marka87/GRAF_MNP/DOKU-STUFF/DOKU WORK/MIMOT Advantage Nadelschlitten-Prüfstand Beschreibung.docx

Um defekte Nadelschlitten zuverlässig reparieren zu können, bedarf es einer Teststation die möglichst automatisiert den montierten Nadelschlitten auf korrekte Funktionalität prüft und Fehlfunktionen detektiert.

# Mechanischer Aufbau

Es wird ein Gehäuse konstruiert das dem Bestückkopf ähneln kann.

Darin sollen eine Bestücknadel, A-Achse und Spielkiller fest verbaut sein.

Auf dieses Gehäuse kann ein beliebiger Nadelschlitten zur Fehlersuche montiert werden.

Dieses Kopfgehäuse soll an einem primitiven aber stabilen Kopfständer montiert sein, mit einer

ebenen Fläche unterhalb der Bestücknadel.

Diese Ebene soll so weit von der Bestücknadel entfernt sein, dass mit aufgesetztem 1er Doppelloch-Tool und komplett ausgefahrener Nadel noch ein Abstand von ca. 5mm zwischen Tool und Kallibrierfläche herrscht.

Durch positionieren diverser Messklötze auf die Kalibrierfläche, können während der Testroutine verschiedene Bestückhöhen simuliert werden.

# Testroutinen

Vor jedem Testdurchlauf sollen die Z- und die A-Achse referenziert werden.

- Die Z-Achse fährt dazu auf den „Nadel-oben-Sensor“.
- Die A-Achse dreht im Uhrzeigersinn auf Anschlag (Überstromerkennung), speichert den Encoderzähler, dreht gegen den Uhrzeigersinn auf Anschlag (Überstromerkennung) und fährt wieder zurück auf den halben zuvor gezählten Encoder-Wert (Referenzposition).

Die Tests sollen zur Fehlersuche über eine kleine PC-Software einzeln ausgeführt werden können und auch als „kombi-Test“ (alle Testroutinen hintereinander) zur Freigabe eines reparierten/überarbeiteten Nadelschlitten.

Generell solle jeder Test 1000 Zyklen durchlaufen um ein aussagekräftiges Ergebnis zu liefern, zumindest hat Mimot auf deren Testprotokoll 1000 Zyklen.

Folgende Tests sollen automatisiert durchgeführt werden können:

## Z-Achse prüfen (Drucksensor, Z-Encoder, NadelOben-Sensor, Zahnstangenspiel, Motorwicklung)

Die Z-Achse wird vor Referenzierung immer mit einer Hochlaufspannung nach oben angesteuert (Nadelhochlaufspannung)

1. Die Z-Achse wird auf Referenz gefahren (Schrittgenaue Positionierung auf Sensor „Nadel oben“) und die Nadelposition auf „0“ gestellt. Schlägt der Referenzlauf fehl, dann Ausgabe einer Fehlermeldung („Nadel-oben-Sensor schaltet nicht“ o.ä.)

Die Bestücknadel soll eine definierte Anzahl Durchläufe, in verschiedenen Geschwindigkeiten hoch und runter gefahren werden. Die Anzahl der Encoderschritte nach unten und oben soll permanent gezählt werden. Nach Abschluss der definierten Anzahl Durchläufe muss die Summe der Encoderschritte mit der Referenzposition noch immer übereinstimmen (Ansonsten sind beim Encoder Schritte verloren gegangen und es besteht ein Problem -> Fehlermeldung „Encoder verliert Schritte, maximale Abweichung der Referenzposition xy Schritte/mm“)

Der Drucksensor wird während dieses Tests permanent überwacht, und darf einen bestimmten, einstellbaren Wert nicht überschreiten, ansonsten Fehlermeldung („Drucksensor löst ohne Messobjekt aus“)

Am Ende des Tests sollen die wichtigsten Daten ausgegeben werden

- Maximale Abweichung des Test 1 (Schritt-Differenz auf Referenzposition)
- Maximale Veränderung des Drucksensors (mV) während Durchgang.
2. Die Z-Achse wird auf Referenz gefahren (Schrittgenaue Positionierung auf Sensor „Nadel oben“) und die Nadelposition auf „0“ gestellt.

Die Bestücknadel soll eine definierte Anzahl Durchläufe, mit definiertem Bestückdruck (variable Ansteuerung des Druckmotors) mit aufgesetztem 1er Tool, die Kalibrierfläche bzw. Messklotz anfahren bis der Drucksensor anspricht.

Während diesem Vorgang wird die Z-Höhe (Encoderzähler) und Drucksensorspannung jedes Durchgangs in eine Tabelle gespeichert.

Bei zu großer Abweichung (einstellbarer Wert) besteht ein Problem -> Fehlermeldung („Abweichung der gemessenen Bestückhöhe xy Schritte/mm“).

~~Um die Abweichung des t~~~~atsächlichen Aufsetzens der Bestücknadel~~ ~~auf dem Me~~~~ssklotz und dem Schalten des Drucksensors zu messen, wird~~ ~~ein Stromkreis von Bestücknadel auf Messklotz gemessen. Die Abweichung der Anzahl Z-Schritte wird ebenfalls in eine Tabelle geschrieben~~ ~~(„Abstand bis Drucksensor anspricht“)~~~~.~~

3. Zahnstangenspiel prüfen.
4. Wicklungswiderstand über Shunt-Messung bei diversen Z-Höhen ermitteln. Min 10R Max. 50R Nominal 20R

## Drucksensor prüfen

Um den Drucksensor bzw. alle mechanischen Teile (Kugellager etc.) die diesen beeinflussen können, zu prüfen, soll folgende Routine durchgeführt werden.

- Die A-Achse wird eine definierte Anzahl Durchläufe mit einer einstellbaren Variation Bestückdruck (ansteuerung des Druckmotor) vom maximalen + Drehwinkel bis zum maximalen – Drehwinkel gefahren.

Während diesem Durchgang werden alle Veränderungen des Drucksesor-Wert in eine Tabelle gespeichert.

- Wicklungswiderstand über Shunt-Messung bei unterschiedlichen Drucksensorwerten ermitteln. Min 10R Max 50R (Generell), Nominal ~25R (Bei Portscape Druckmotor).

# Protokoll

Am Ende der Testroutine soll ein Protokoll der ermittelten Daten exportiert werden können.

Dieses Protokoll soll enthalten

- Datum, Uhrzeit, Name des Prüfers und Seriennummer des Nadelschlitten
- Checkliste aller notwendigen mechanischen Einstellungen vor Test des Nadelschlitten
- Messwerte der Testroutinen

# Hardware-Anforderungen:

## µC:

- Im idealfall einen State of the Art µC wie z.B. STM32F3 oder STM32G4
- Möglichst viel integrierte Peripherie für die Motoren und Sensoren (z.B. Quadratur-Decoder für Encoder auswertung, etc.) um den Programmieraufwand so gering wie möglich zu halten.
- Analoge Ansteuerung der Endstufenkarten (0-5V)
- Analoge Signalmessung (0-5V)

Erstellt: Immler Dominik © Graf Elektronik GmbH Datum: 01.07.2020 WiDok-Nr.: 00000 3 / 3
