marka87/GRAF_MNP/DOKU-STUFF/DOKU WORK/MIMOT Advantage Nadelschlitten-Prüfstand Elektronik.docx

# Elektrischer Aufbau

## DC-Buchse

DC-Buchse für 24V Netzteil. Versorgung aller Komponenten über Steckernetzteil 24V

## 5V Linearregler

7805 Regler (HA7805-K11) mit Eingangs und Ausgangskondensator für die 5V Versorgung aller Komponenten (Arduino/µC, Nadelschlitten etc.)

## 20 Pin IDC Stecker

Stecker für die Verbindung zum Nadelschlitten (über Flachbandkabel)

Pinbelegung

## Verbindung zu STM32 Nucleo Board (STM32G431KBT6) über onboard Debugger (SWD, JTAG)

## µC I/O Zuweisungen

## „Nicht-Gatter“ SN74HC14N

Das Motortreiber-Modul mit dem L298N hat je H-Brücke drei Inputs.

Über den „EnA“ Pin wird das PWM-Signal zugeführt um die Drehzahlsteuerung zu realisieren.

Über die IC-Pins In1 und In2 wird die Kommutierung gesteuert. Um einen µC I/O Pin zu sparen, wird das Signal eines Ausgangspin zu dem „Nicht-Gatter“ geführt, somit haben wir mit einem Ausgangspin am µC dennoch die notwendigen zwei komplementären Signale für die Kommutierung.

# Berechnungen

## Timer für das Encoderposition-Polling

Der Encoder der Z-Achse soll periodisch abgefragt werden um Positionsänderungen zu erfassen.

Berechnung für die Polling-Intervallbestimmung:

MotMaxRpm = 15.100Rpm (Motor Faulhaber 2842S024C)

EncStepPerRot = 500 N/Rot (Encoder go

HEDS 5500 A HEDS 5500 A)

Berechnung der Maximalen Encoder-Impulse pro Sekunde bei voller Drehzahl:

MaxEncStepPerSec= MotMaxRpm/60sec * EncStepPerRot = ~125.830Rpm

Berechnung des maximalen Encoder –Schrittintervall (

MaxEncIntCalc= 1 / MaxEncStepPerSec = 8µs

Unter der Annahme dass der Motor niemals die volle Drehzahl erreichen kann, da er ja eine Last antreiben muss, wird der rechnerische Wert von „MaxEncIntCalc“ auf 10µs aufgerundet.

Es soll also alle 10µs die Encoder-Position abgefragt werden. MaxEncInt = 10µs

Es soll also ein Timer generiert werden, der bei jedem erreichen des „MaxEncInt“ einen Interrupt auslöst.

Berechnung des Prescalers:

Unter der Annahme dass wir einen 8Bit Timer verwenden um einen „Clear Timer on Compare Match“ (CTC) zu erzeugen.

MaxEncInt / (1 / ClkI/O) = 0,00001 / (1 / 16.000.000) = 160cnt

Es wird also kein Prescaler benötigt, da bereits nach 160 Zyklen eine Messung erfolgen soll.

Dies wird durch den CTC Mode (Clear Timer on Compare) realisiert.

Man lässt den Timer nicht überlaufen, sondern setzt diesen Zurück sobald der Timer den Zählerstand aus dem OCR0A Register überlaufen hat.

OCR0A=1xA0 (1b10100000)

## Mechanische Daten

Z-Achsbewegung Strecke pro Motorumdrehung= 18mm

# Messung Encoder

Die Geschwindigkeit des Encoder-Signals bei 24V Ansteuerung des Motors ist ca . 45kHz.

Die Abtastrate sollte drei mal pro Flanke passieren, sprich 6x 45kHz = 2,7MHz (alle 3,7ns)

Erstellt: Immler Dominik © Graf Elektronik GmbH Datum: 01.07.2020 WiDok-Nr.: 00000 3 / 3
