marka87/GRAF_MNP/DOKU-STUFF/DOKU WORK/Prüfbericht MIMOT.PDF

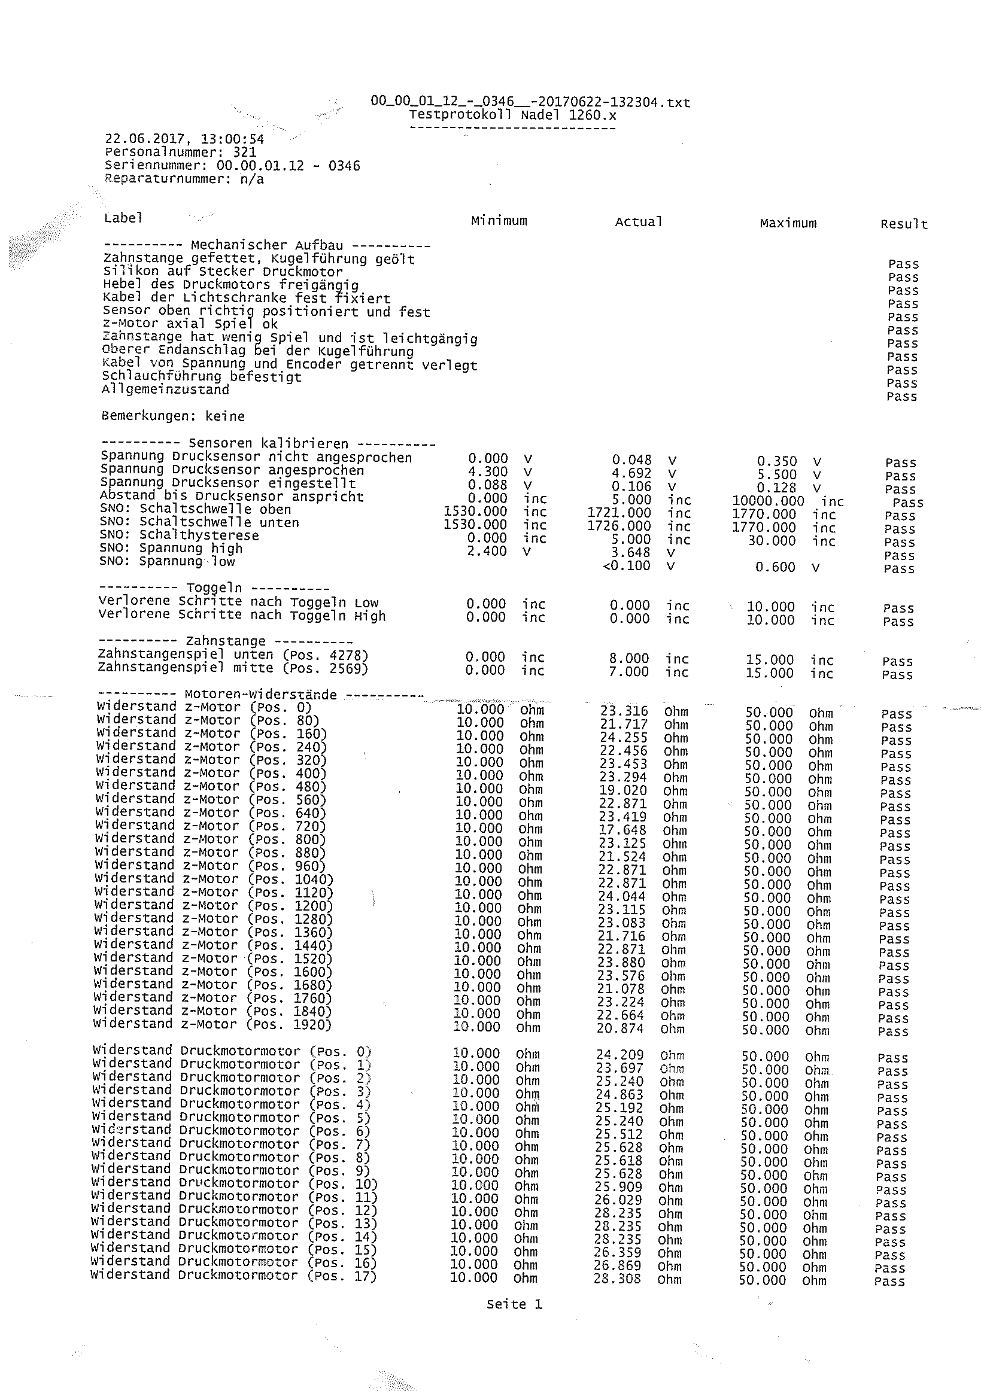
[picture p14: page 1]
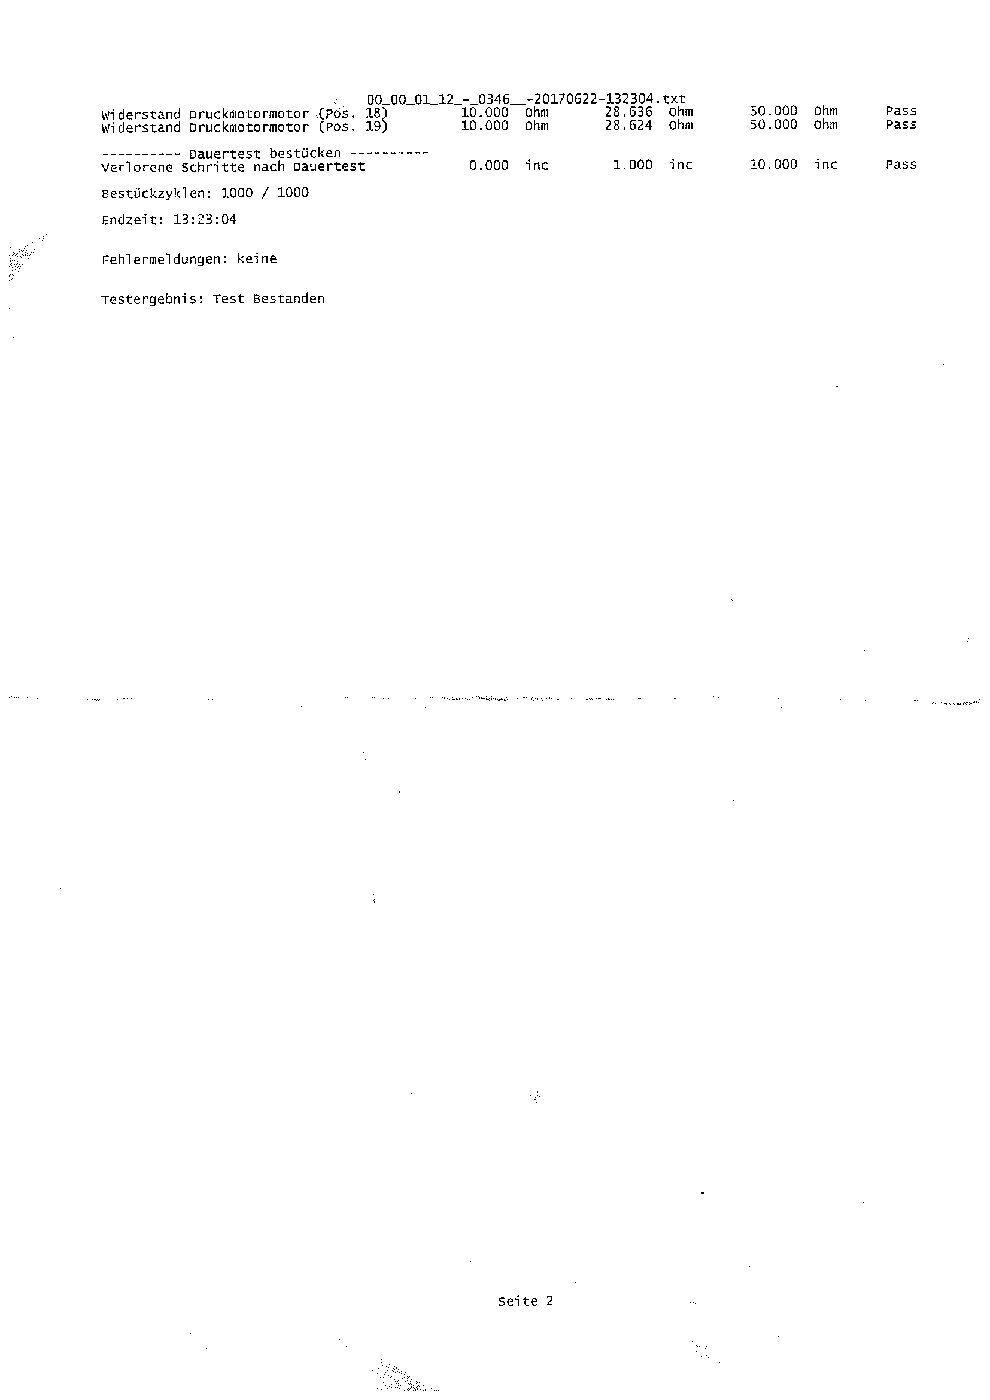
[picture p15: page 2]
