marka87/GRAF_MNP/DOKU-STUFF/2024-11-27 18_06_27-workspace_1.16.1 - GRAF_MNPA_Core_Src_main.c - STM32CubeIDE.png

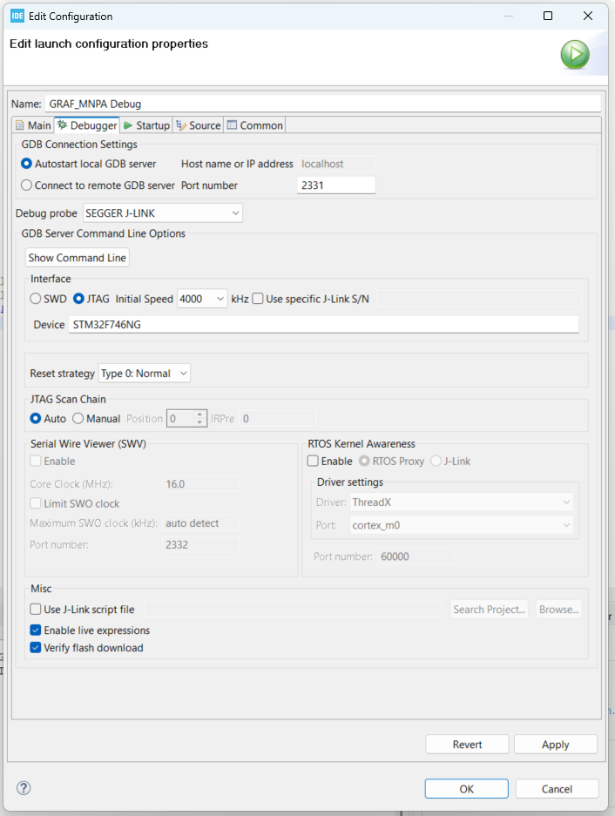
DOKU-STUFF/2024-11-27 18_06_27-workspace_1.16.1 - GRAF_MNPA_Core_Src_main.c - STM32CubeIDE.png
