marka87/GRAF_MNP/DOKU-STUFF/DOKU WORK/Encoder/IMG_3620.jpg

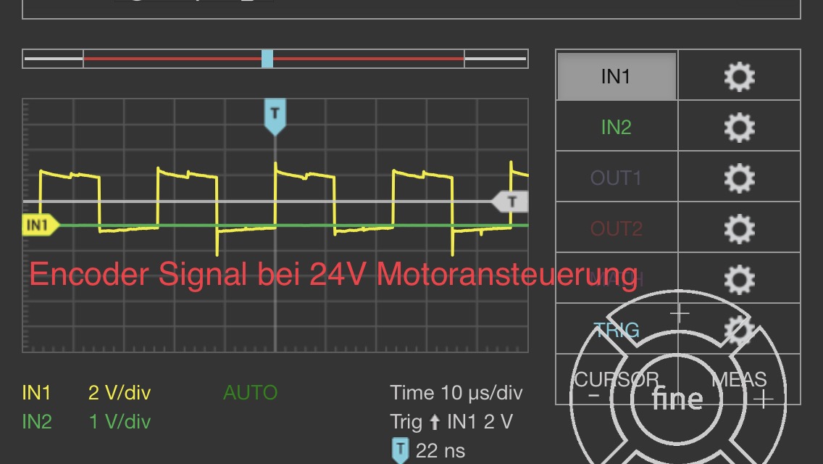
DOKU-STUFF/DOKU WORK/Encoder/IMG_3620.jpg
