marka87/GRAF_MNP/DOKU-STUFF/DOKU WORK/Mimot Endstufen für Ansteuerung/A-Achsen Ansteuerung.sch.jpg

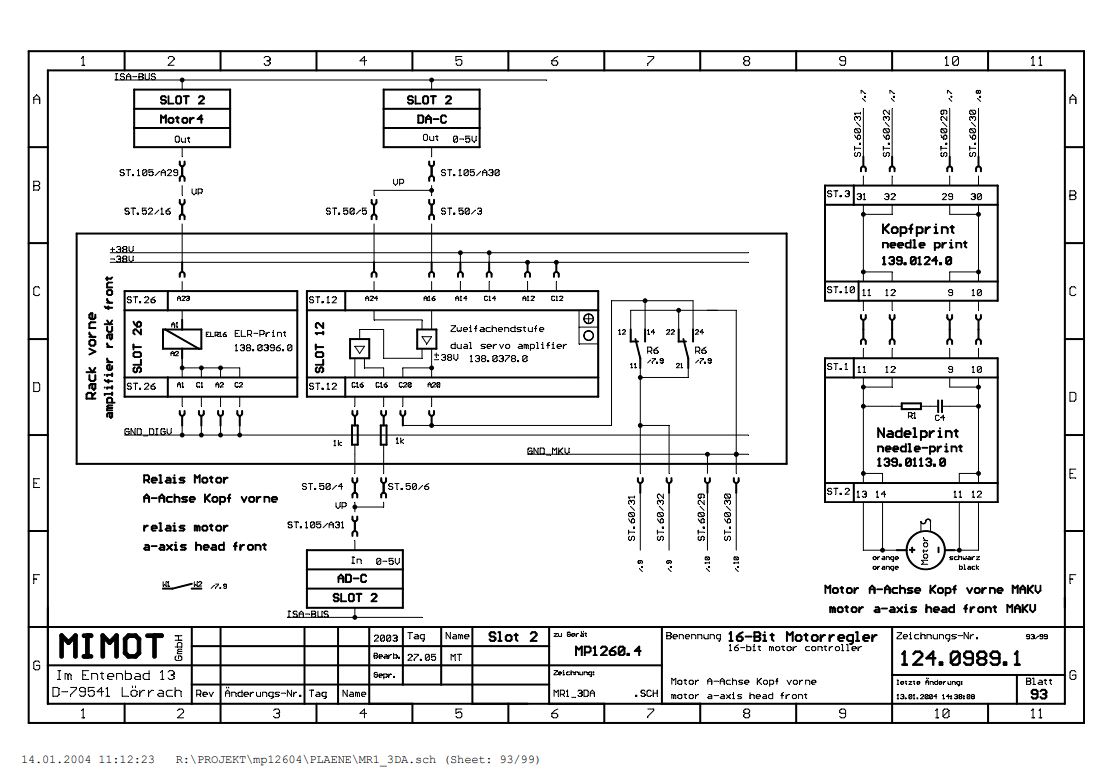
DOKU-STUFF/DOKU WORK/Mimot Endstufen für Ansteuerung/A-Achsen Ansteuerung.sch.jpg
