marka87/GRAF_MNP/DOKU-STUFF/DOKU WORK/Mimot Endstufen für Ansteuerung/Sensor Nadel oben.sch.jpg

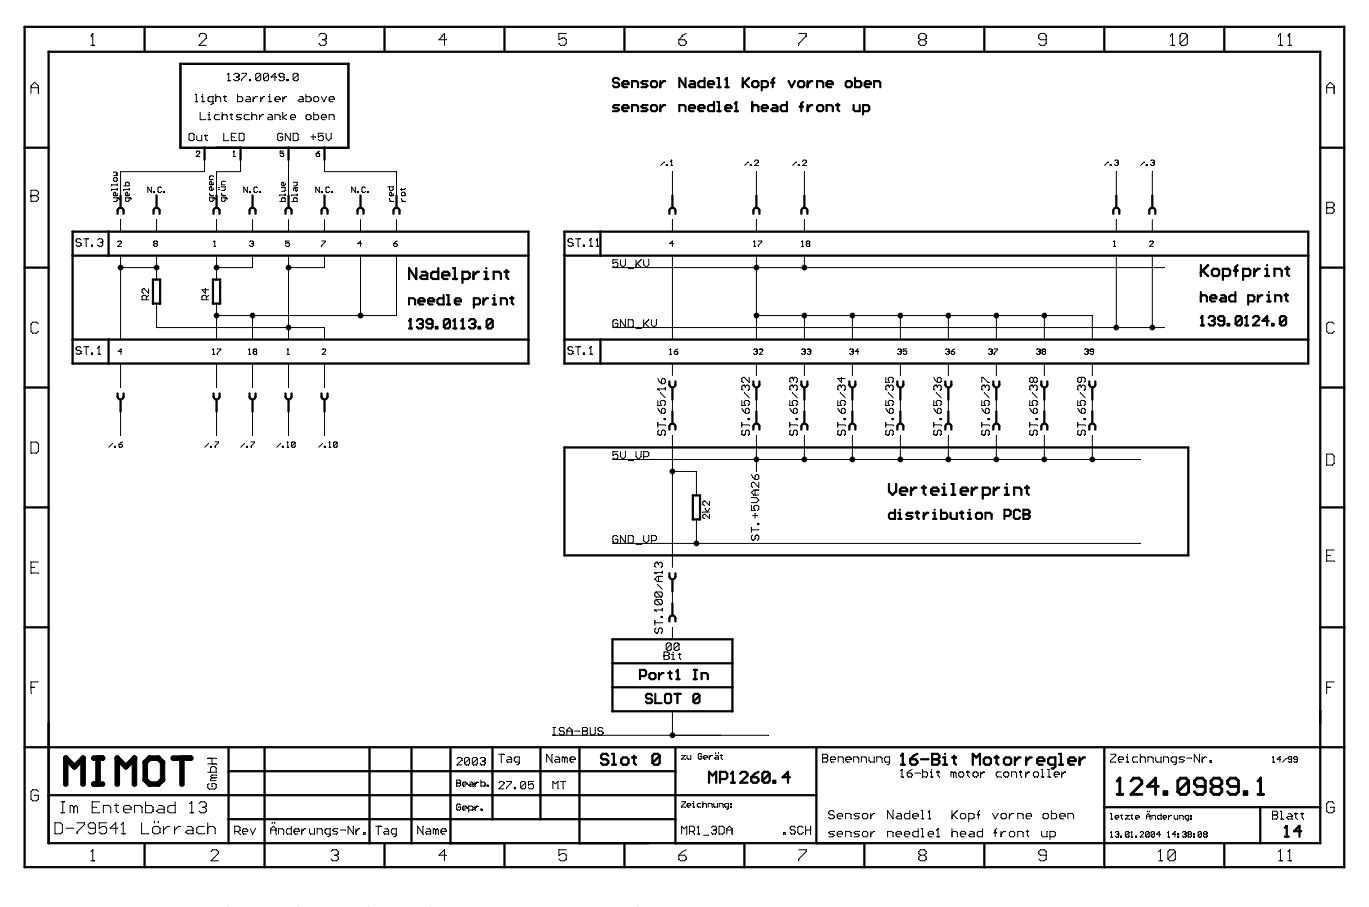
DOKU-STUFF/DOKU WORK/Mimot Endstufen für Ansteuerung/Sensor Nadel oben.sch.jpg
