marka87/GRAF_MNP/DOKU-STUFF/DOKU WORK/Mimot Endstufen für Ansteuerung/Z-Achsen Ansteuerung.sch.jpg

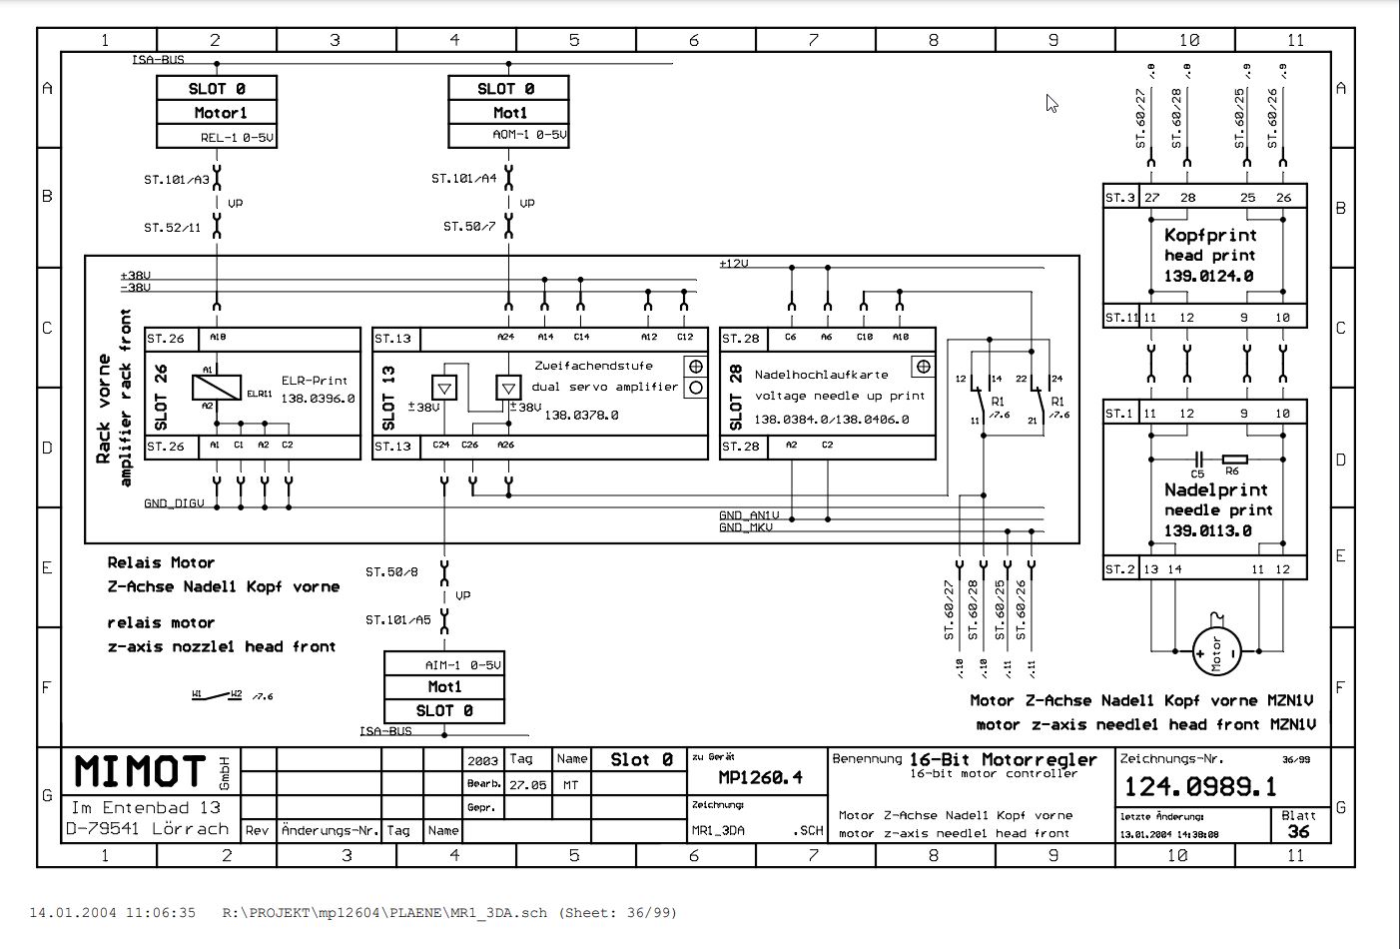
DOKU-STUFF/DOKU WORK/Mimot Endstufen für Ansteuerung/Z-Achsen Ansteuerung.sch.jpg
