marka87/GRAF_MNP/DOKU-STUFF/DOKU WORK/Z-Achsenmotor/2021-03-19 11_36_07-2842S024C Faulhaber Motor _ 2842...C Faulhaber _ DC Kleinstmotoren Faulhaber _ G.jpg

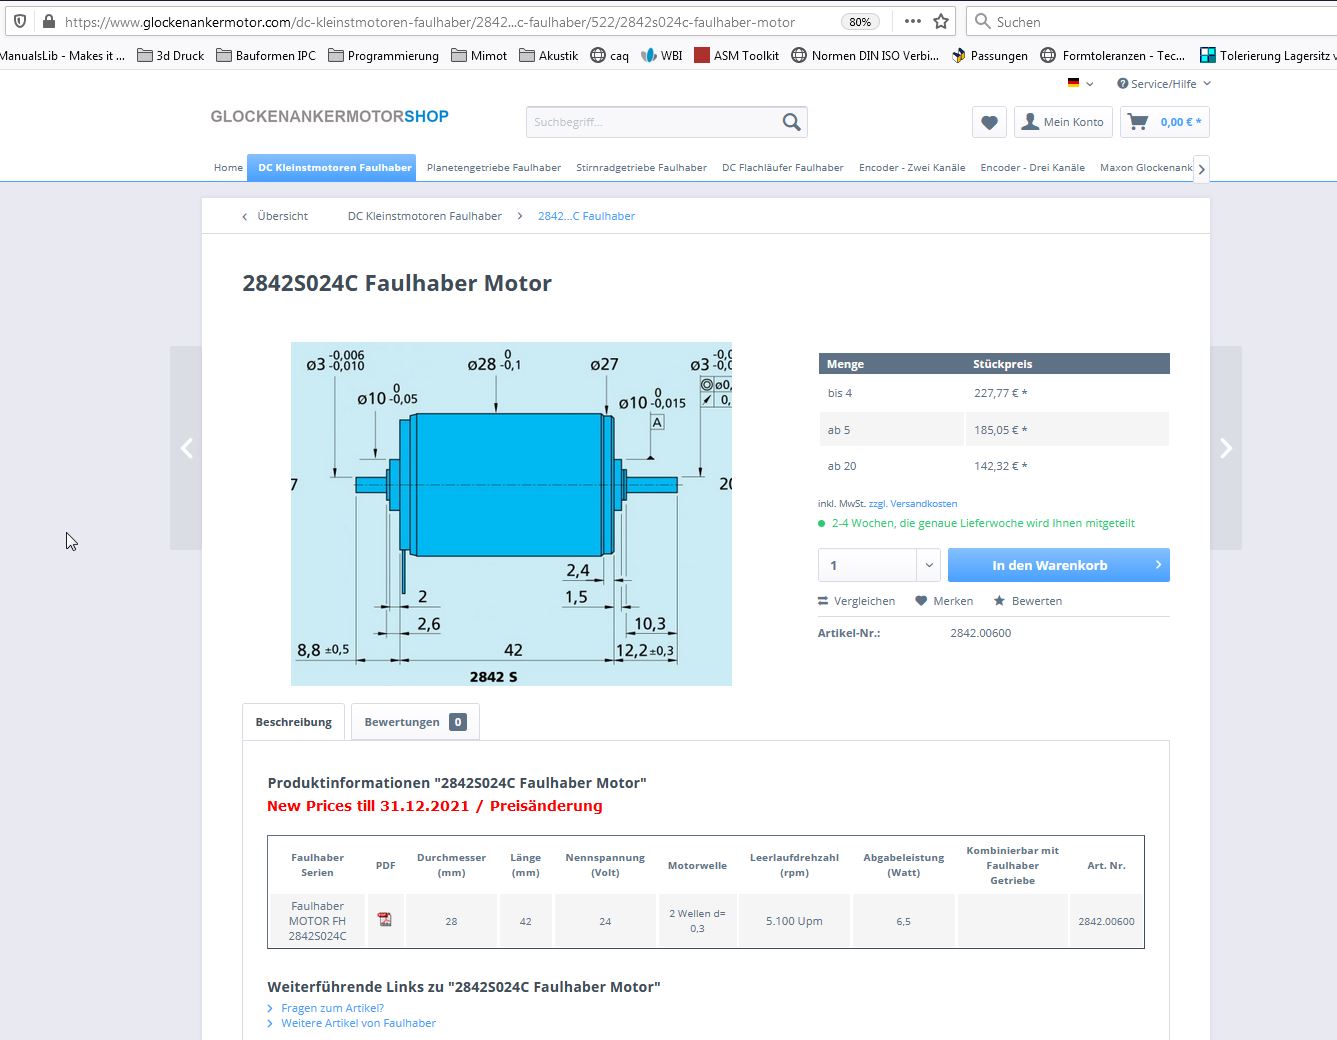
DOKU-STUFF/DOKU WORK/Z-Achsenmotor/2021-03-19 11_36_07-2842S024C Faulhaber Motor _ 2842...C Faulhaber _ DC Kleinstmotoren Faulhaber _ G.jpg
