marka87/GRAF_MNP/DOKU-STUFF/DOKU/usb-c.jpg

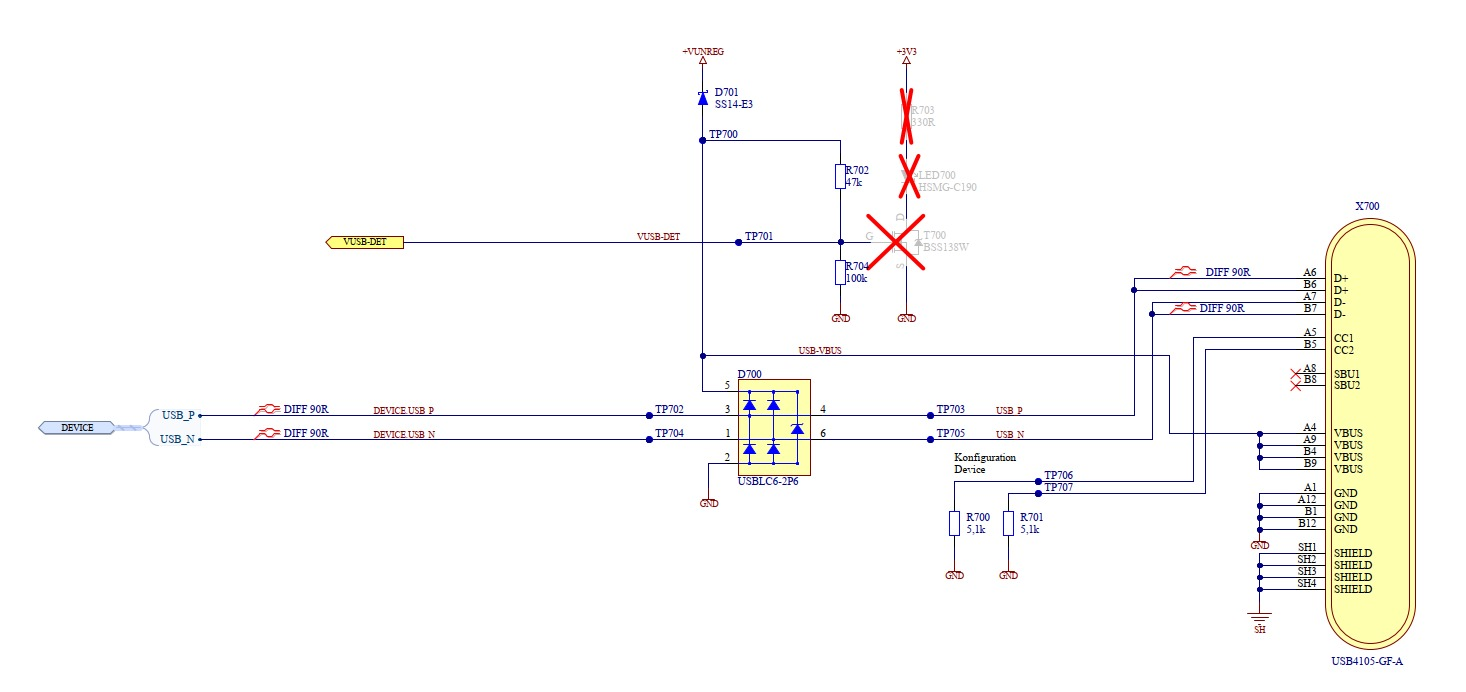
DOKU-STUFF/DOKU/usb-c.jpg
