marka87/GRAF_MNP/DOKU-STUFF/FOTO/START/IMG_4298.JPEG

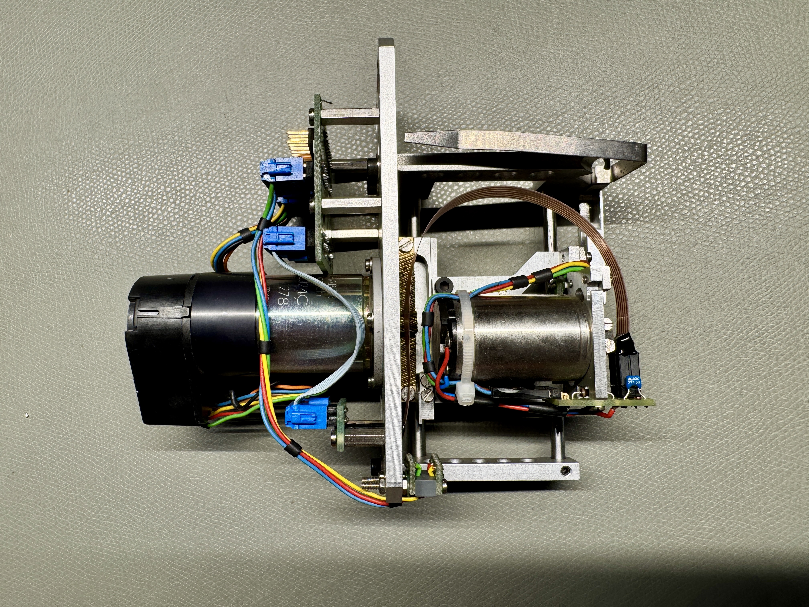
DOKU-STUFF/FOTO/START/IMG_4298.JPEG
