marka87/GRAF_MNP/Elektronik/Powersupply/Download_STEP_971060321 (rev1).stp

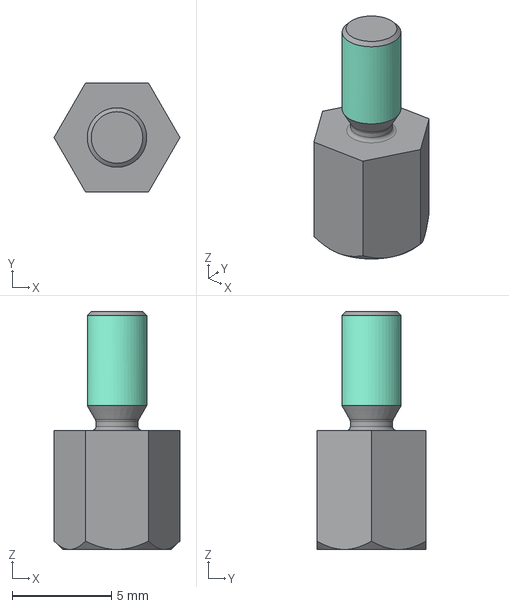
[picture p33: CAD file, 2024-10-14]
Elektronik/Powersupply/Download_STEP_971060321 (rev1).stp
6.35 x 5.50 x 12.0 mm
