marka87/GRAF_MNP/Elektronik/Powersupply/RPS-60.stp

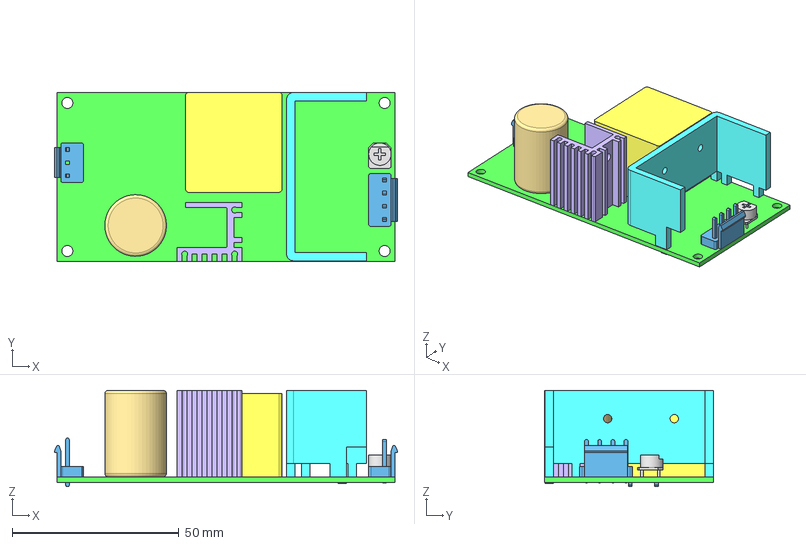
[picture p34: CAD file, 2024-10-14]
Elektronik/Powersupply/RPS-60.stp
103.0 x 50.8 x 28.9 mm
PCB
CN1
PIN_CPY
PIN_CPY_CPY
JS-1120-04
C5
HS-168
HS-172
T1
VR
