marka87/GRAF_MNP/Elektronik/Powersupply/Netzteilprint-Schutzgehäuse.STEP

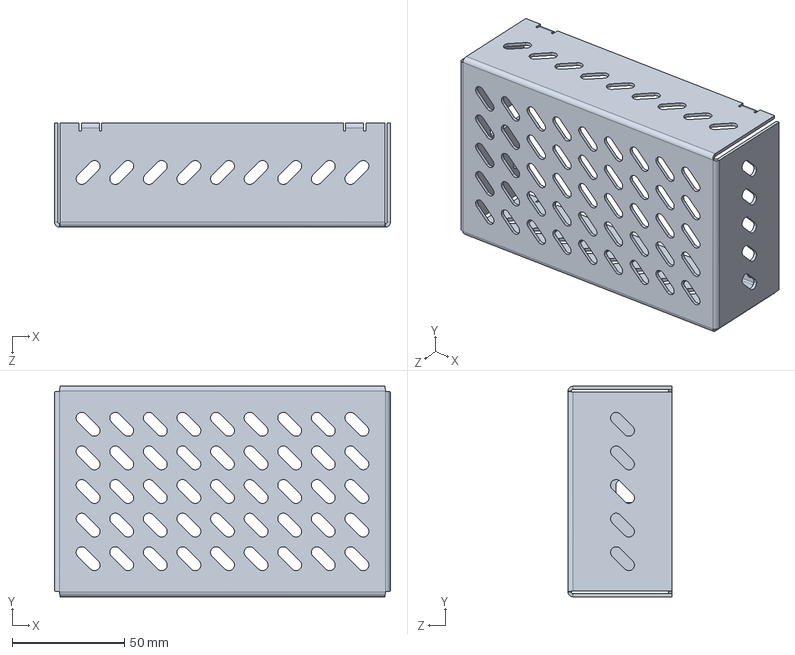
[picture p35: CAD file, 2024-10-14]
Elektronik/Powersupply/Netzteilprint-Schutzgehäuse.STEP
150.0 x 94.0 x 46.5 mm
