marka87/GRAF_MNP/Elektronik/Controller/Outputs/[GRAF-MNP_1.0]/Gerber/[GRAF-MNP_1.0] PCB-SPEC.PDF

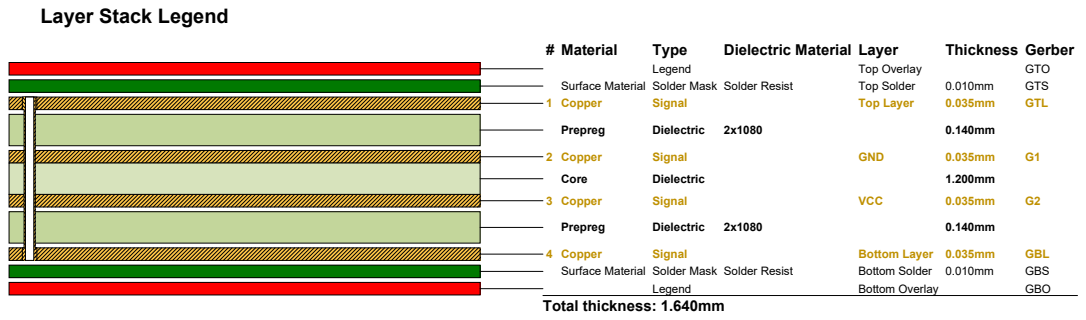
[picture p36: page 1]

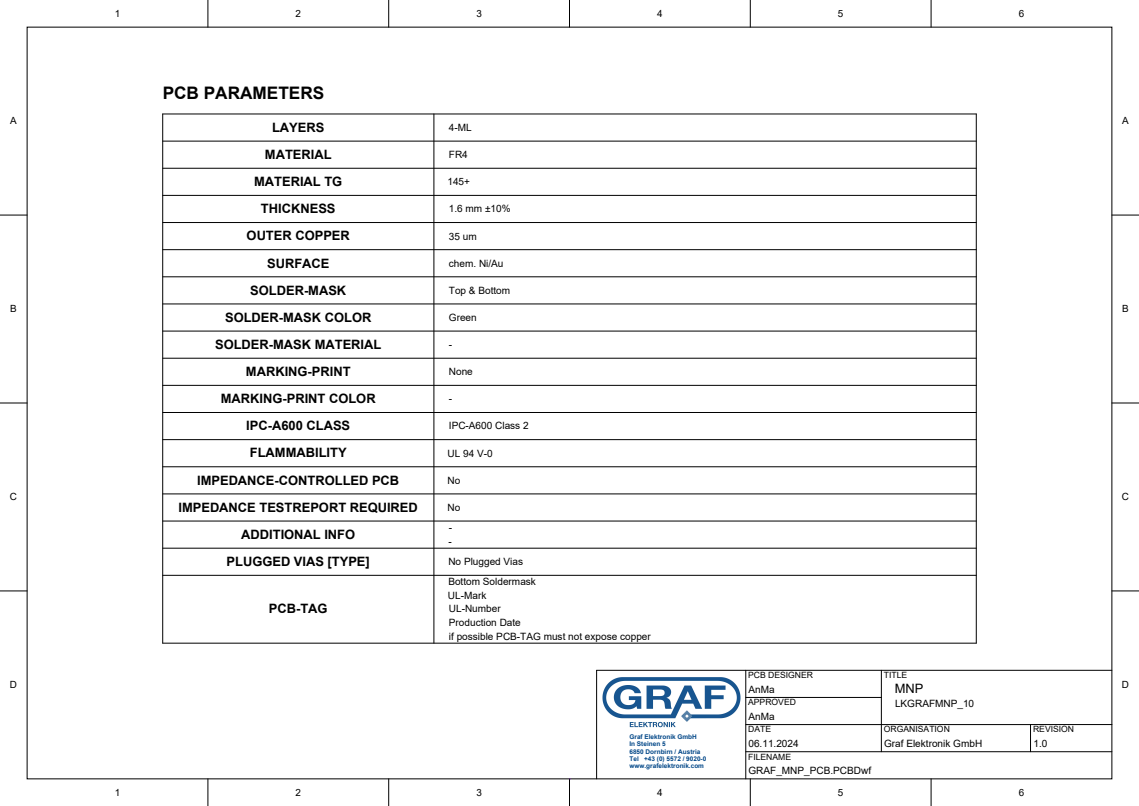
[picture p37: page 2]

LAYERS | 4-ML
MATERIAL | FR4
MATERIAL TG | 145+

THICKNESS | 1.6 mm ±10%
OUTER COPPER | 35 um

SURFACE | chem. Ni/Au
SOLDER-MASK | Top & Bottom
SOLDER-MASK COLOR | Green

SOLDER-MASK MATERIAL | -
MARKING-PRINT | None
MARKING-PRINT COLOR | -

IPC-A600 CLASS | IPC-A600 Class 2
FLAMMABILITY | UL 94 V-0

IMPEDANCE-CONTROLLED PCB | No

IMPEDANCE TESTREPORT REQUIRED | No

ADDITIONAL INFO | --

PLUGGED VIAS [TYPE] | No Plugged Vias
PCB-TAG | Bottom Soldermask UL-Mark UL-Number Production Date if possible PCB-TAG must not expose copper

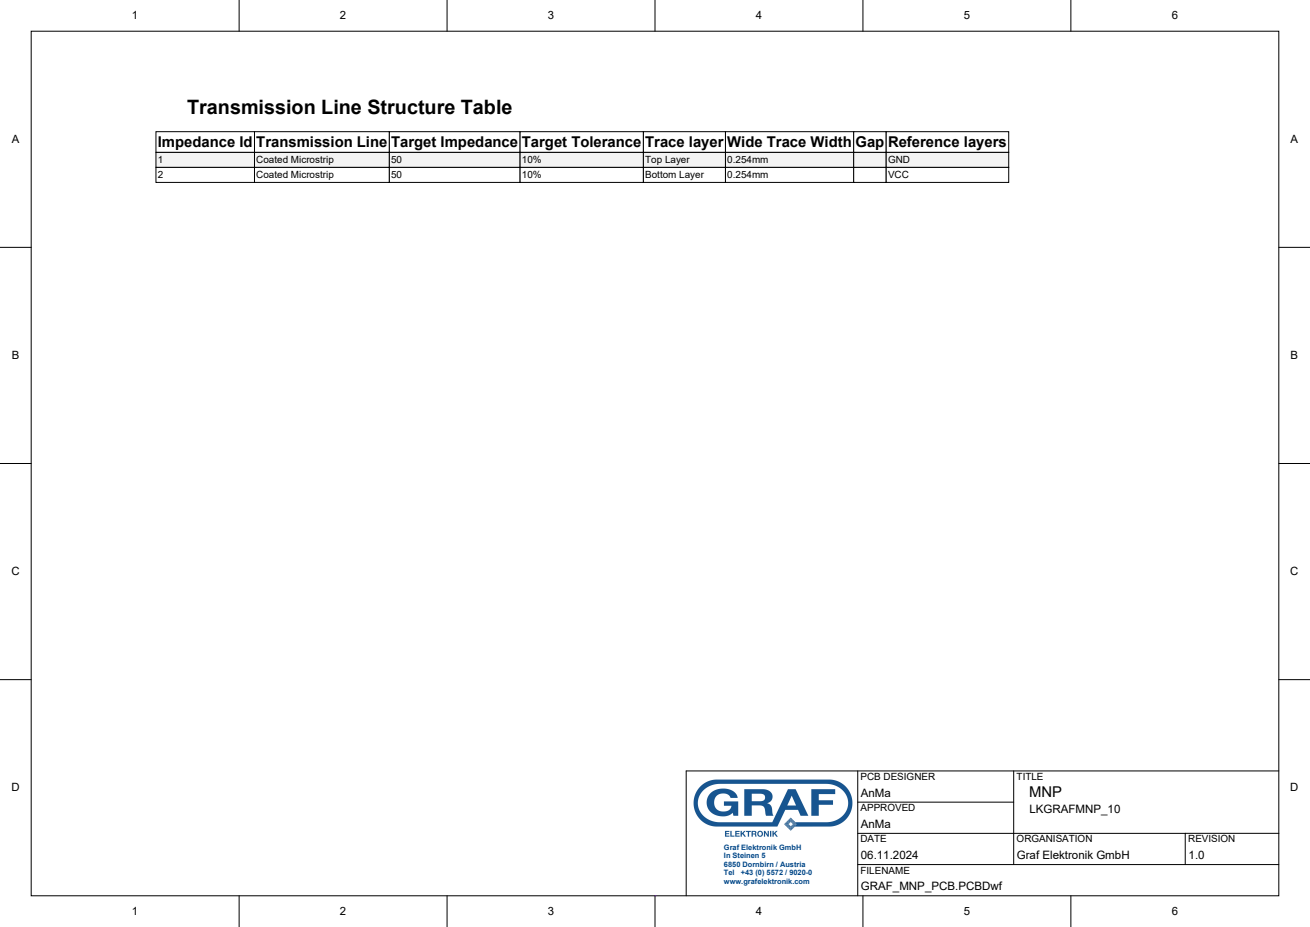
[picture p38: page 3]

Transmission Line Structure Table

Impedance Id | Transmission Line | Target Impedance | Target Tolerance | Trace layer | Wide Trace Width | Gap Reference layers
1 | Coated Microstrip | 50 | 10% | Top Layer | 0.254mm | | GND
2 | Coated Microstrip | 50 | 10% | Bottom Layer | 0.254mm | | VCC

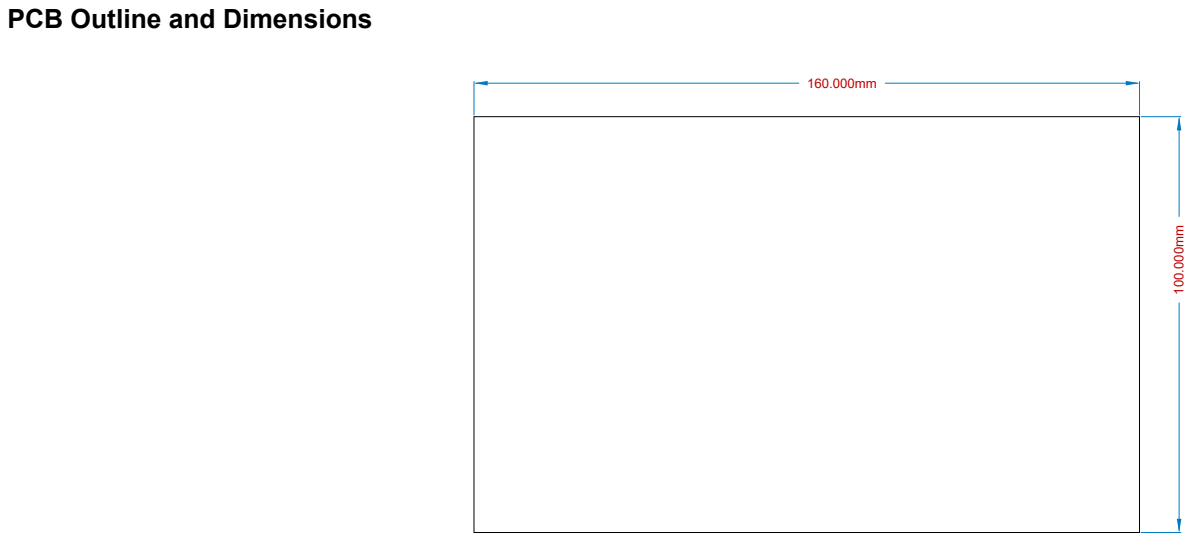
[picture p39: page 4]

PCB Outline and Dimensions
