marka87/GRAF_MNP/DOKU-STUFF/DOKU WORK/Mimot Endstufen für Ansteuerung/Endstufe-Vierfach-138-0374-1.pdf

47k 3k3 270R | 470R 470R
Q17 | 1 2 R⁷³

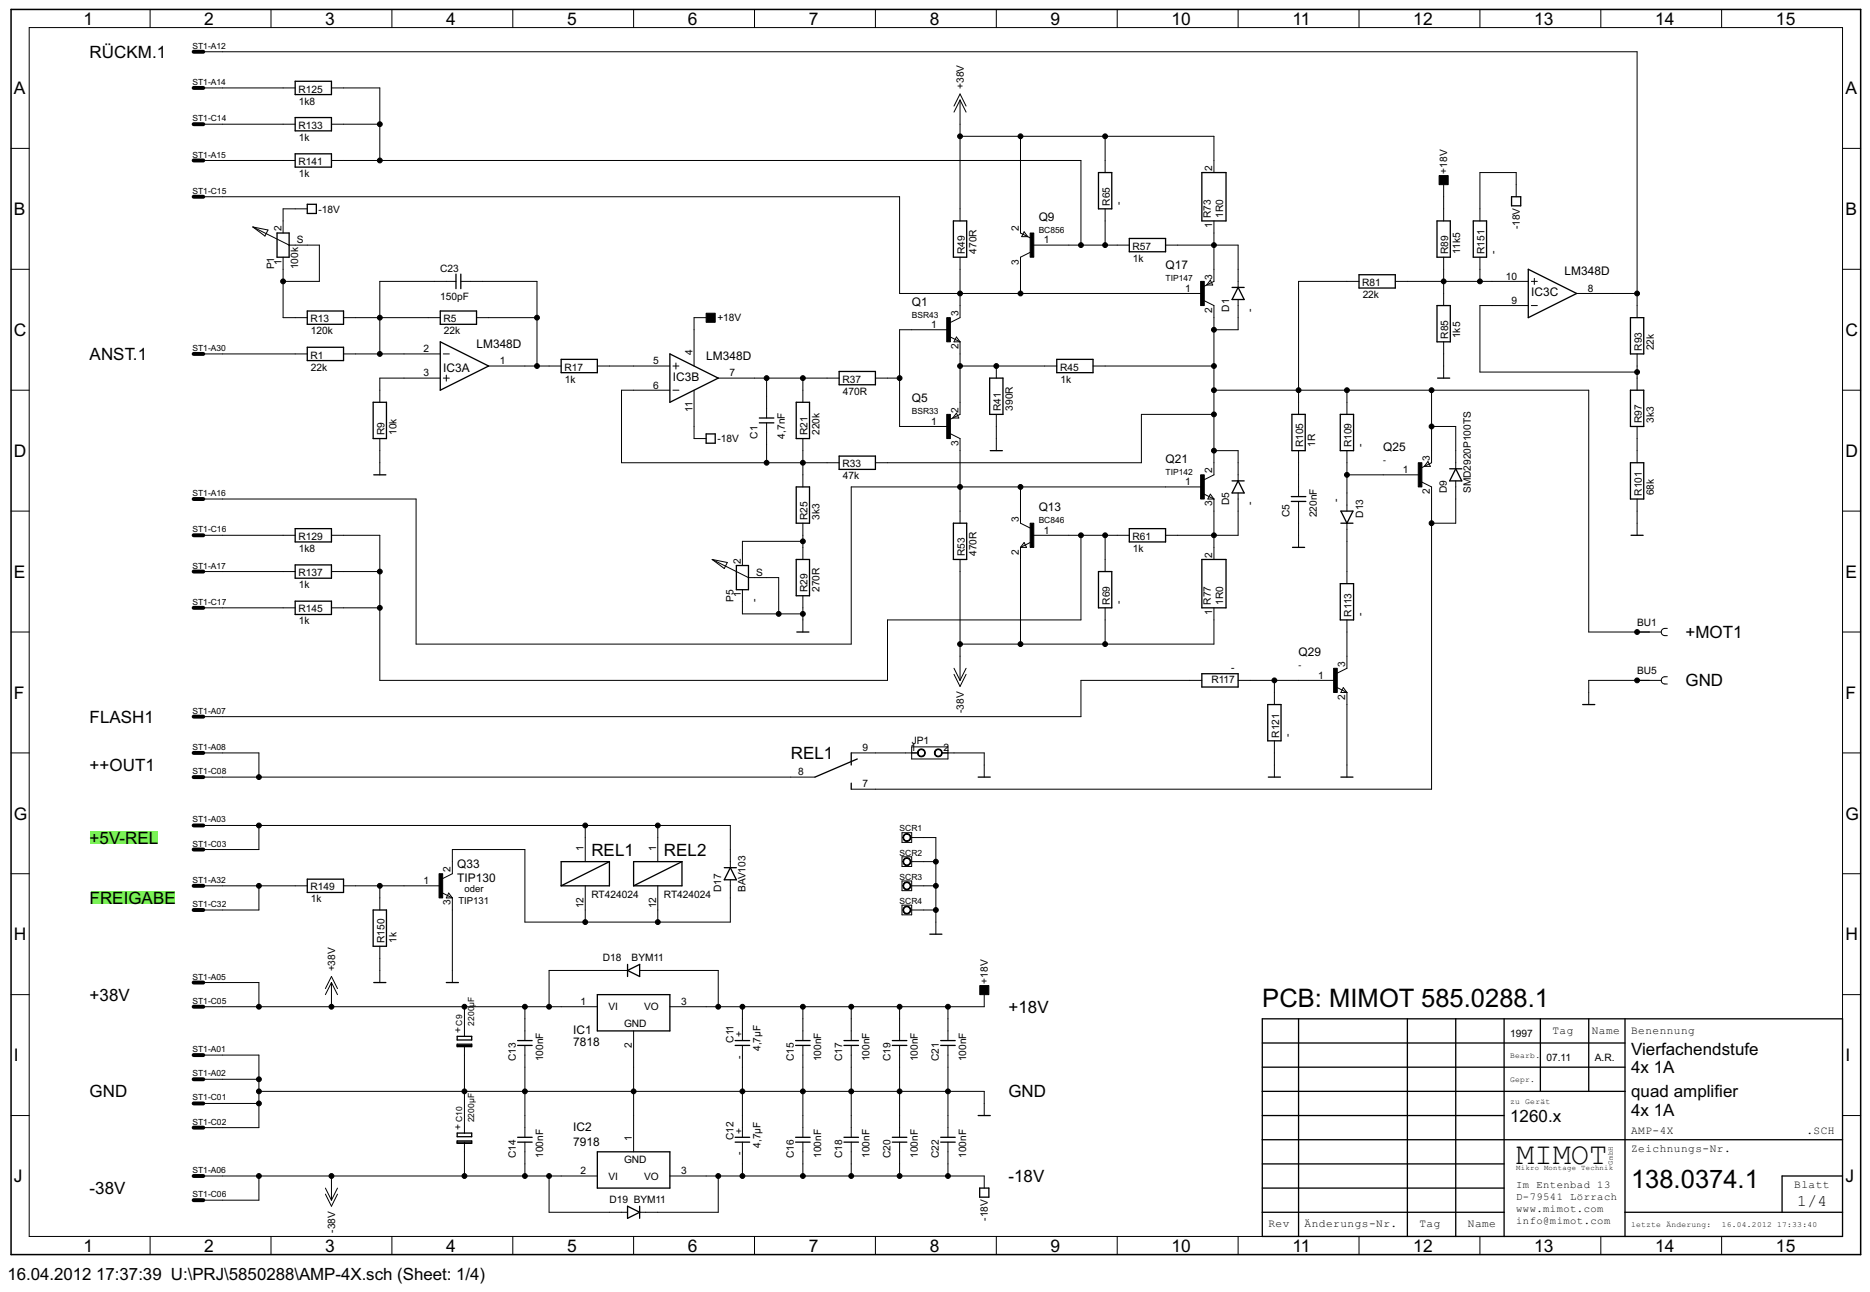
[picture p40: page 1]

1997 | | | Benennung Vierfachendstufe quad amplifier 4x 1A AMP-4X

Gepr. Bearb. | Tag | Name

zu Gerät

info@mimot.com MIMOT Mikro Montage Technik Im Entenbad 13 D-79541 Lörrach www.mimot.com | .SCH GmbH Zeichnungs-Nr.

Rev | Änderungs-Nr. | Tag | Name | | letzte Änderung: 16.04.2012 17:33:40

16.04.2012 17:37:39 U:\PRJ\5850288\AMP-4X.sch (Sheet: 1/4)

47k 3k3 270R | 470R 470R
Q18 | 1 2 R⁷⁴

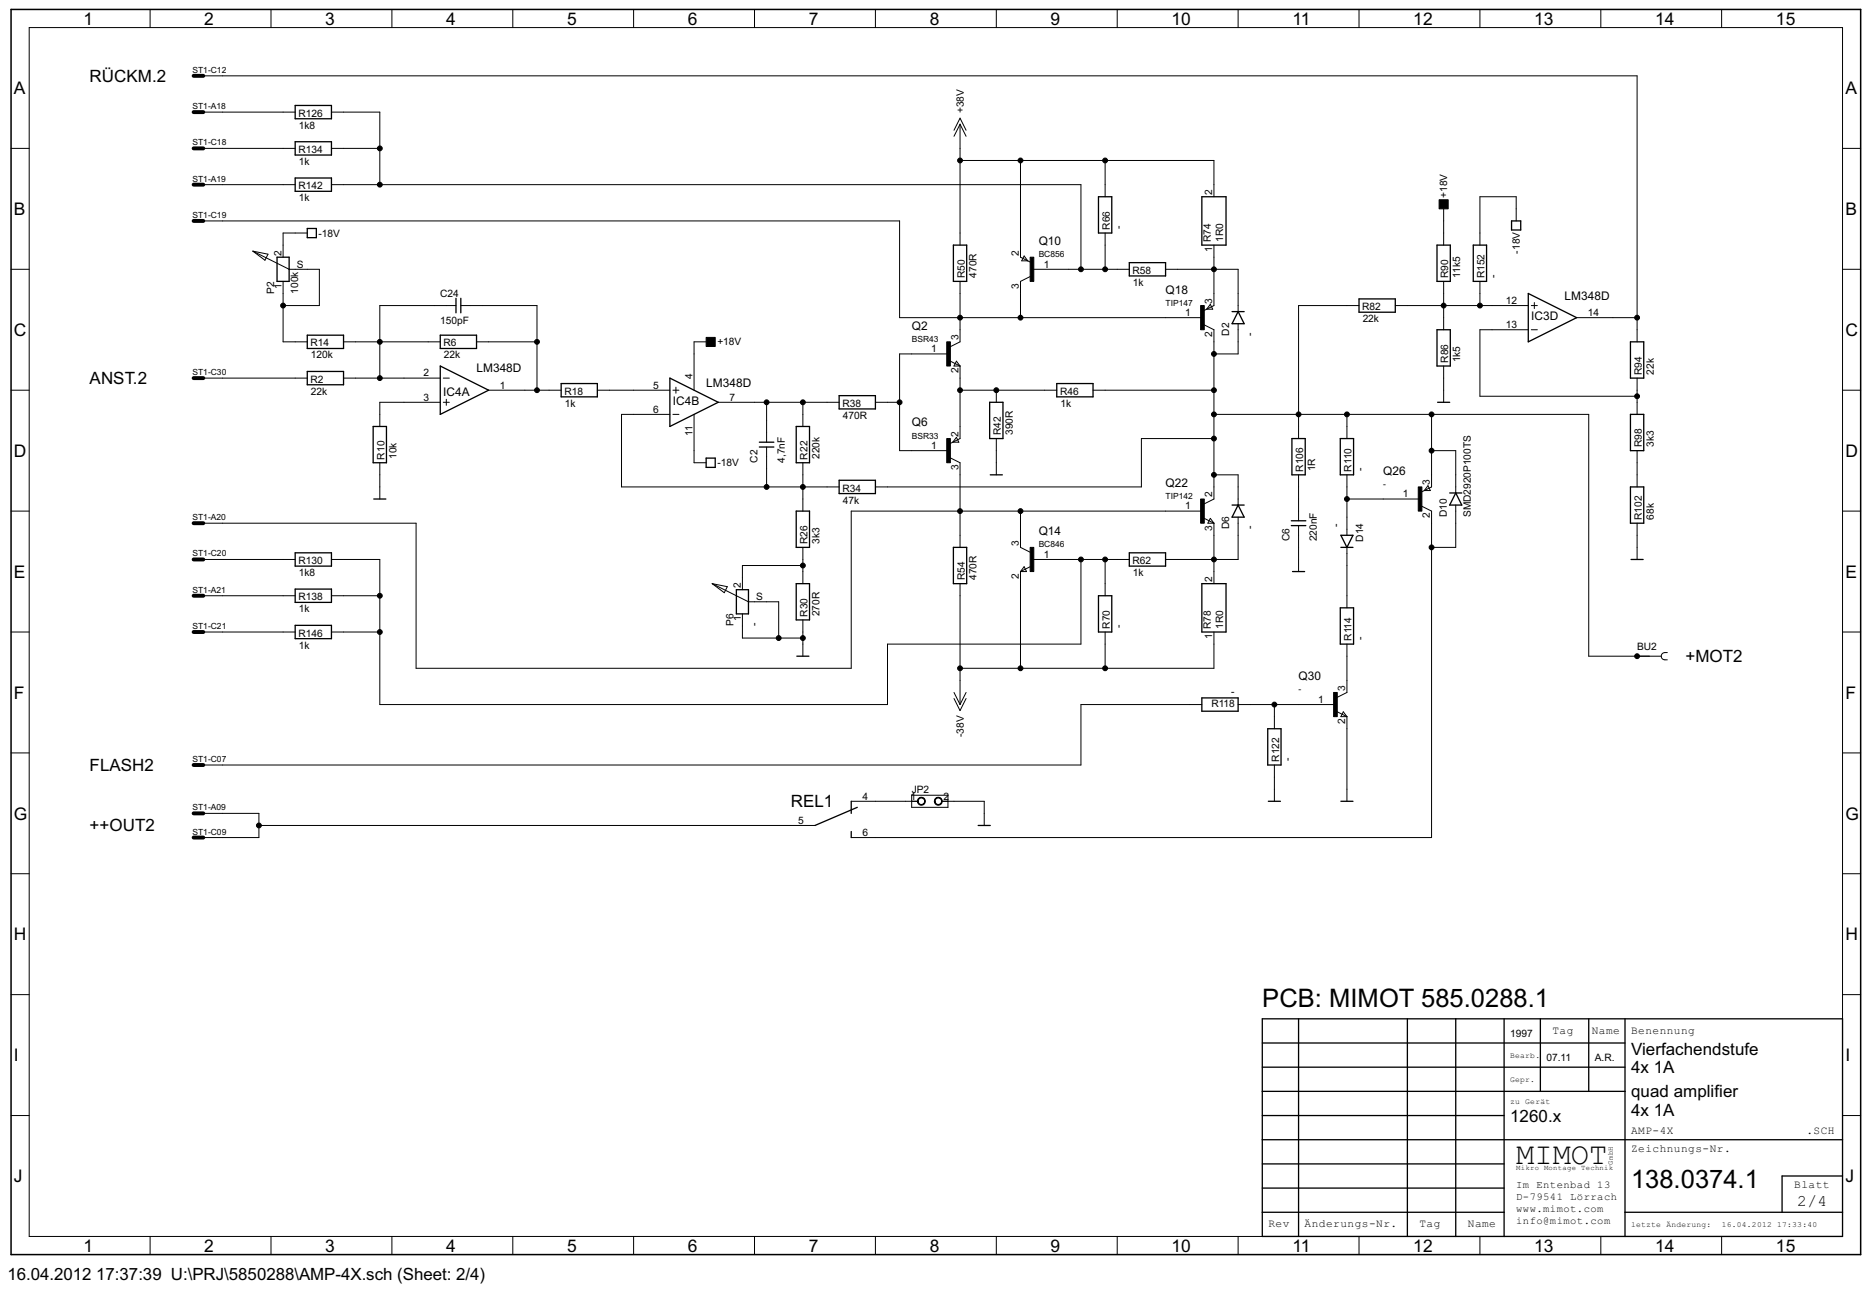
[picture p41: page 2]

1997 | | | Benennung Vierfachendstufe 4x 1A quad amplifier 4x 1A AMP-4X

Gepr. Bearb. | Tag | Name

zu Gerät

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

Rev | Änderungs-Nr. | Tag | Name | | letzte Änderung: 16.04.2012 17:33:40

16.04.2012 17:37:39 U:\PRJ\5850288\AMP-4X.sch (Sheet: 2/4)

16.04.2012 17:37:39 U:\PRJ\5850288\AMP-4X.sch (Sheet: 3/4) ¹⁰⁰k | 10k
47k 3k3 270R | 470R 470R

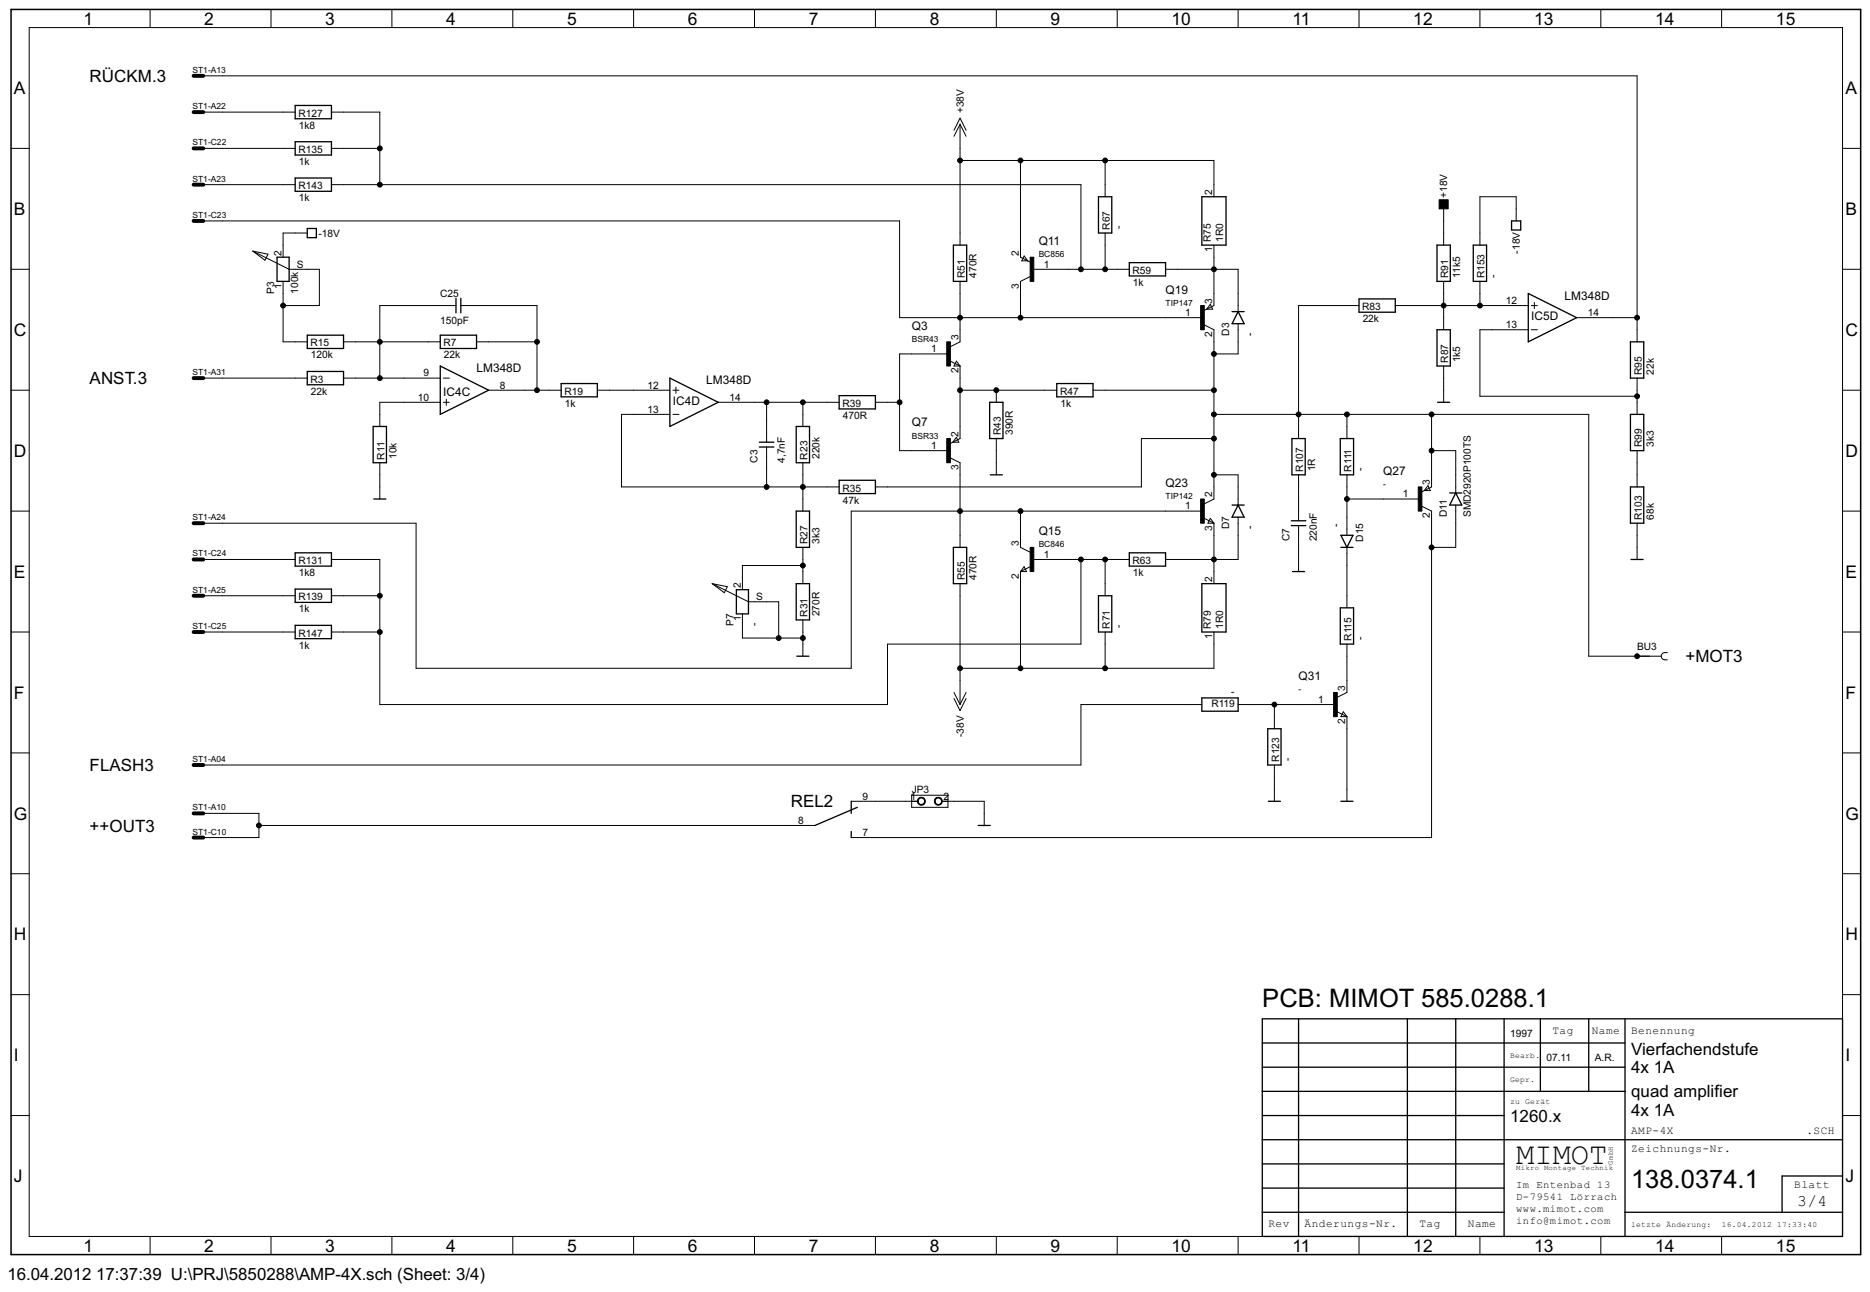
[picture p42: page 3]

1997 | | | Benennung Vierfachendstufe 4x 1A quad amplifier 4x 1A AMP-4X

Gepr. Bearb. | Tag | Name

zu Gerät

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

Rev | Änderungs-Nr. | Tag | Name | | letzte Änderung: 16.04.2012 17:33:40

16.04.2012 17:37:39 U:\PRJ\5850288\AMP-4X.sch (Sheet: 4/4) ¹⁰⁰k | 10k
47k 3k3 270R | 470R 470R

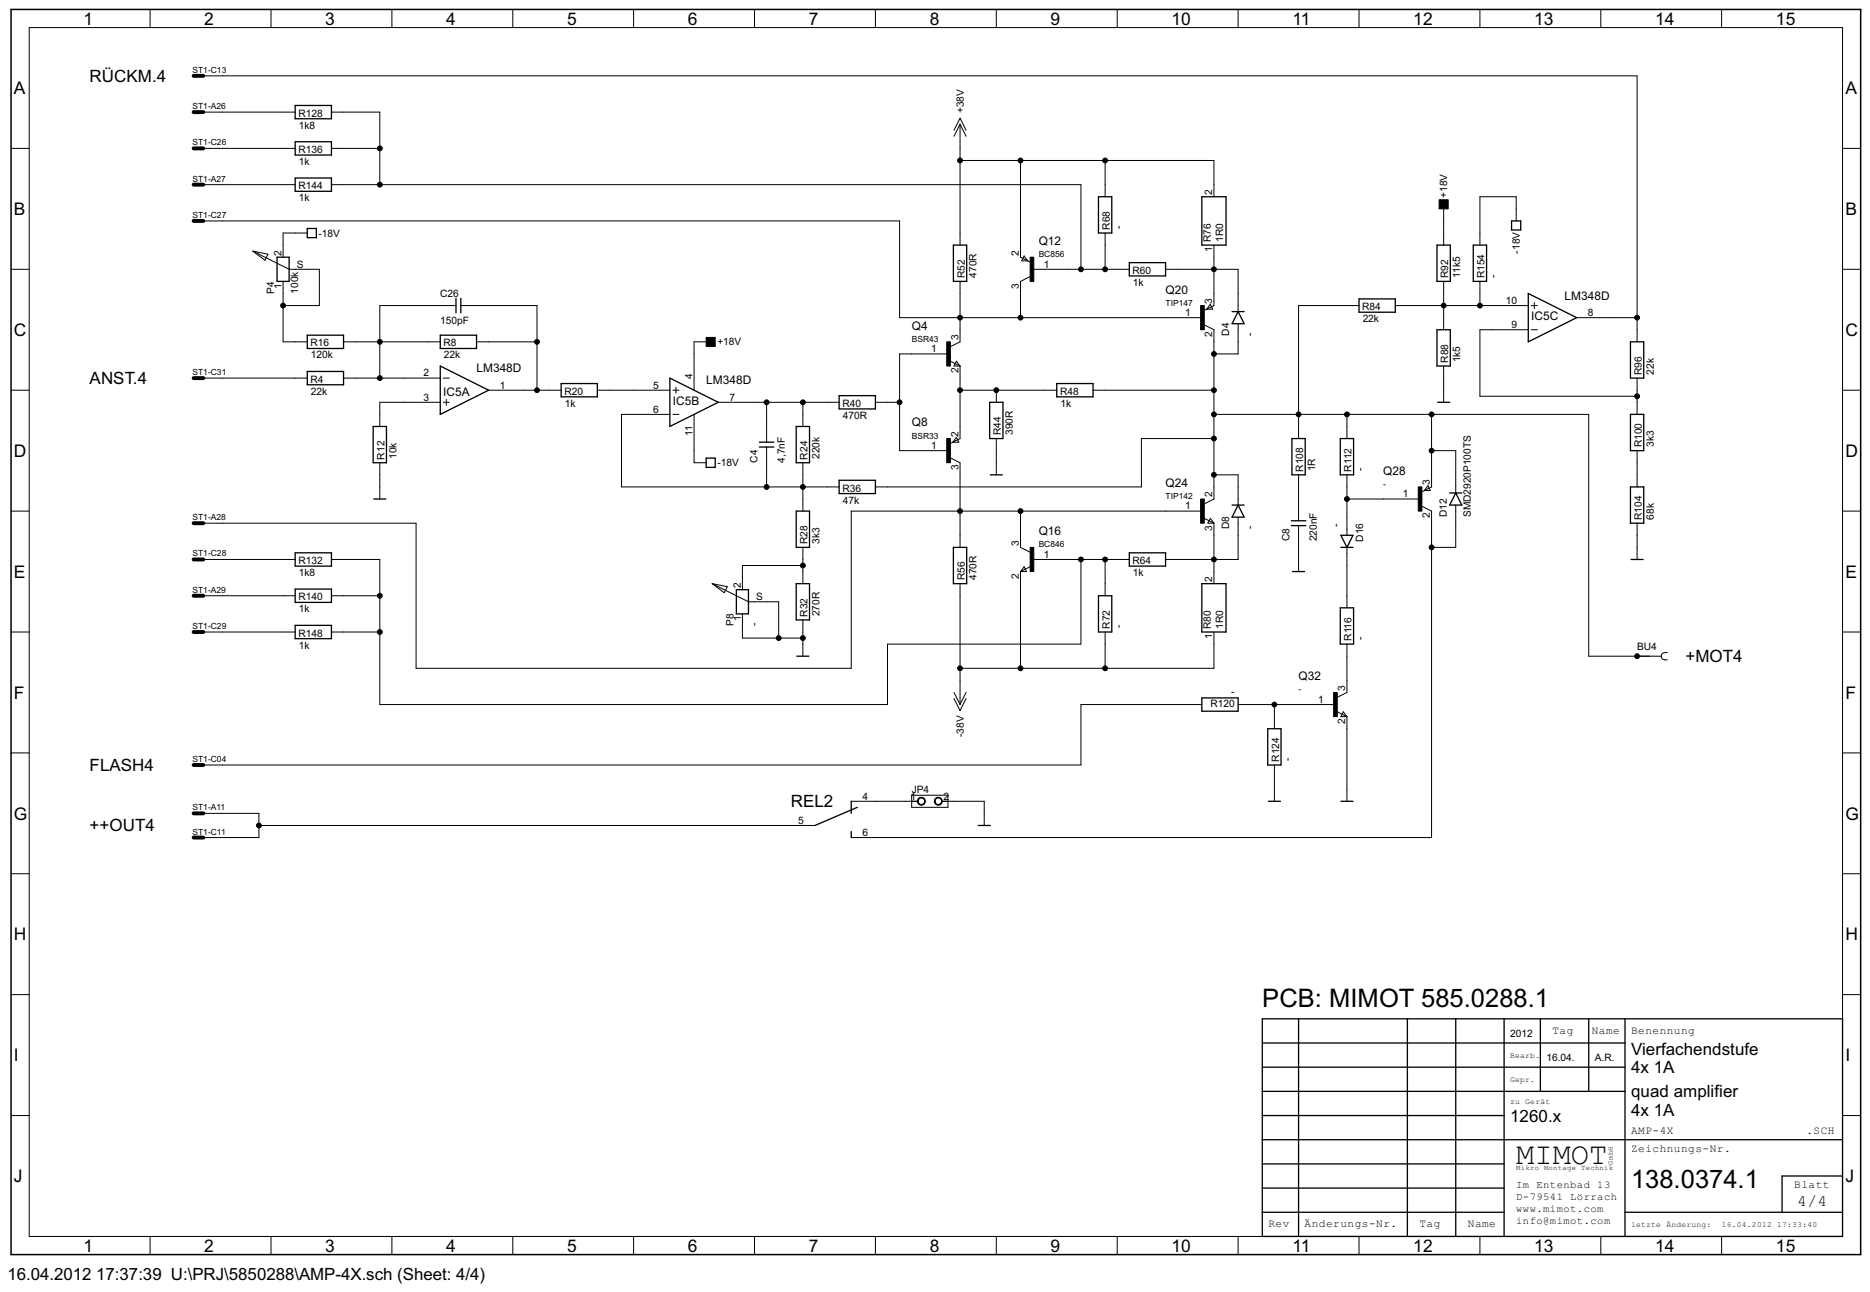
[picture p43: page 4]

2012 | | | Benennung Vierfachendstufe 4x 1A quad amplifier 4x 1A AMP-4X

Gepr. Bearb. | Tag | Name

zu Gerät

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

Rev | Änderungs-Nr. | Tag | Name | | letzte Änderung: 16.04.2012 17:33:40

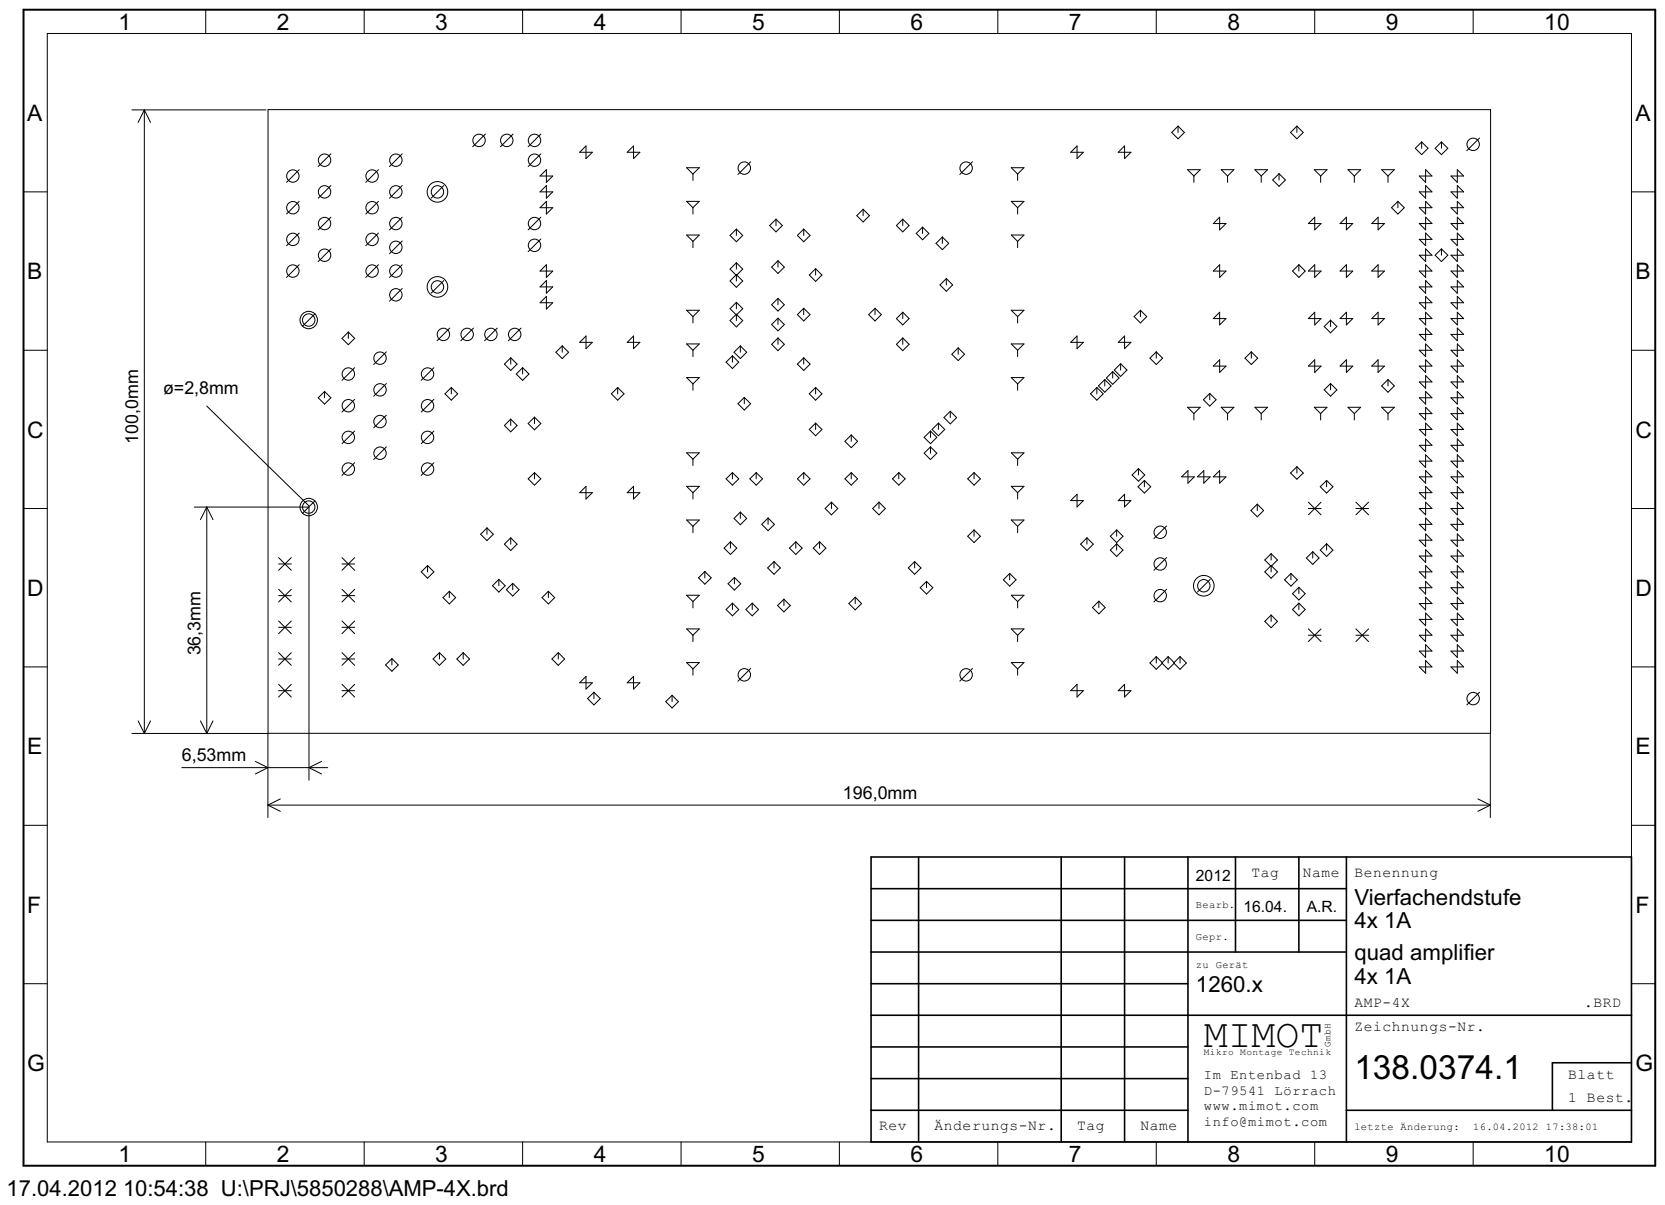
[picture p44: page 5]
ø=2,8mm 36,3mm ¹⁰⁰,0mm; Blatt; 1 Best.

2012 | | | Benennung Vierfachendstufe 4x 1A quad amplifier 4x 1A AMP-4X .BRD

Gepr. Bearb. | Tag 16.04. A.R. | Name

zu Gerät 1260.x

info@mimot.com MIMOT Mikro Montage TechnikGmbH Im Entenbad 13 D-79541 Lörrach www.mimot.com | Zeichnungs-Nr.

Rev | Änderungs-Nr. | Tag | Name | | letzte Änderung: 16.04.2012 17:38:01

17.04.2012 10:54:38 U:\PRJ\5850288\AMP-4X.brd

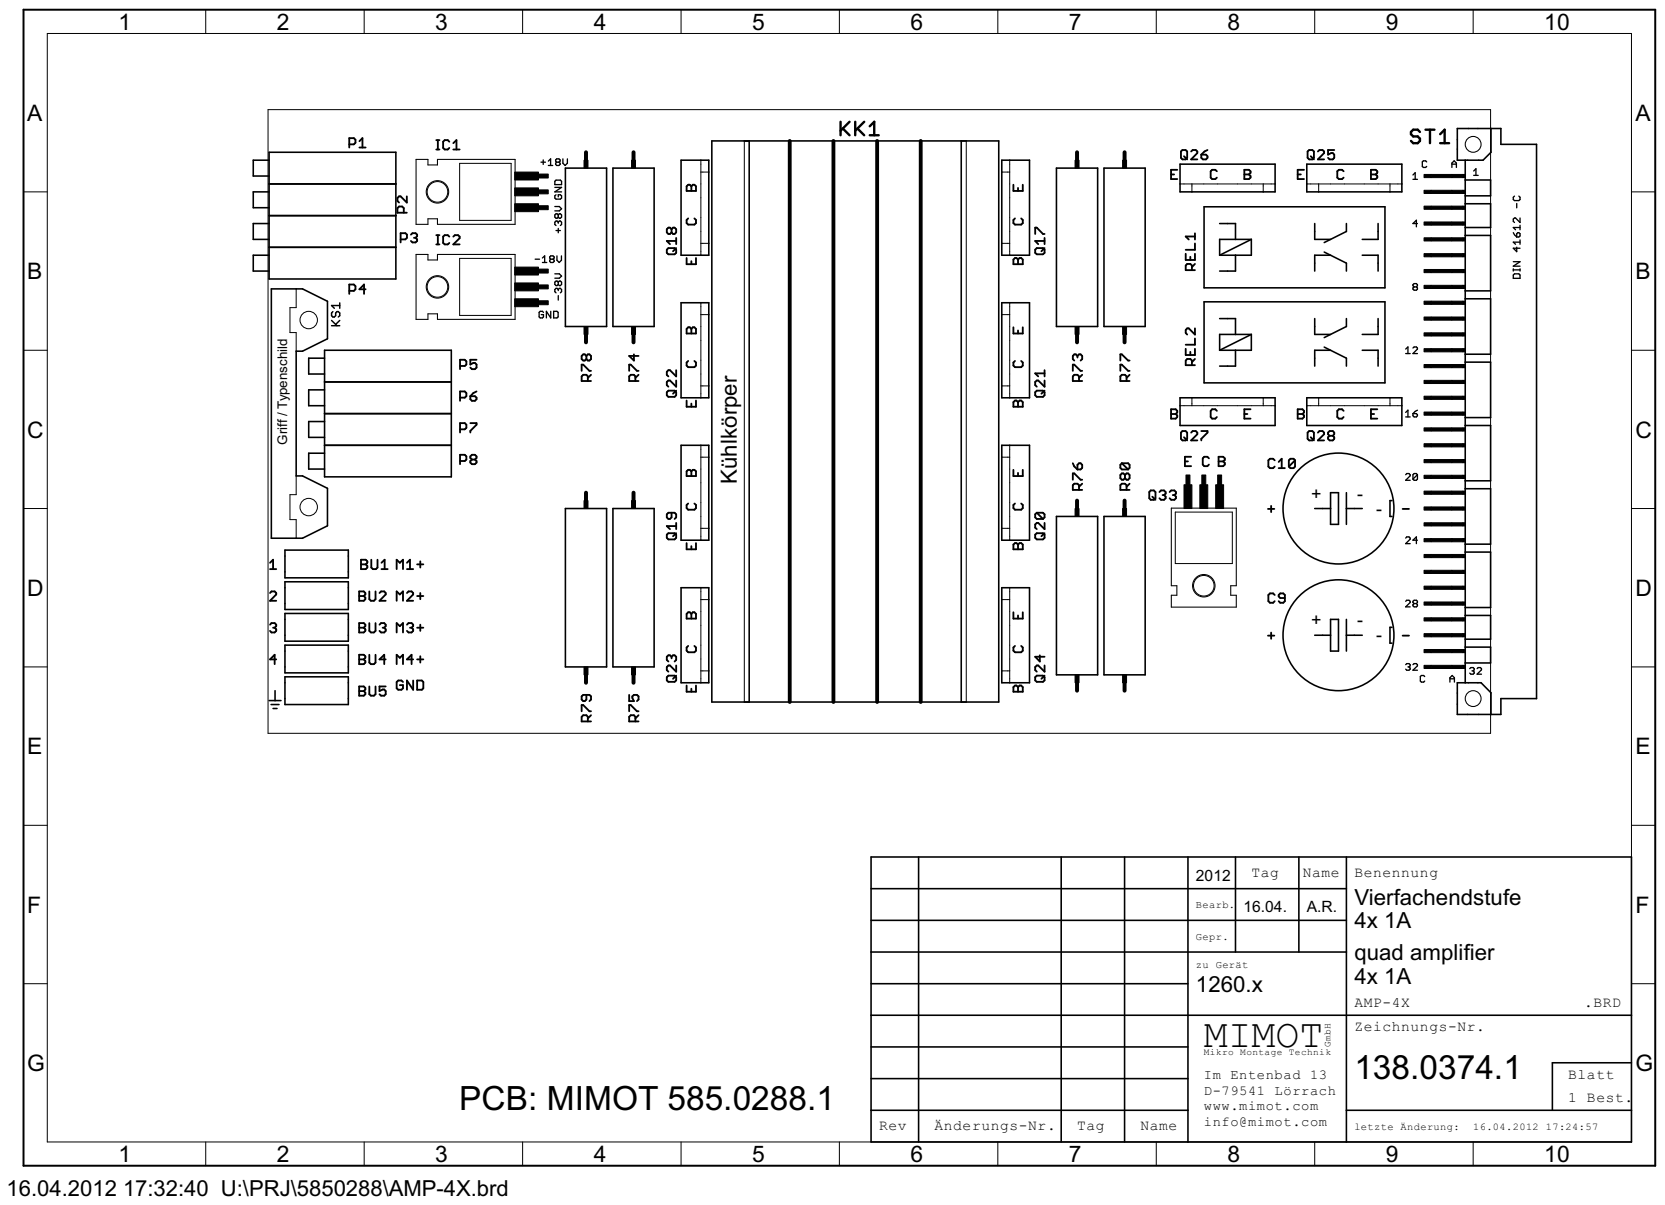
[picture p45: page 6]
-+ Griff / Typenschild; Kühlkörper; PCB: MIMOT 585.0288.1; Blatt; 1 Best.

2012 | | | Benennung Vierfachendstufe 4x 1A quad amplifier 4x 1A AMP-4X .BRD

Gepr. Bearb. | Tag 16.04. A.R. | Name

zu Gerät 1260.x

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

Rev | Änderungs-Nr. | Tag | Name | | letzte Änderung: 16.04.2012 17:24:57

16.04.2012 17:32:40 U:\PRJ\5850288\AMP-4X.brd

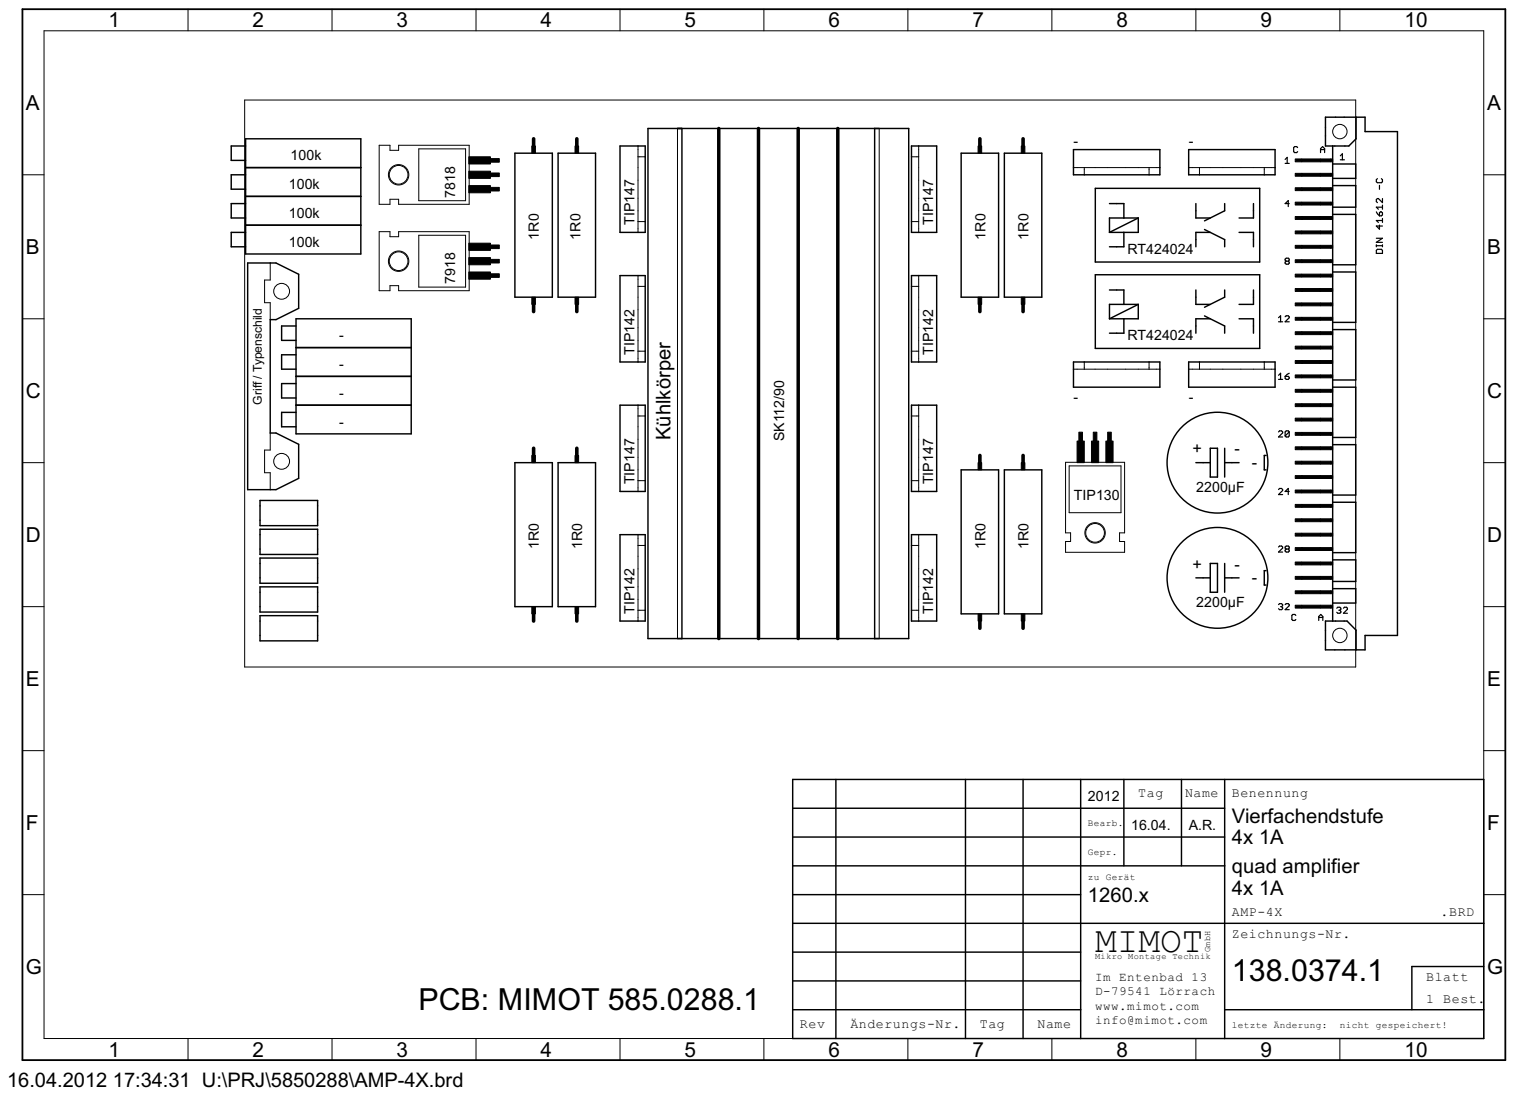
[picture p46: page 7]
-+ Griff / Typenschild; Kühlkörper; PCB: MIMOT 585.0288.1; TIP¹⁴⁷; 1R⁰ TIP¹⁴²; - RT424024 ⁷⁸¹⁸ ⁷⁹¹⁸; 2200µF TIP130; TIP¹⁴⁷ 1R⁰; TIP¹⁴² ¹R⁰; - SK¹¹²/90; Blatt; 1 Best.

2012 | | | Benennung Vierfachendstufe 4x 1A quad amplifier 4x 1A AMP-4X .BRD

Gepr. Bearb. | Tag 16.04. A.R. | Name

zu Gerät 1260.x

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

Rev | Änderungs-Nr. | Tag | Name | | letzte Änderung: nicht gespeichert!

16.04.2012 17:34:31 U:\PRJ\5850288\AMP-4X.brd

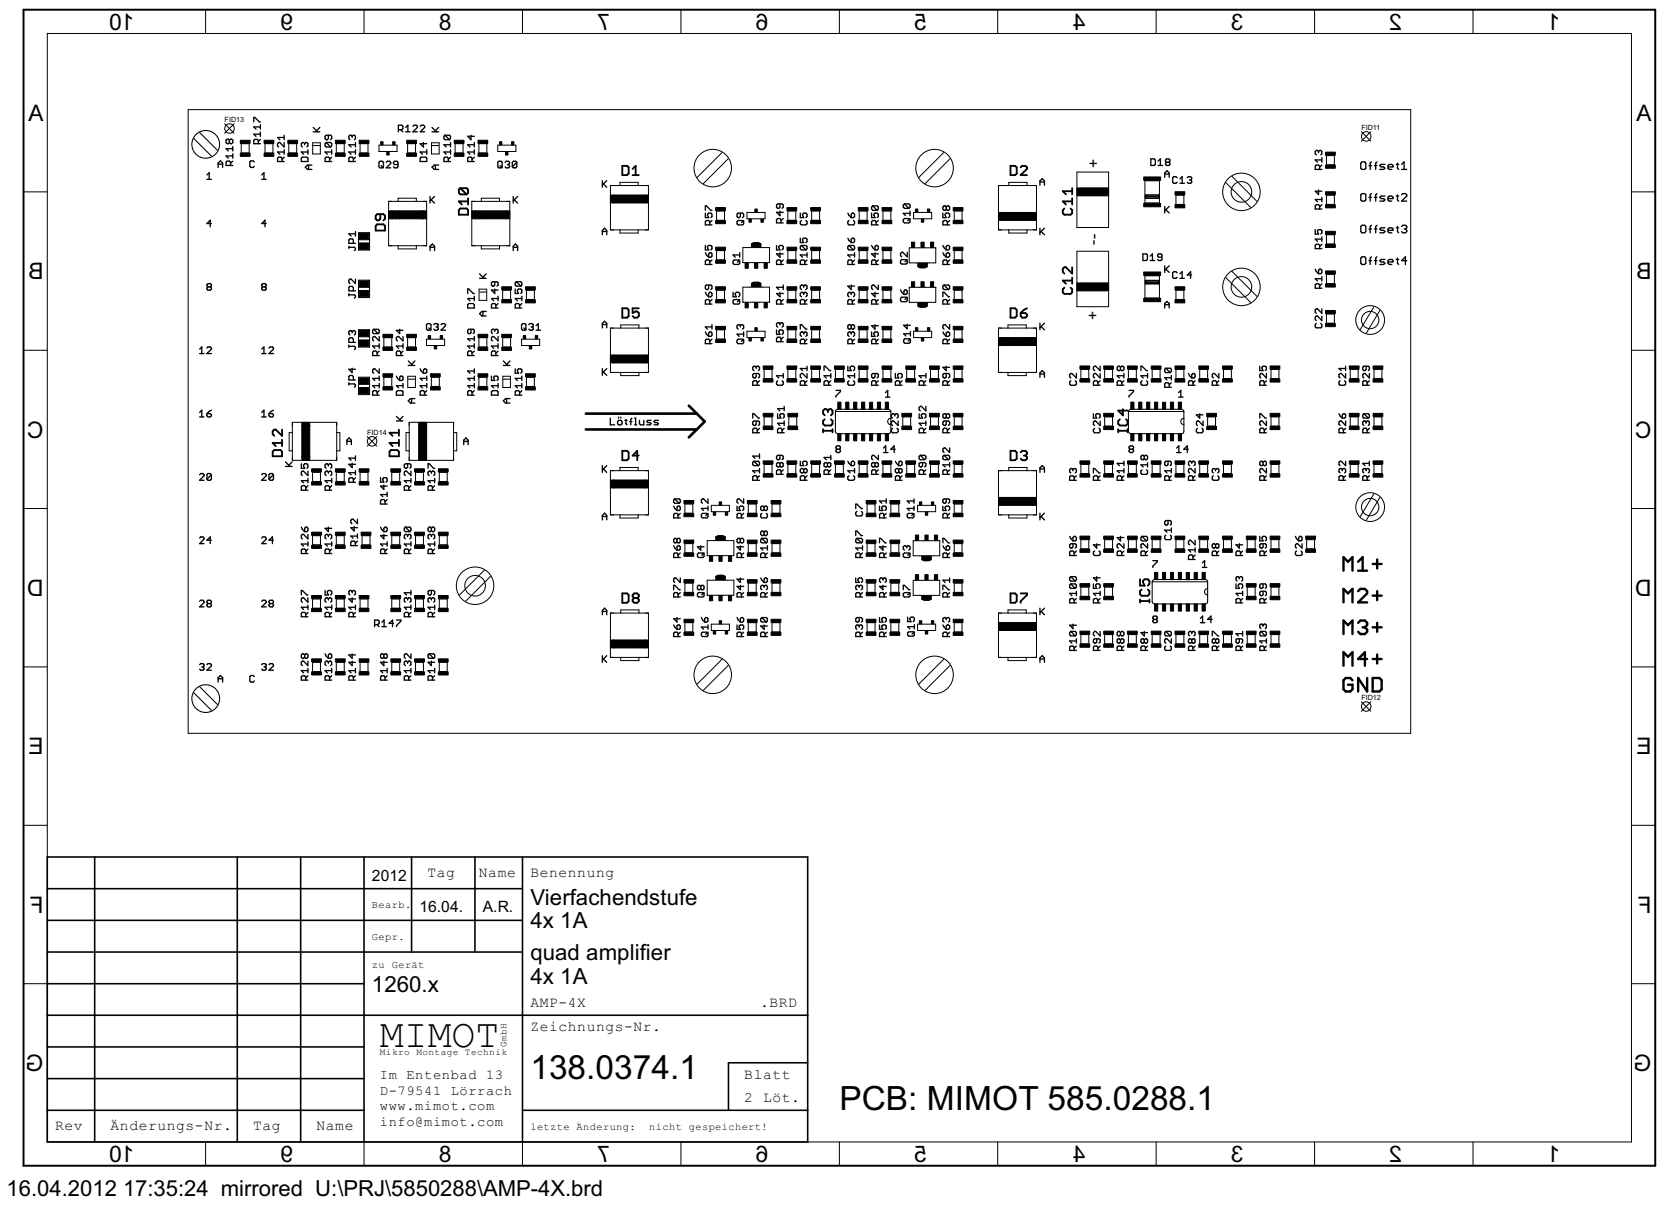
[picture p47: page 8]
16.04.2012 17:35:24 mirrored U:\PRJ\5850288\AMP-4X.brd; FID11; FID12; FID13; FID14; Vierfachendstufe; quad amplifier 4x 1A; PCB: MIMOT 585.0288.1; Rev; Änderungs-Nr.; Tag; Name; Bearb.; Gepr.; Benennung; Zeichnungs-Nr.; Blatt; AMP-4X; zu Gerät; letzte Änderung:; nicht gespeichert!; .BRD; 2 Löt.

info@mimot.com MIMOT Mikro Montage TechnikGmbH

Im Entenbad 13
D-79541 Lörrach
www.mimot.com

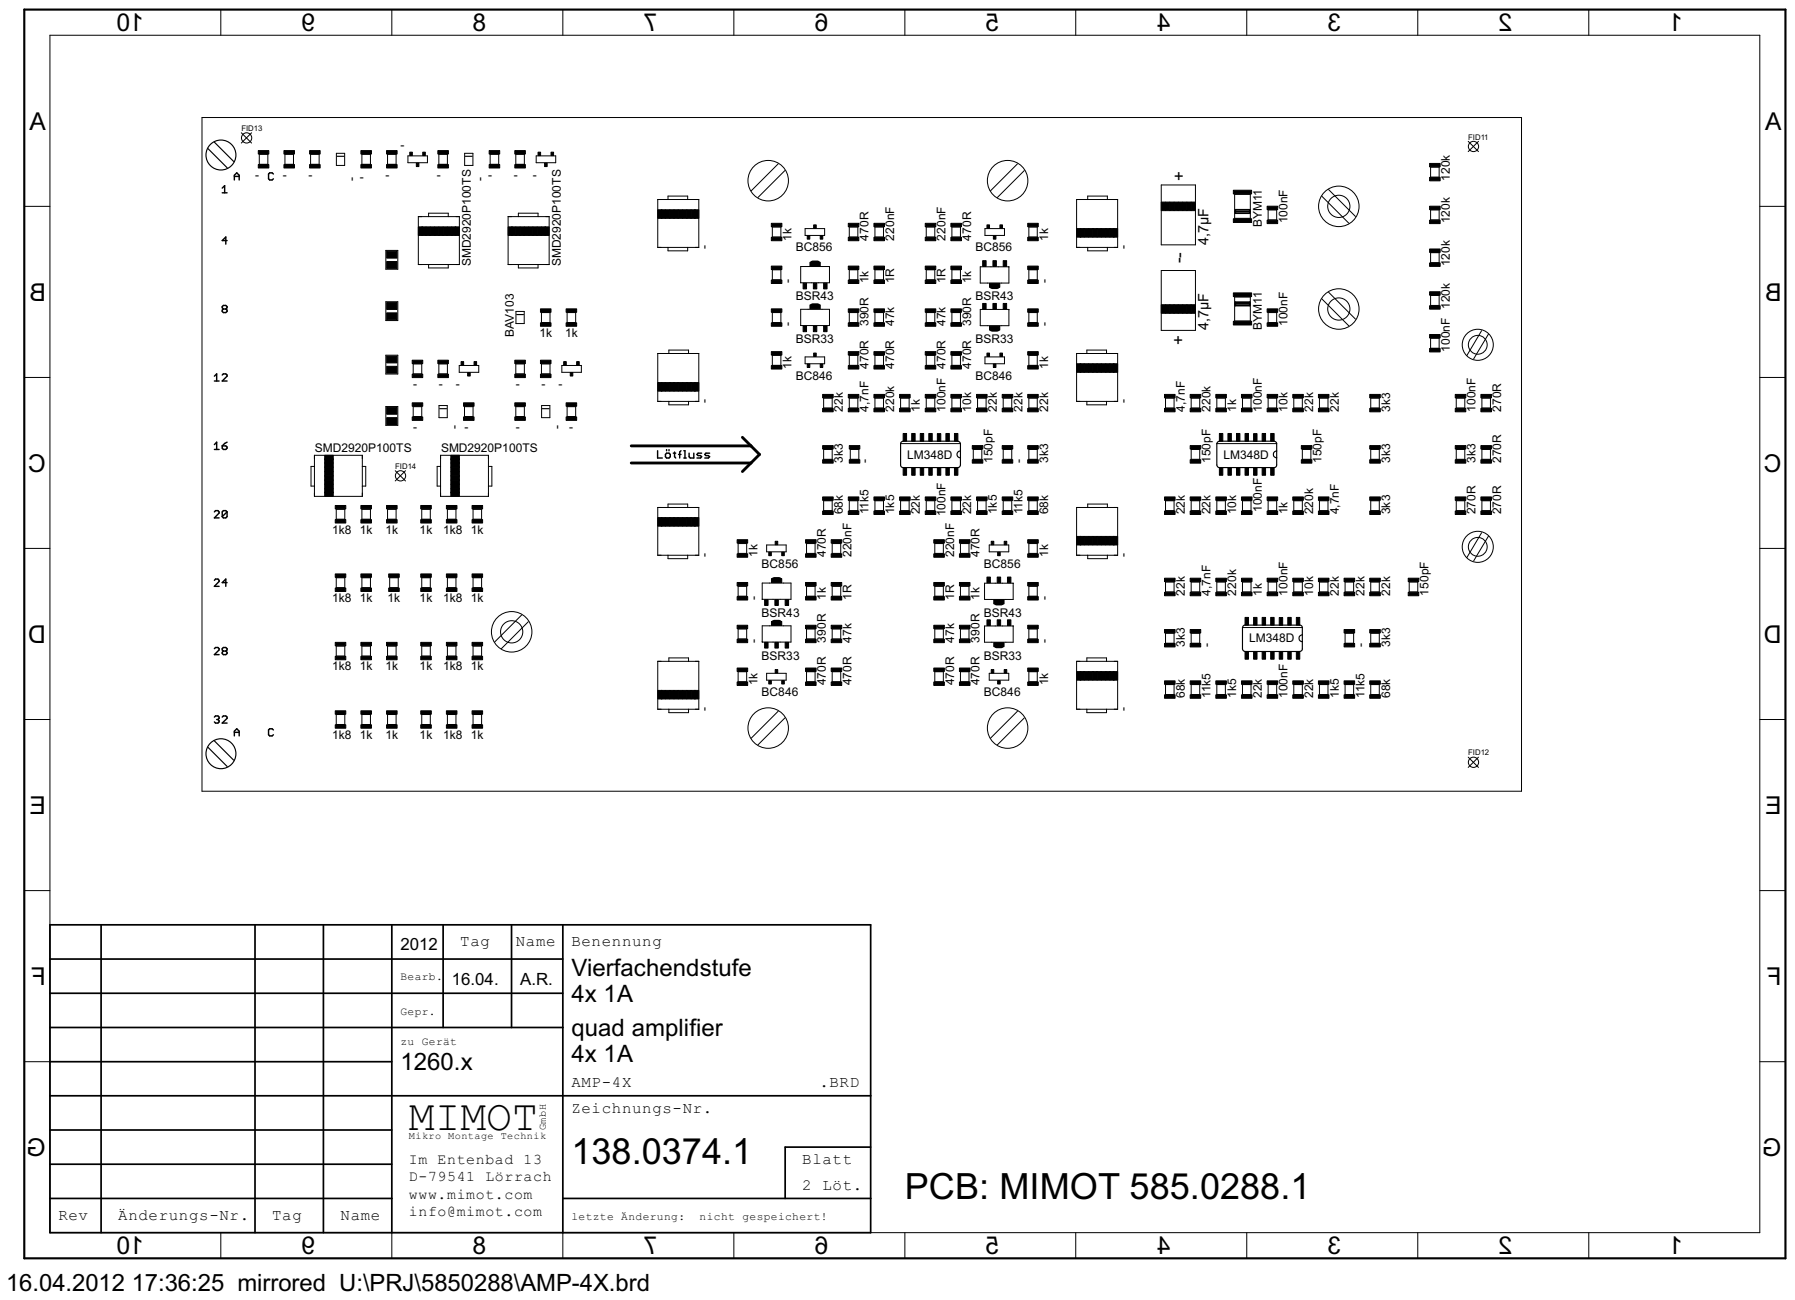
[picture p48: page 9]
16.04.2012 17:36:25 mirrored U:\PRJ\5850288\AMP-4X.brd; FID11; FID12; FID13; FID14; 1k 470R ⁴⁷k; 270R ⁴⁷⁰R 470R ¹k 1k; 1R ²²⁰nF; BAV¹⁰³; BYM¹¹ BYM¹¹; BSR43 BSR33; - - SMD2920P100TS; 270R ⁴⁷⁰R 470R; 1k 1k 1R ²²⁰nF; - - SMD2920P100TS 22k 22k 10k 120k 1k220k 4,7nF 470R 47k 3k3 270R 470R 470R 1k 1k 1R 220nF 1k390R; SMD2920P100TS; PCB: MIMOT 585.0288.1; Blatt; 2 Löt.

2012 | | | Benennung Vierfachendstufe 4x 1A quad amplifier 4x 1A AMP-4X .BRD

Gepr. Bearb. | Tag 16.04. A.R. | Name

zu Gerät 1260.x

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

Rev | Änderungs-Nr. | Tag | Name | | letzte Änderung: nicht gespeichert!

BGR: 149629 | Zeichnung: 138.0374.1 | Seite: 1 | Gedruckt: 23.04.2012 13:53 Uhr
Vierfachendstufe 1260 | Rev.2 | Erstellt: 30.03.2012 ar
Geändert: 02.04.2012 ar
Änderungen/Bemerkungen: | Geprueft: 02.04.2012 ar
Als Leistungstransistoren sind verschiedene Typen möglich, nur als Komplementäres Paar, nicht in gemischter Bestückung:
NPN: | PNP:
TIP142 | TIP147
BDW83D | BDW84D
BDW83C | BDW84C
BDV65C | BDV64C
MJH11022G | MJH11021G
MJH11020G | MJH11019G
MJH11018G | MJH11017G
Pos. Gesamtanzahl TeileNr. | Artikelbezeichnung | ZPos. Bestückposition/Bemerkung
===================================================================================================
1 | 1, Stk 149688 | Leiterplatte 585.0288.1 | PCB
Vierfachendstufe (Fast-Flash) ZN: 585.0288.1
2 | 1, Stk 139988 | Messerleiste DIN41612 | ST1
Bauform C 64-pol. abgwinkelt ZN: E-ST-ML-C-64PCB
3 | 1, Stk 140157 | Kartengriff gelb transparent | KS1
z. B. Schroff 60817-050
ZN: MÜKG-60817-50 | VPE = 10 Stück
4 | 1, Stk 138878 | Strangkühlkörper 46x33x90mm | KK1
PCB-Montage für TO220 o.Ä. ZN: E-EM-KK-SK112-90SA schwarz eloxiert ~3,0K/W
z.B. Fischer SK112 90SA
5 | 8, Stk 127346 | Isolierbuchse M3 d=3,5mm | (Q17 - Q24)
z. B. Fischer IB6
ZN: E-EM-IB6
6 | 8, Stk 127738 | Wärmeleitfolie TO 3 PF / TO247 | (Q17 - Q24)
GF-verstärkt, 0,15mm, 3kV,
ZN: E-EM-WB3P | 0,34K/W, 1,43W/mK (pro Inch²)
z.B. Fischer WB 3 P
7 | 4, Stk 133072 | Prüfbuchse 2mm RM10 rot | BU1 - BU4
z.B. Hirschmann MPB1-RT
ZN: E-ST-MPB1-RT
8 | 1, Stk 133073 | Prüfbuchse 2mm RM10 schwarz | BU5
z.B. Hirschmann MPB1-SW
ZN: E-ST-MPB1-SW
9 | 1, Stk 130128 | Hinweisaufkleber | zu Pos.3: in Kartenschild
Typ / Beschriftung ->Kommentar | Beschriftung max. 7x37mm in
ZN: E-DOC-Labelinfo | Serifenlose Schrift Höhe >=3mm
Beschriftung: " 138.0374.1 " ---------------------------------------------------------------------------------------------------
10 | 4, Stk 127231 | Kerko 1206 4,7nF/100V 10% | C1 - C4
ZN: E-C-1206-4,7nF/100V
11 | 4, Stk 127225 | Kerko 1206 220nF/50V 10% X7R | C5 - C8
ZN: E-C-1206-220nF/50V
12 | 2, Stk 127840 | Elko 2200µF/50V 85°C RM7,6 | C9, C10
Radial, D<=18mm, L<=38mm
ZN: E-C-Elko-2200uF/50V
13 | 2, Stk 127263 | Tantal-C 6032 4,7µF/35V 20% | C11, C12
ZN: E-C-TA-C-4,7uF/35V
14 | 10, Stk 127214 | Kerko 1206 100nF/50V 10% X7R | C13 - C22
ZN: E-C-1206-100nF/50V
15 | 2, Stk 127903 | Gleichrichterdiode 1A/1000V | D18, D19
Melf
ZN: E-D-Melf-1A/1000V z.B.: BYM11-1000 ---------------------------------------------------------------------------------------------------

===================================================================================================
(C) MIMOT Mikro Montage Technik GmbH, Im Entenbad 13 , 79541 Lörrach-Hauingen | ar | >>>>>

BGR: 149629 | Zeichnung: 138.0374.1 | Seite: 2 | Gedruckt: 23.04.2012 13:53 Uhr
Vierfachendstufe 1260 | Rev.2 | Erstellt: 30.03.2012 ar
Pos. Gesamtanzahl TeileNr. | Artikelbezeichnung | ZPos. Bestückposition/Bemerkung
===================================================================================================
16 | 1, Stk 127897 | Universaldiode SOD-80 | D17
250mA/200V BAV103
ZN: E-D-SOD80-BAV103
17 | 2, Stk 129993 | PCB-Relais RT2 DPDT 5/6VDC | Rel1, Rel2
2x 8A/250VAC/30VDC, H=15,9mm
ZN: E-REL-RT2-5VDC | z.B. TE RT424005, RT424006
Omron G2RL245DC
18 | 1, Stk 130437 | Spannungsregler linear +18V/1A | IC1
5% TO220 7818-kompatibel
ZN: E-IC-7818-TO220
19 | 1, Stk 130443 | Spannungsregler linear -18V/1A | IC2
5% TO220 7918-kompatibel
ZN: E-IC-7918-TO220
20 | 3, Stk 129096 | 4xOPAmp Bipolar SO14 | IC3, IC4, IC5
1MHz, 0,5V/µs, +-5V...+-18V
ZN: E-IC-LM348D | z.B.: LM348D
21 | 4, Stk 129656 | Spindeltrimmer 19mm 100k 10% | P1 - P4
15-Gang 0,75W linear
ZN: E-Poti-19mm-100k
22 | 4, Stk 130218 | NPN-Transistor SOT-89 1A/80V | Q1 - Q4
1,35W, 100MHz, hfe>=100
ZN: E-T-BSR43 | z.B. NXP BSR43
23 | 4, Stk 130685 | PNP-Transistor SOT-89 1A/80V | Q5 - Q8
1,35W, 100MHz, hfe=100...300
ZN: E-T-BSR33 | z.B. NXP BSR33
24 | 4, Stk 130683 | Transistor PNP SOT23 65V/100mA | Q9 - Q12
hFE=200...450, fT=150MHz
ZN: E-T-BC856B | BC856B
25 | 4, Stk 130682 | Transistor NPN SOT23 65V/100mA | Q13 - Q16
hFE=200...450, fT=300MHz
ZN: E-T-BC846B | BC846B
26 | 4, Stk 130417 | Darlington PNP TO218/SOT93 | Q17 - Q20
10A/100V, hFe>=1000, 125W
ZN: E-T-TIP147 | z.B. STM TIP147
27 | 4, Stk 130415 | Darlington NPN TO218/SOT93 | Q21 - Q24
10A/100V, hFe>=1000, 125W
ZN: E-T-TIP142 | z.B. STM TIP142
28 | 1, Stk 130414 | NPN-Darlington TO220 | Q33
8A/80V, hfe=1000-15000, 70W
ZN: E-T-TIP131 | z.B. TIP131
30 | 16, Stk 129931 | Widerstand 1206 22k 5% | R1 - R8, R81 - R84, R93 - R96
ZN: E-R-1206-22k-5%
33 | 4, Stk 129910 | Widerstand 1206 10k 5% | R9 - R12
ZN: E-R-1206-10k-5%
34 | 4, Stk 129956 | Widerstand 1206 68k 5% | R101 - R104
ZN: E-R-1206-68k-5%
35 | 4, Stk 129964 | Widerstand 1206 120k 1% | R13 - R16
ZN: E-R-1206-120k-1%
36 | 34, Stk 129923 | Widerstand 1206 1K 5% | R17-R20, R45-R48, R57-R64,
R133 - R150
ZN: E-R-1206-1k-5%

===================================================================================================
(C) MIMOT Mikro Montage Technik GmbH, Im Entenbad 13 , 79541 Lörrach-Hauingen | ar | >>>>>

BGR: 149629 | Zeichnung: 138.0374.1 | Seite: 3 | Gedruckt: 23.04.2012 13:53 Uhr
Vierfachendstufe 1260 | Rev.2 | Erstellt: 30.03.2012 ar
Pos. Gesamtanzahl TeileNr. | Artikelbezeichnung | ZPos. Bestückposition/Bemerkung
===================================================================================================
37 | 4, Stk 129929 | Widerstand 1206 220k 5% | R21 - R24
ZN: E-R-1206-220k-5%
38 | 8, Stk 129943 | Widerstand 1206 3k3 5% | R25 - R28, R97 - R100
ZN: E-R-1206-3k3-5%
39 | 4, Stk 129934 | Widerstand 1206 270R 5% | R29 - R32
ZN: E-R-1206-270R-5%
40 | 4, Stk 129947 | Widerstand 1206 47k 5% | R33 - R36
ZN: E-R-1206-47k-5%
41 | 12, Stk 129946 | Widerstand 1206 470R 5% | R37 - R40, R49 - R56
ZN: E-R-1206-470R-5%
42 | 4, Stk 129941 | Widerstand 1206 390R 5% | R41 - R44
ZN: E-R-1206-390R-5%
44 | 8, Stk 129722 | Widerstand 208-8 1R 10% 5W | R73 - R80
Zementwiderstand 6,4x6,4x25mm ZN: E-R-208-8-1R
45 | 4, Stk 129925 | Widerstand 1206 1k5 5% | R85 - R88
ZN: E-R-1206-1k5-5%
46 | 4, Stk 129913 | Widerstand 1206 11k5 1% | R89 - R92
(Optimal R=11,70k)
ZN: E-R-1206-11k5-1%
49 | 4, Stk 129928 | Widerstand 1206 1R 5% | R105 - R108
ZN: E-R-1206-1R-5%
51 | 8, Stk 129926 | Widerstand 1206 1k8 5% | R125 - R132
ZN: E-R-1206-1k8-5%
55 | 4, Stk 128110 | Multifuse 1,1A/33V | D9 - D12
Wickmann SMD2920P100TS,
ZN: E-F-SMD2920P100TS Littlefuse 2920L100PR,
Bourns MF-SM100/33-2
58 | 4, Stk 127219 | Kerko 1206 150pF/100V 5% NPO | C23-C26
in Layout 585.0288.0:
ZN: E-C-1206-150pF/100V | parallel zu R5 - R8 !
60 | 2, Stk 135619 | Linsenkopfschraube DIN 7985A, | zu Pos.3 : KS1
M2,5x08 NI
ZN: MDIN-7985-M02,5x08-N
61 | 2, Stk 135620 | Linsenkopfschraube DIN 7985A, | zu Pos.2 : ST1
M2,5x10 NI
ZN: MDIN-7985-M02,5x10-N
62 | 4, Stk 134921 | Sechskantmutter DIN 934, M2,5 | zu Pos.2,3 : ST1, KS1
NI
ZN: MDIN-0934-M02,5-NI
63 | 3, Stk 134927 | Sechskantmutter DIN 934, M3 NI | zu Pos.18,19,28: IC1, IC2, Q33
ZN: MDIN-0934-M03-NI
64 | 3, Stk 135634 | Linsenkopfschraube DIN 7985A, | zu Pos.18,19,28: IC1, IC2, Q33
M3x6 NI
ZN: MDIN-7985-M03x06-NI
65 | 12, Stk 135635 | Flachkopfschraube DIN 7985A, | zu Pos. 4, 26, 27 :
M3x8-NI | KK1, Q17 - Q24
ZN: MDIN-7985-M03x08-NI
66 | 4, Stk 137862 | Unterlegscheibe 3,2 x 7 x 0,5 | zu Pos.4 : KK1
DIN125, Polyamid 6, natur
ZN: MMMO-0303036 | z.B. Ettinger 3.03.036

===================================================================================================
(C) MIMOT Mikro Montage Technik GmbH, Im Entenbad 13 , 79541 Lörrach-Hauingen | ar | >###<

# Strombegrenzung 4x Endstufe

# Strombegrenzung der 4x-Endstufe 138.0374.x:

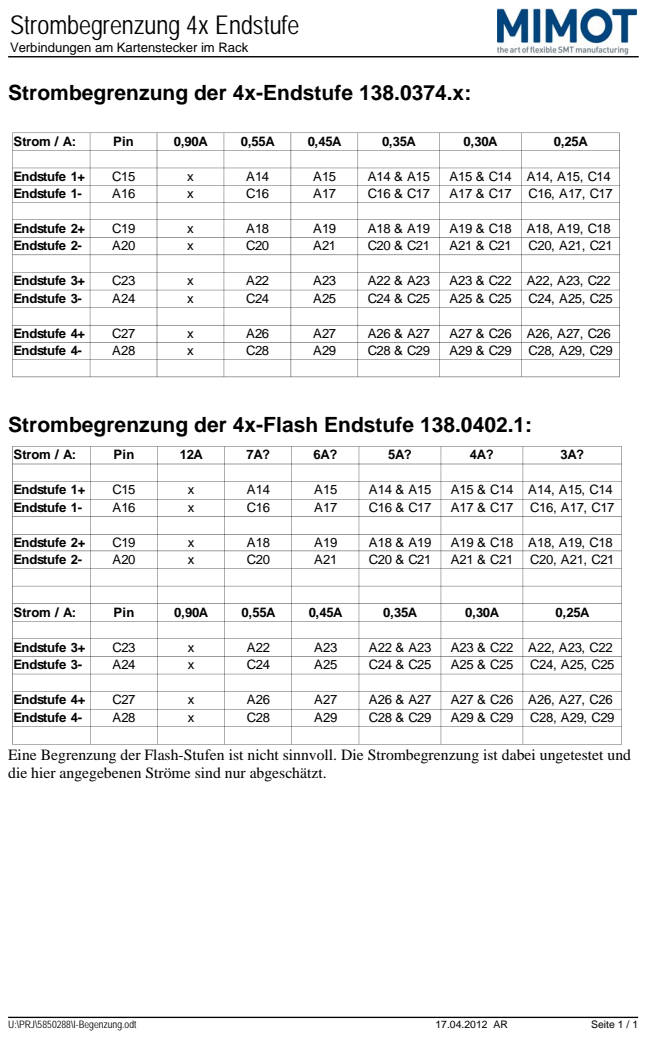
[picture p49: page 13]

Verbindungen am Kartenstecker im Rack

Strombegrenzung der 4x-Flash Endstufe 138.0402.1:

Eine Begrenzung der Flash-Stufen ist nicht sinnvoll. Die Strombegrenzung ist dabei ungetestet und
die hier angegebenen Ströme sind nur abgeschätzt.

47k 3k3 270R | 470R 470R
Q17 | 1 2 R⁷³

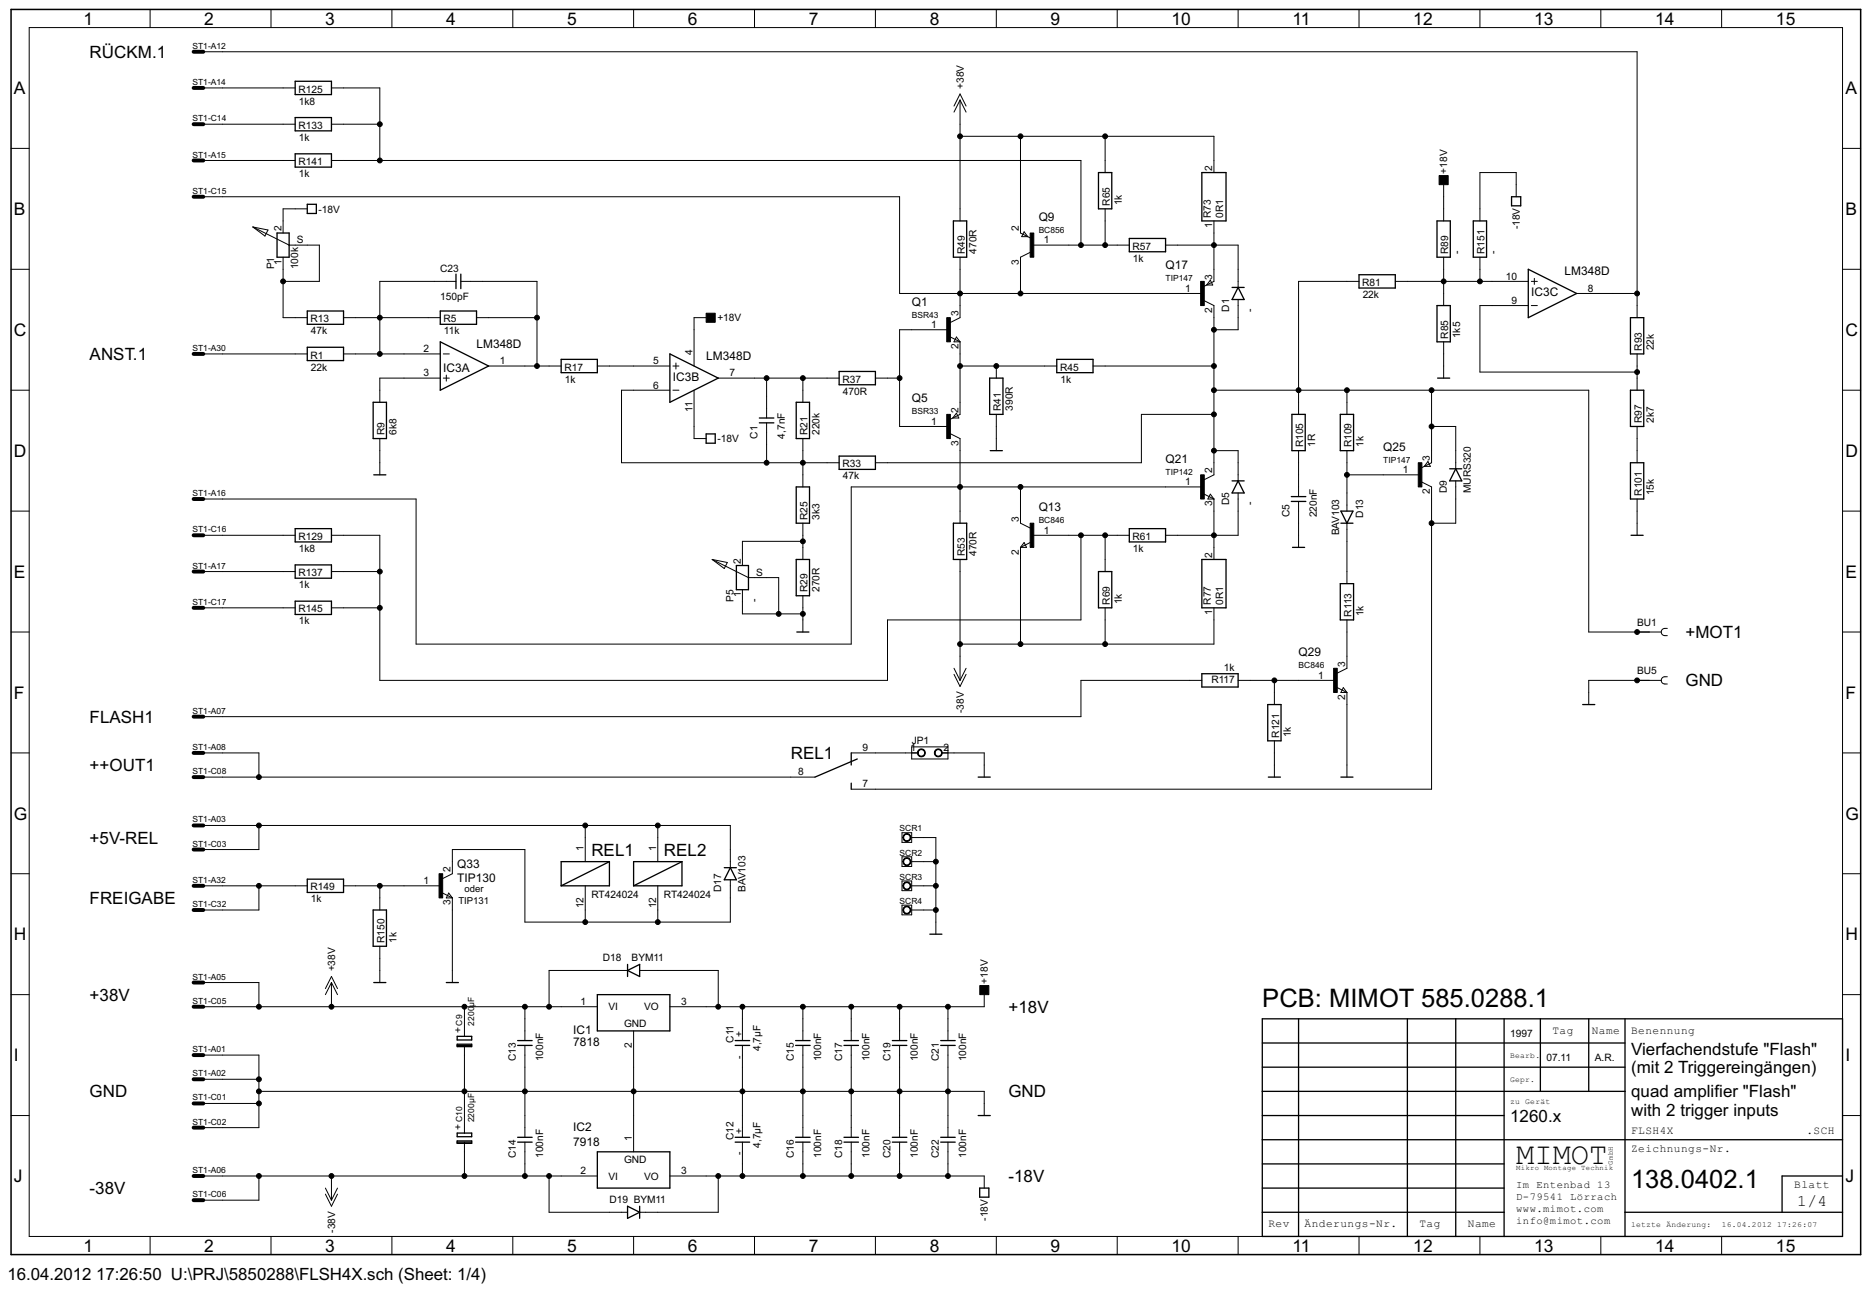
[picture p50: page 14]

1997 | | | Benennung Vierfachendstufe "Flash" quad amplifier "Flash" with 2 trigger inputs FLSH4X

Gepr. Bearb. | Tag | Name

zu Gerät

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

Rev | Änderungs-Nr. | Tag | Name | | letzte Änderung: 16.04.2012 17:26:07

47k 3k3 270R | 470R 470R
Q18 | 1 2 R⁷⁴

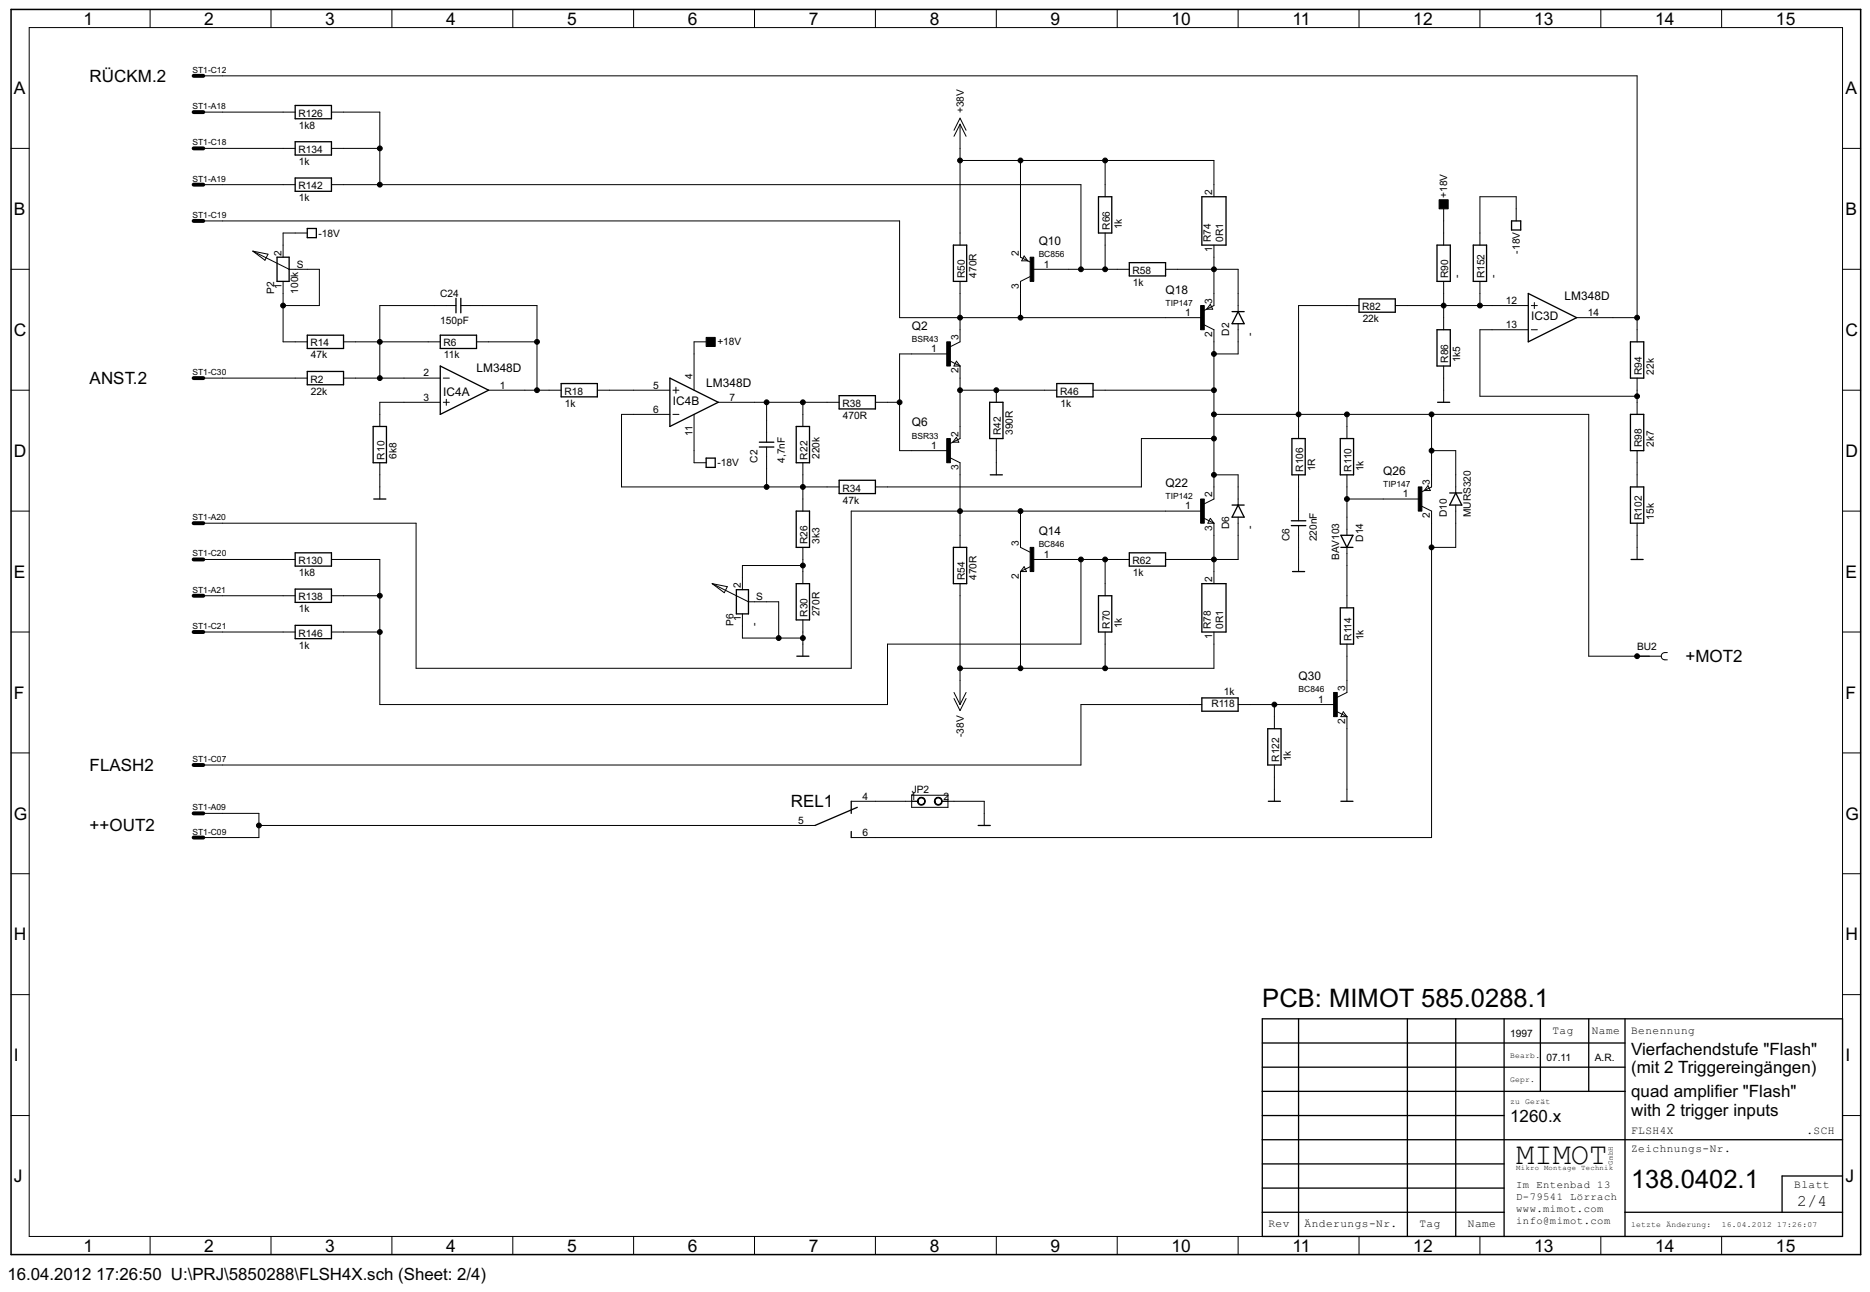
[picture p51: page 15]

1997 | | | Benennung Vierfachendstufe "Flash" (mit 2 Triggereingängen) quad amplifier "Flash" with 2 trigger inputs FLSH4X

Gepr. Bearb. | Tag | Name

zu Gerät

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

Rev | Änderungs-Nr. | Tag | Name | | letzte Änderung: 16.04.2012 17:26:07

16.04.2012 17:26:50 U:\PRJ\5850288\FLSH4X.sch (Sheet: 3/4) ¹⁰⁰k | 10k
47k 3k3 270R | 470R 470R

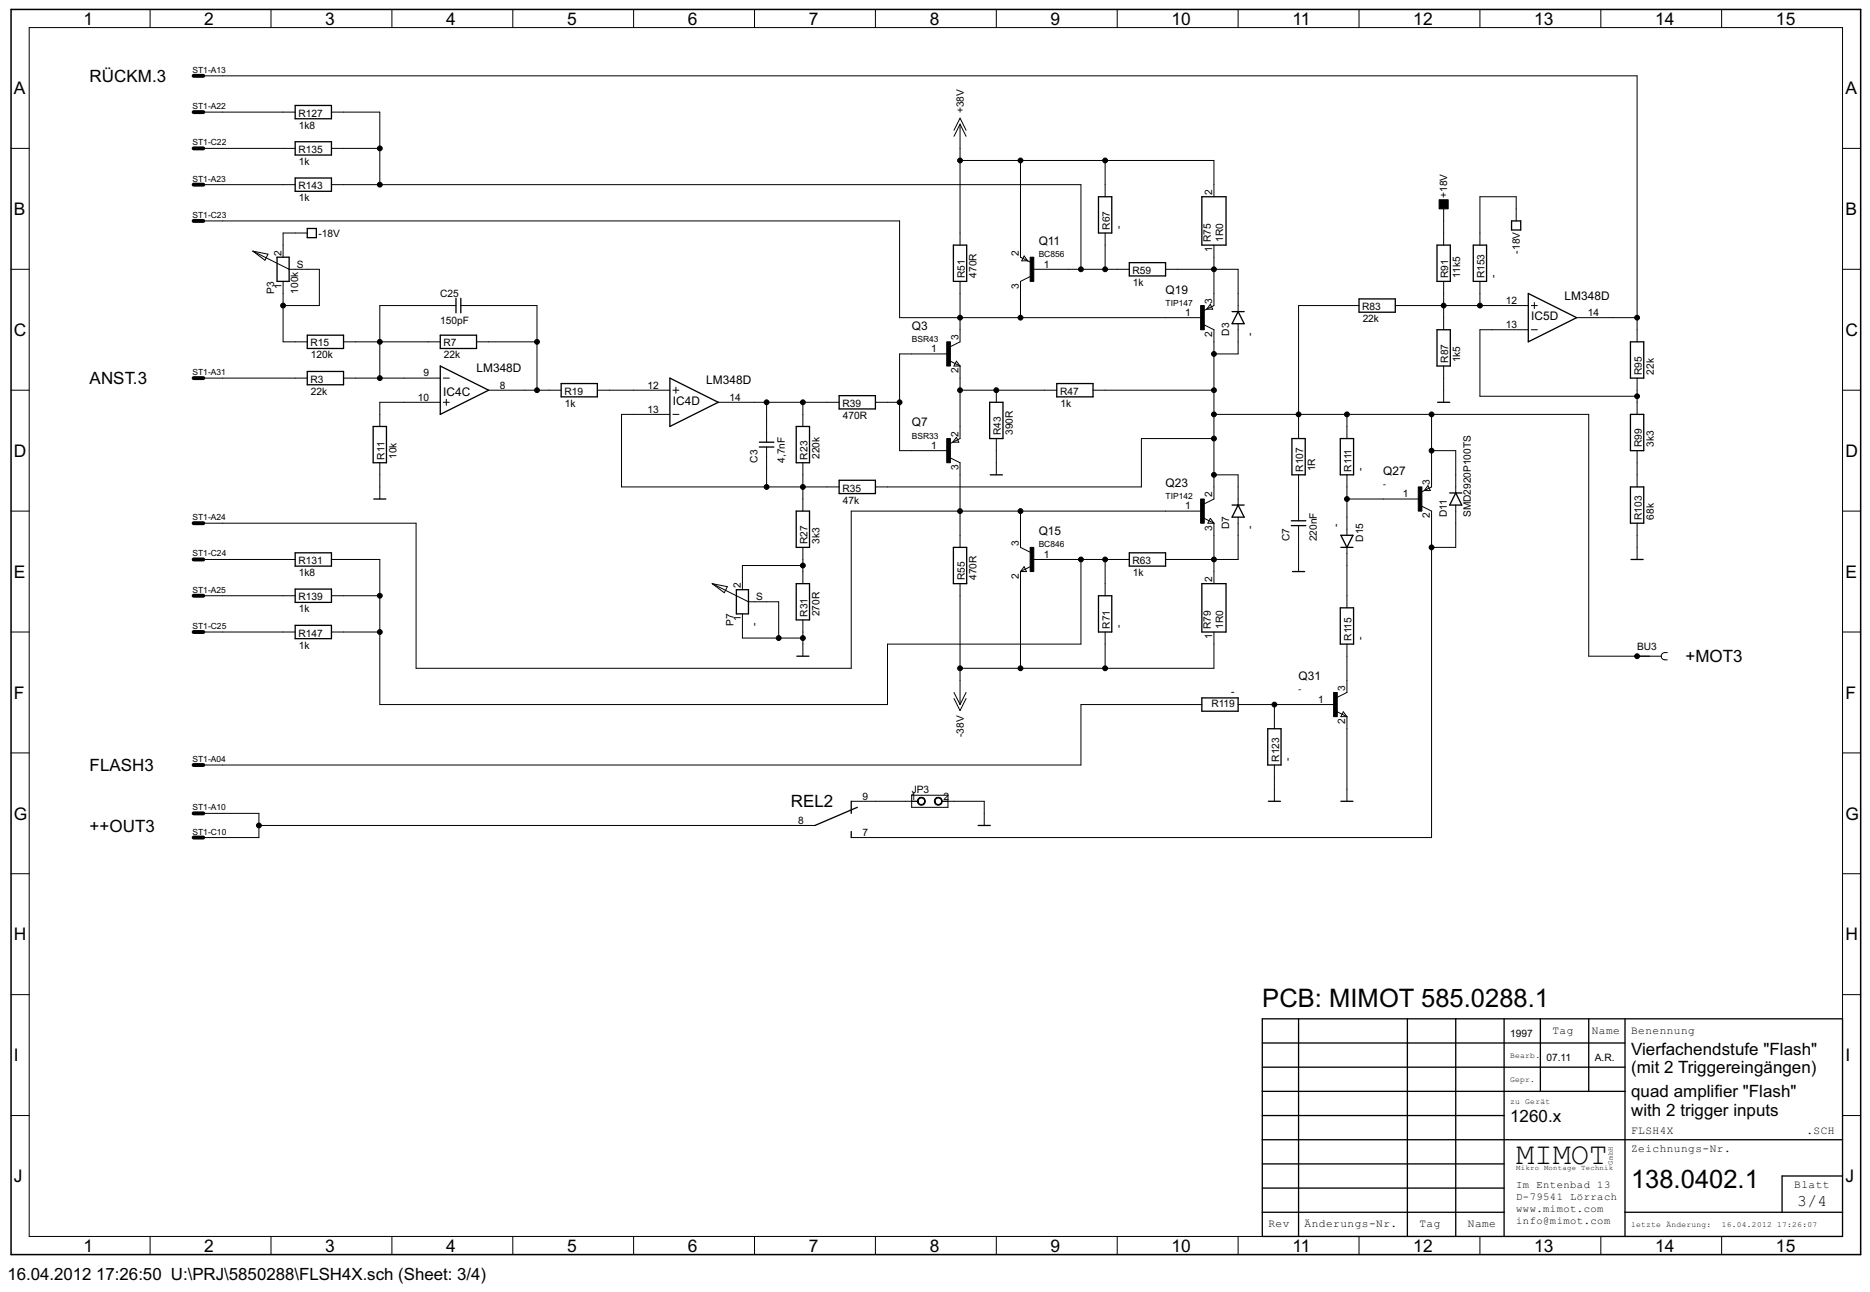
[picture p52: page 16]

1997 | | | Benennung Vierfachendstufe "Flash" (mit 2 Triggereingängen) quad amplifier "Flash" with 2 trigger inputs FLSH4X

Gepr. Bearb. | Tag | Name

zu Gerät

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

Rev | Änderungs-Nr. | Tag | Name | | letzte Änderung: 16.04.2012 17:26:07

16.04.2012 17:26:50 U:\PRJ\5850288\FLSH4X.sch (Sheet: 4/4) ¹⁰⁰k | 10k
47k 3k3 270R | 470R 470R

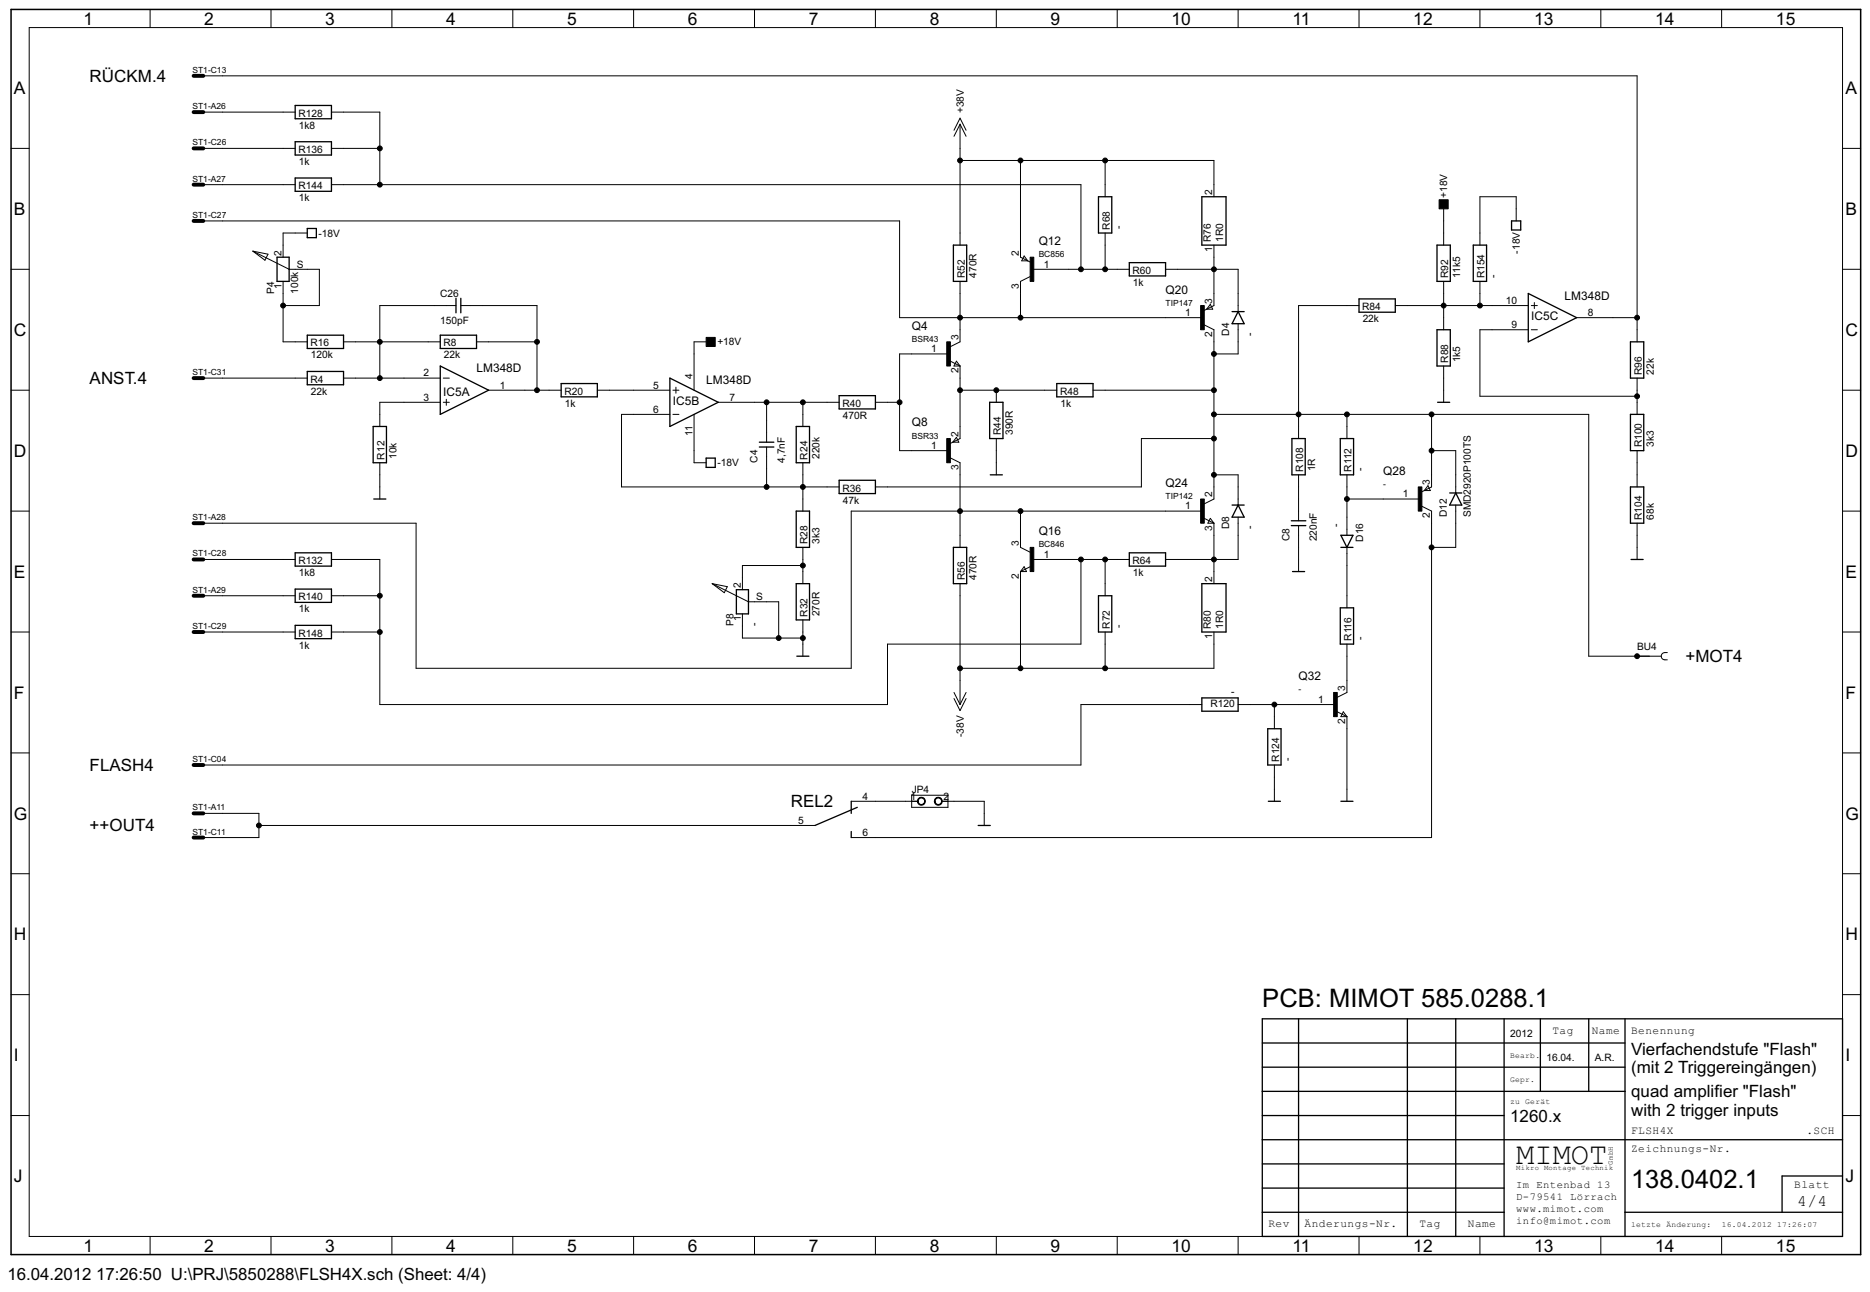
[picture p53: page 17]

2012 | | | Benennung Vierfachendstufe "Flash" (mit 2 Triggereingängen) quad amplifier "Flash" with 2 trigger inputs FLSH4X

Gepr. Bearb. | Tag | Name

zu Gerät

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

Rev | Änderungs-Nr. | Tag | Name | | letzte Änderung: 16.04.2012 17:26:07

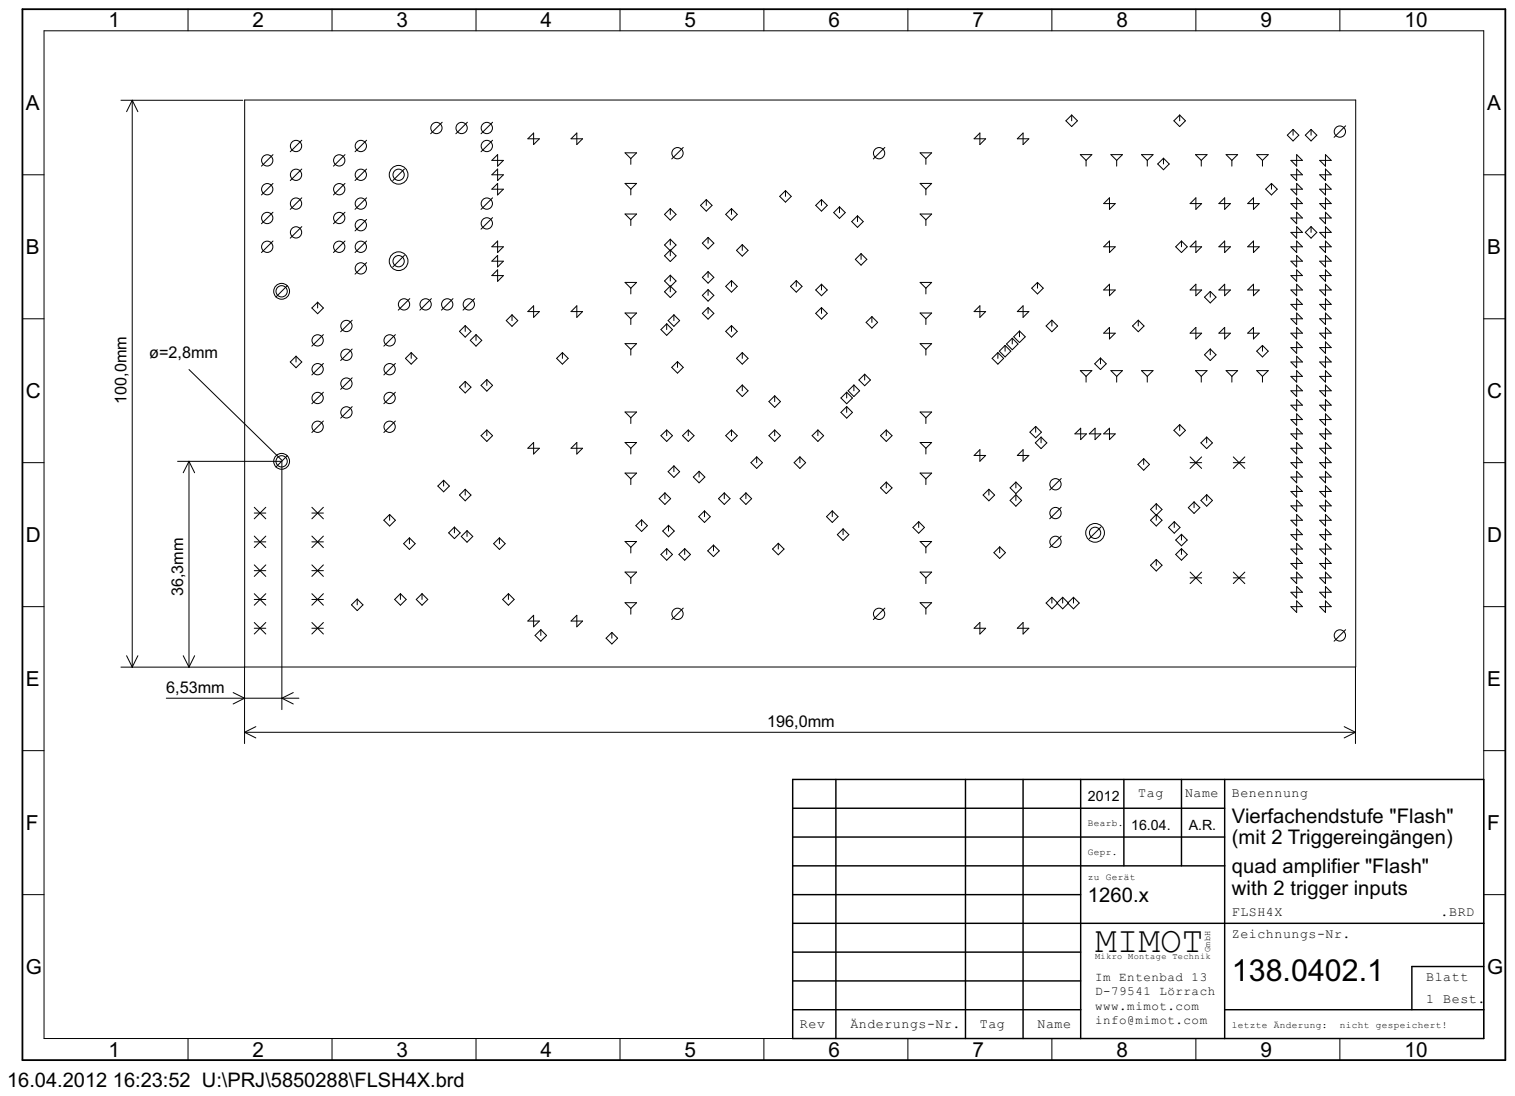
[picture p54: page 18]
16.04.2012 16:23:52 U:\PRJ\5850288\FLSH4X.brd; ø=2,8mm 36,3mm ¹⁰⁰,0mm; Blatt; 1 Best.

2012 | | | Benennung Vierfachendstufe "Flash" (mit 2 Triggereingängen) quad amplifier "Flash" with 2 trigger inputs FLSH4X .BRD

Gepr. Bearb. | Tag 16.04. A.R. | Name

zu Gerät 1260.x

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

Rev | Änderungs-Nr. | Tag | Name | | letzte Änderung: nicht gespeichert!

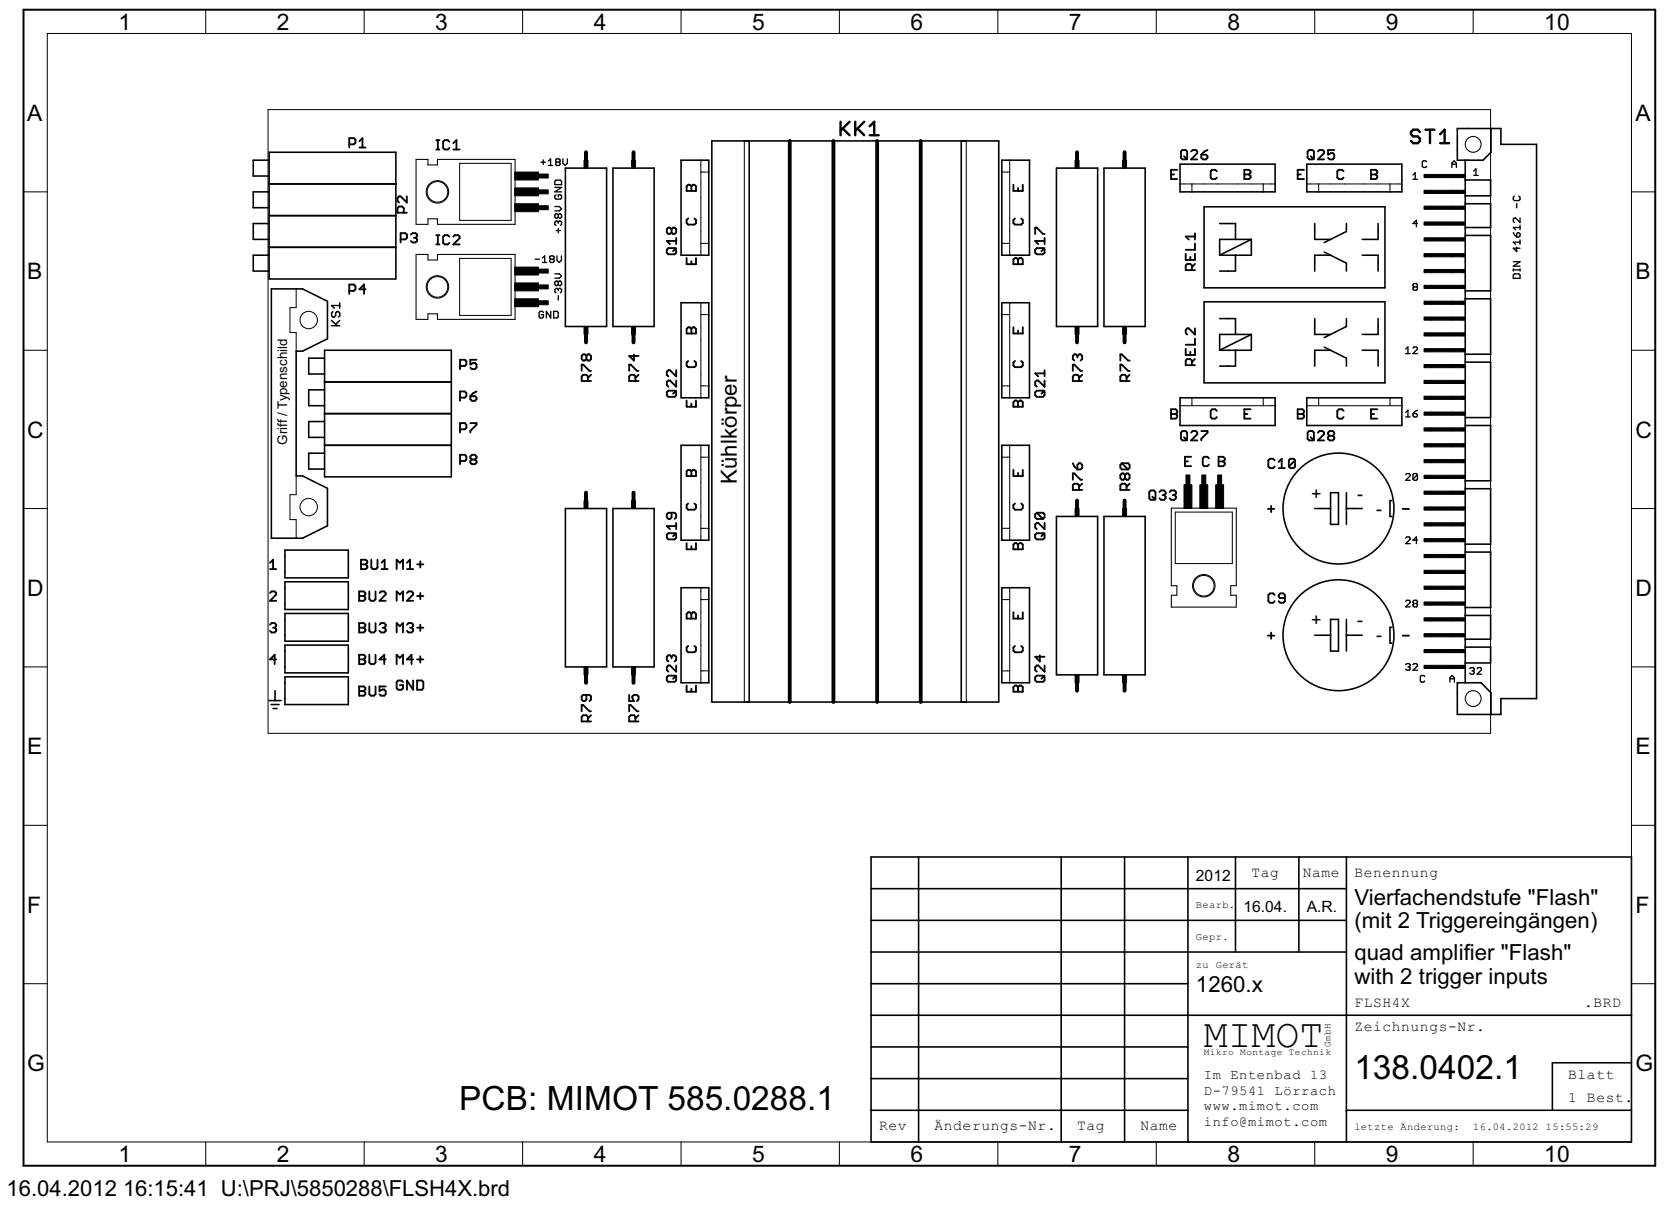
[picture p55: page 19]
16.04.2012 16:15:41 U:\PRJ\5850288\FLSH4X.brd; -+ Griff / Typenschild; Kühlkörper; PCB: MIMOT 585.0288.1; Blatt; 1 Best.

2012 | | | Benennung Vierfachendstufe "Flash" (mit 2 Triggereingängen) quad amplifier "Flash" with 2 trigger inputs FLSH4X .BRD

Gepr. Bearb. | Tag 16.04. A.R. | Name

zu Gerät 1260.x

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

Rev | Änderungs-Nr. | Tag | Name | | letzte Änderung: 16.04.2012 15:55:29

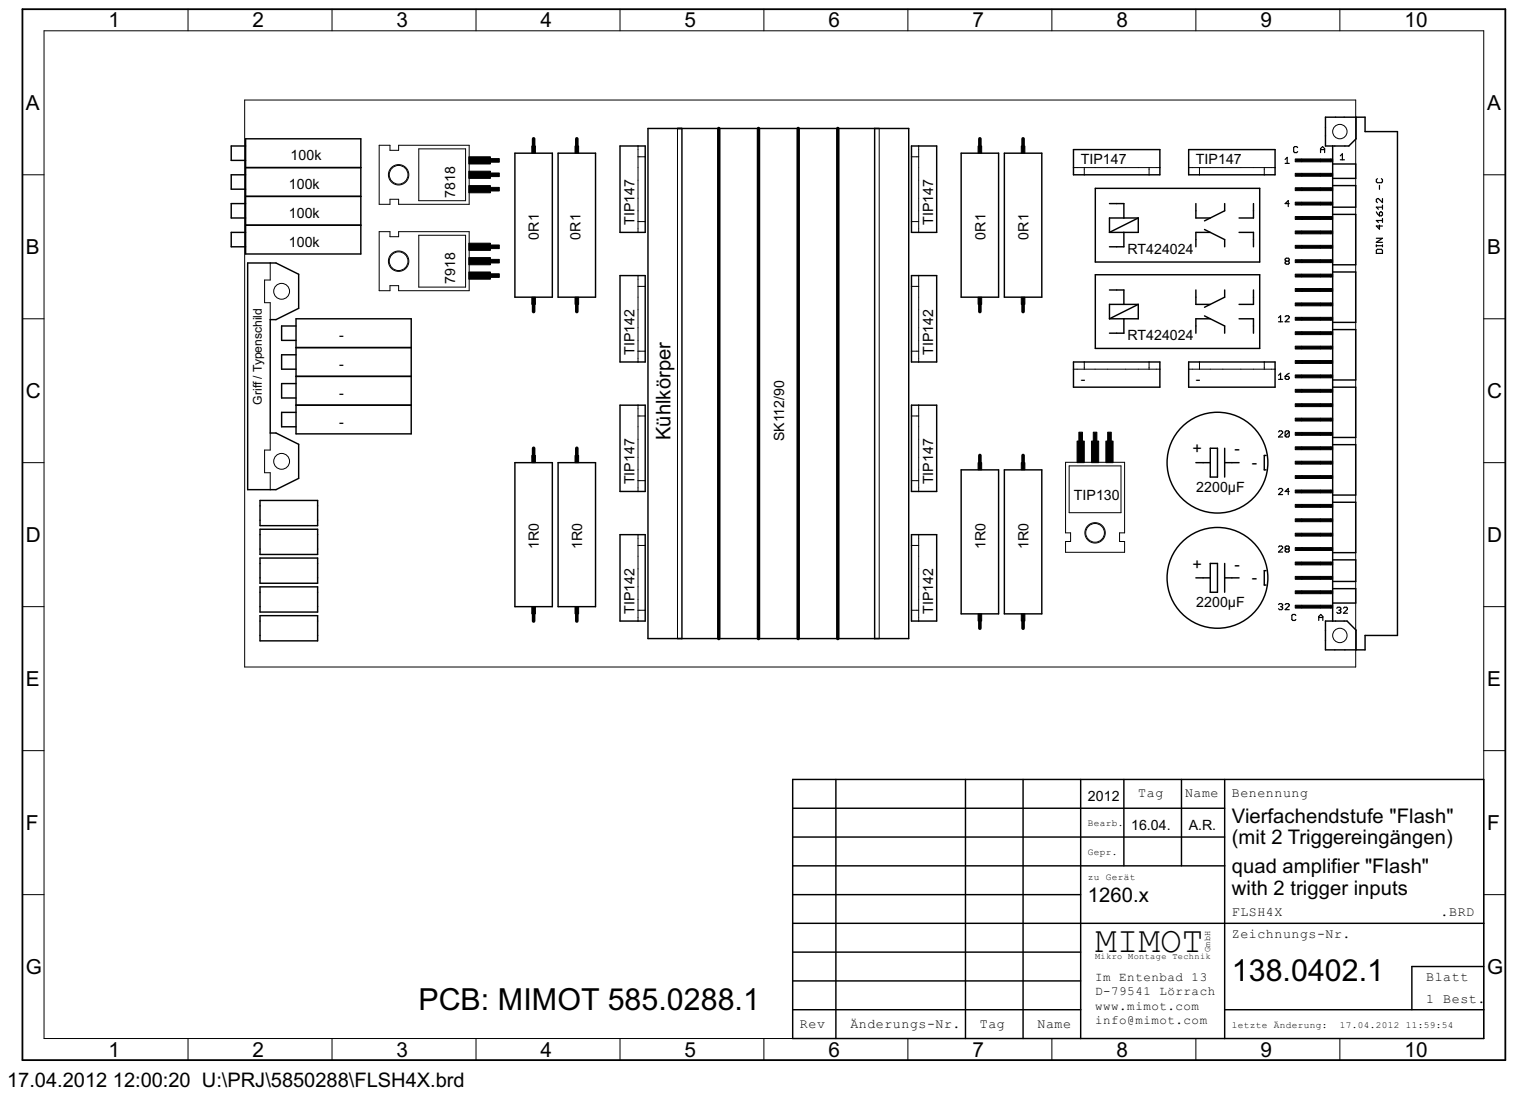
[picture p56: page 20]
17.04.2012 12:00:20 U:\PRJ\5850288\FLSH4X.brd; -+ Griff / Typenschild; Kühlkörper; PCB: MIMOT 585.0288.1; TIP¹⁴⁷; 0R¹ TIP¹⁴²; TIP147; - RT424024 ⁷⁸¹⁸ ⁷⁹¹⁸; 2200µF TIP130; TIP¹⁴⁷ 0R¹; TIP¹⁴² ⁰R¹; TIP¹⁴⁷ 1R⁰; TIP¹⁴² ¹R⁰; 1R⁰ TIP¹⁴²; - SK¹¹²/90; Blatt; 1 Best.

2012 | | | Benennung Vierfachendstufe "Flash" (mit 2 Triggereingängen) quad amplifier "Flash" with 2 trigger inputs FLSH4X .BRD

Gepr. Bearb. | Tag 16.04. A.R. | Name

zu Gerät 1260.x

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

Rev | Änderungs-Nr. | Tag | Name | | letzte Änderung: 17.04.2012 11:59:54

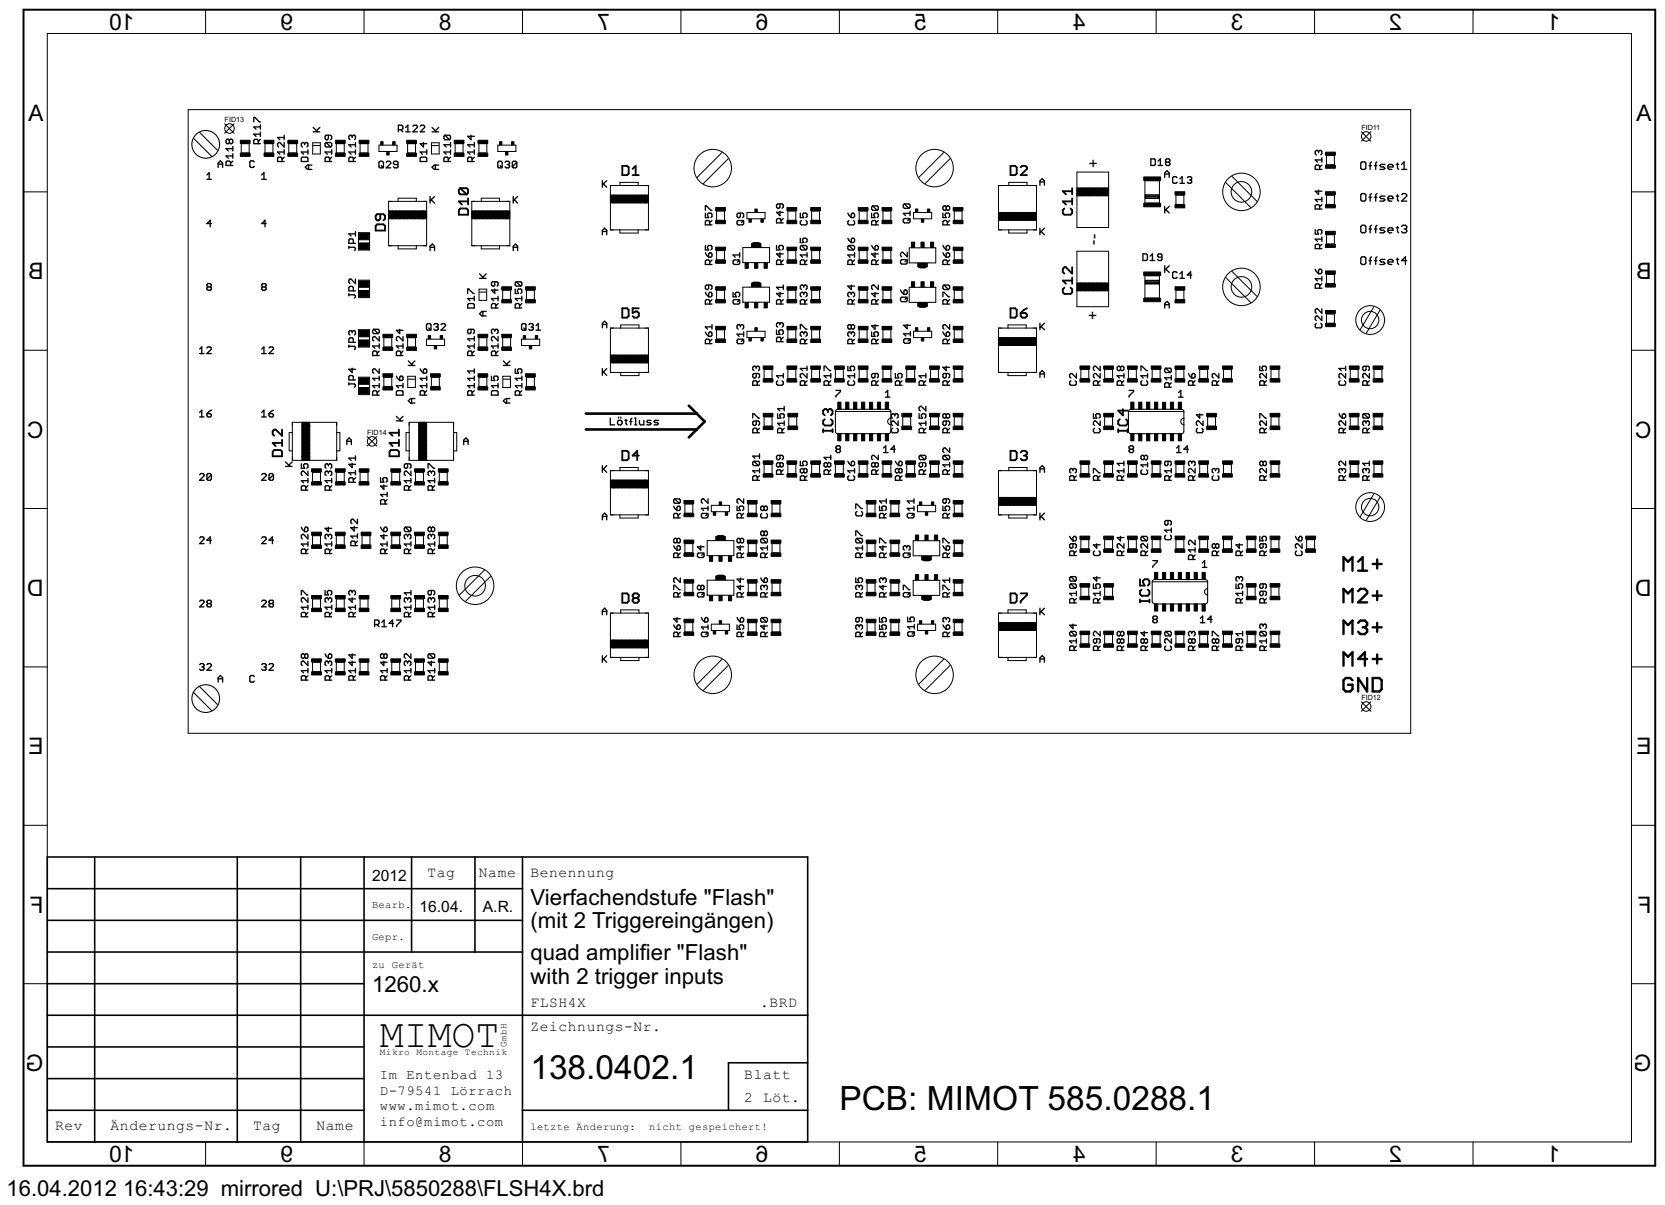
[picture p57: page 21]
16.04.2012 16:43:29 mirrored U:\PRJ\5850288\FLSH4X.brd; FID11; FID12; FID13; FID14; PCB: MIMOT 585.0288.1; Rev; Änderungs-Nr.; Tag; Name; Bearb.; Gepr.; Benennung; Zeichnungs-Nr.; Blatt; FLSH4X; zu Gerät; letzte Änderung:; nicht gespeichert!; .BRD; 2 Löt.

Vierfachendstufe "Flash"
(mit 2 Triggereingängen)
quad amplifier "Flash"
with 2 trigger inputs

info@mimot.com MIMOT Mikro Montage TechnikGmbH

Im Entenbad 13
D-79541 Lörrach
www.mimot.com

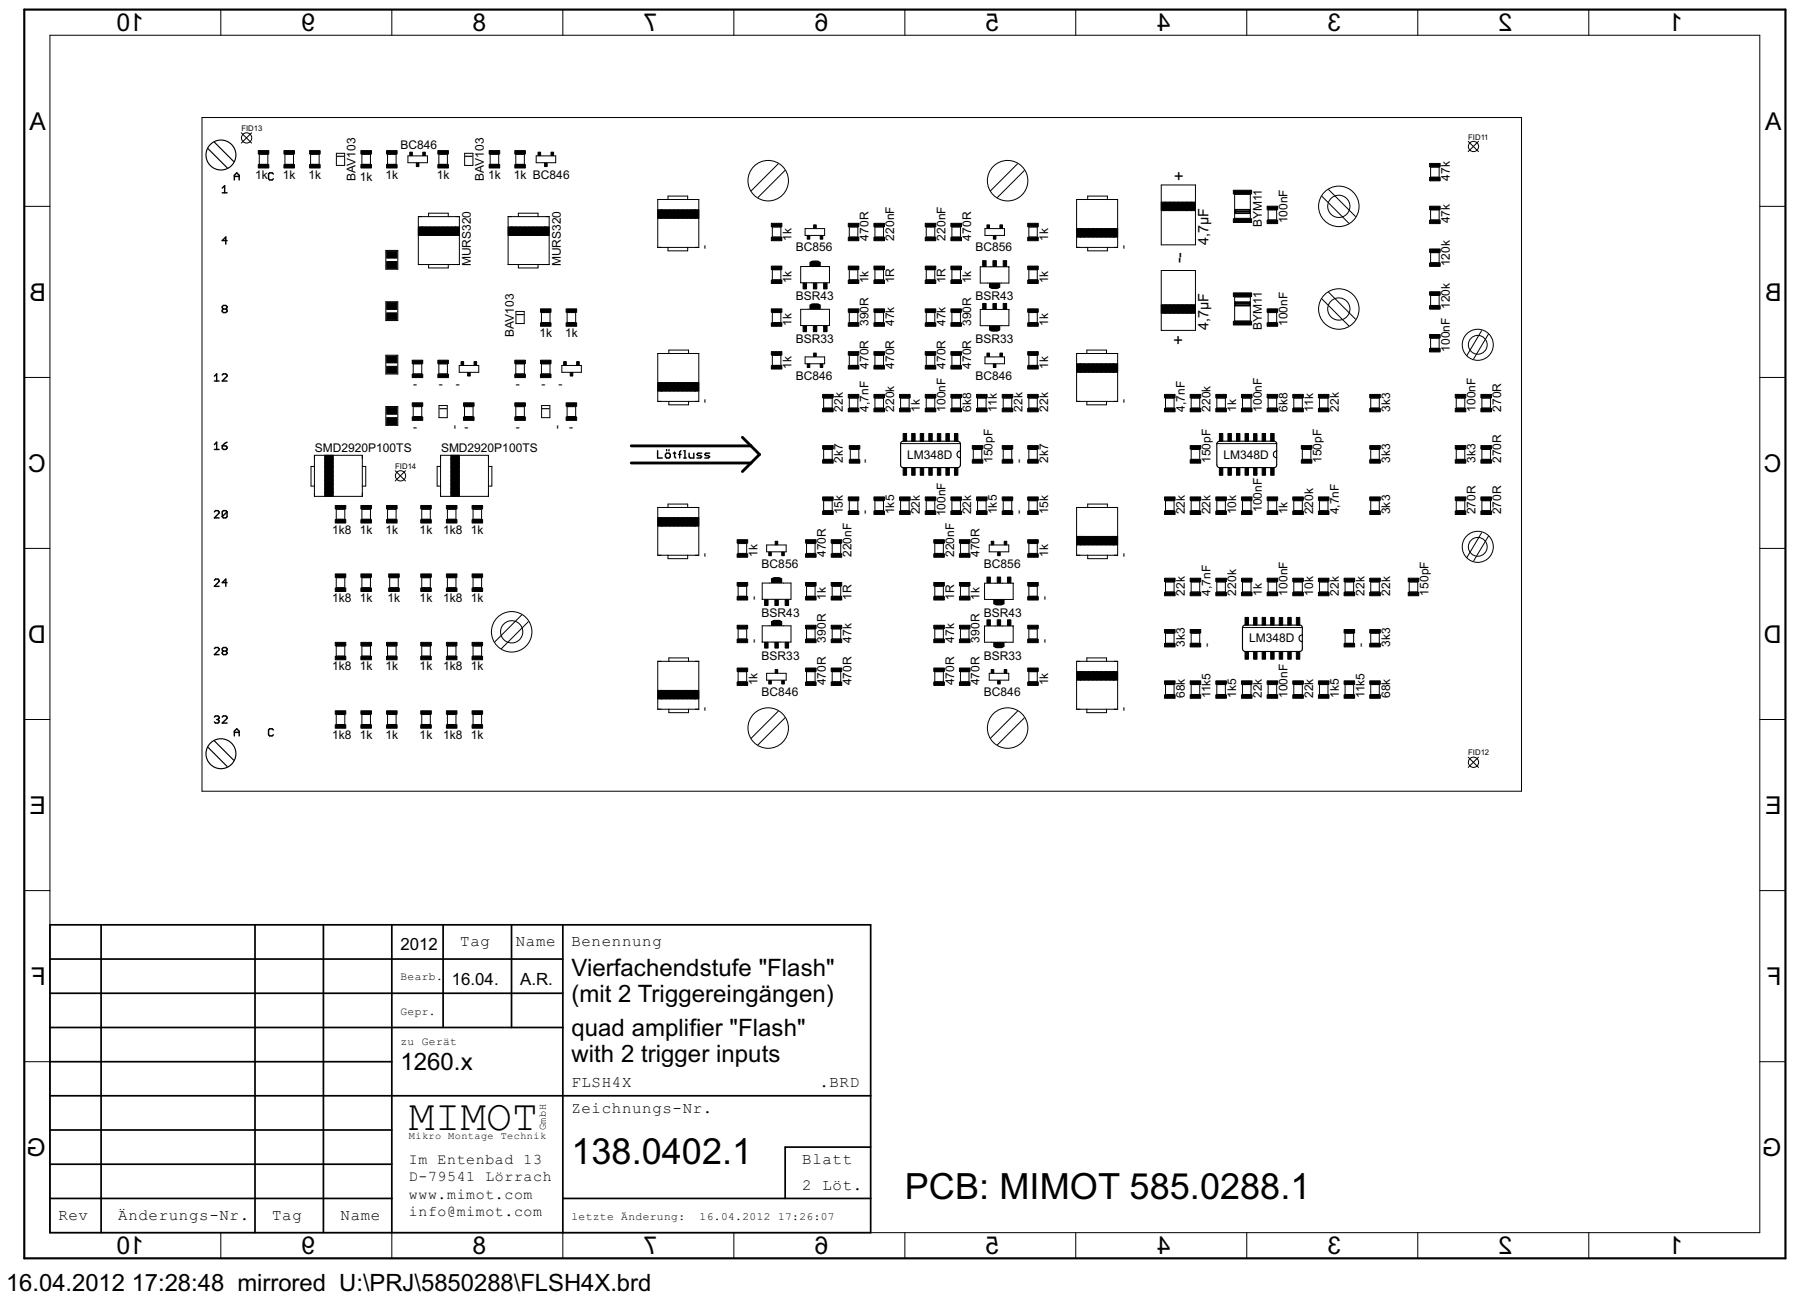
[picture p58: page 22]
16.04.2012 17:28:48 mirrored U:\PRJ\5850288\FLSH4X.brd; FID11; FID12; FID13; FID14; 1k 470R ⁴⁷k; 270R ⁴⁷⁰R 470R ¹k 1k; 1R ²²⁰nF; BAV¹⁰³ 1k 1k; BAV¹⁰³; -1k5 22k 22k 2k7 15k 4,7µF 4,7µF 100nF 100nF 100nF 100nF 100nF 100nF 100nF 100nF 100nF 100nF 1k1k BYM11 BYM11; BSR43 BSR33; - - MURS320; 270R ⁴⁷⁰R 470R; 1k 1k 1R ²²⁰nF; - - MURS320 22k 22k 10k 120k 1k220k 4,7nF 470R 47k 3k3 270R 470R 470R 1k 1k 1R 220nF 1k390R; SMD2920P100TS; PCB: MIMOT 585.0288.1; Blatt; 2 Löt.

2012 | | | Benennung Vierfachendstufe "Flash" (mit 2 Triggereingängen) quad amplifier "Flash" with 2 trigger inputs FLSH4X .BRD

Gepr. Bearb. | Tag 16.04. A.R. | Name

zu Gerät 1260.x

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

Rev | Änderungs-Nr. | Tag | Name | | letzte Änderung: 16.04.2012 17:26:07

BGR: 149630 | Zeichnung: 138.0402.1 | Seite: 1 | Gedruckt: 23.04.2012 13:55 Uhr
Vierfachendstufe fast-flash | MP1260.1+ Rev.2 | Erstellt: 30.03.2012 ar
Geändert: 02.04.2012 ar
Änderungen/Bemerkungen: | Geprueft: 02.04.2012 ar
Als Leistungstransistoren sind verschiedene Typen möglich, nur als Komplementäres Paar, nicht in gemischter Bestückung:
NPN: | PNP:
TIP142 | TIP147
BDW83D | BDW84D
BDW83C | BDW84C
BDV65C | BDV64C
MJH11022G | MJH11021G
MJH11020G | MJH11019G
MJH11018G | MJH11017G
Pos. Gesamtanzahl TeileNr. | Artikelbezeichnung | ZPos. Bestückposition/Bemerkung
===================================================================================================
1 | 1, Stk 149688 | Leiterplatte 585.0288.1 | PCB
Vierfachendstufe (Fast-Flash) ZN: 585.0288.1
2 | 1, Stk 139988 | Messerleiste DIN41612 | ST1
Bauform C 64-pol. abgwinkelt ZN: E-ST-ML-C-64PCB
3 | 1, Stk 140157 | Kartengriff gelb transparent | KS1
z. B. Schroff 60817-050
ZN: MÜKG-60817-50 | VPE = 10 Stück
4 | 1, Stk 138878 | Strangkühlkörper 46x33x90mm | KK1
PCB-Montage für TO220 o.Ä. ZN: E-EM-KK-SK112-90SA schwarz eloxiert ~3,0K/W
z.B. Fischer SK112 90SA
5 | 8, Stk 127346 | Isolierbuchse M3 d=3,5mm | (Q17 - Q24)
z. B. Fischer IB6
ZN: E-EM-IB6
6 | 8, Stk 127738 | Wärmeleitfolie TO 3 PF / TO247 | (Q17 - Q24)
GF-verstärkt, 0,15mm, 3kV,
ZN: E-EM-WB3P | 0,34K/W, 1,43W/mK (pro Inch²)
z.B. Fischer WB 3 P
7 | 4, Stk 133072 | Prüfbuchse 2mm RM10 rot | BU1 - BU4
z.B. Hirschmann MPB1-RT
ZN: E-ST-MPB1-RT
8 | 1, Stk 133073 | Prüfbuchse 2mm RM10 schwarz | BU5
z.B. Hirschmann MPB1-SW
ZN: E-ST-MPB1-SW
9 | 1, Stk 130128 | Hinweisaufkleber | zu Pos.3: in Kartenschild
Typ / Beschriftung ->Kommentar | Beschriftung max. 7x37mm in
ZN: E-DOC-Labelinfo | Serifenlose Schrift Höhe >=3mm
Beschriftung: " 138.0402.1 " ---------------------------------------------------------------------------------------------------
10 | 4, Stk 127231 | Kerko 1206 4,7nF/100V 10% | C1 - C4
ZN: E-C-1206-4,7nF/100V
11 | 4, Stk 127225 | Kerko 1206 220nF/50V 10% X7R | C5 - C8
ZN: E-C-1206-220nF/50V
12 | 2, Stk 127840 | Elko 2200µF/50V 85°C RM7,6 | C9, C10
Radial, D<=18mm, L<=38mm
ZN: E-C-Elko-2200uF/50V
13 | 2, Stk 127263 | Tantal-C 6032 4,7µF/35V 20% | C11, C12
ZN: E-C-TA-C-4,7uF/35V
14 | 10, Stk 127214 | Kerko 1206 100nF/50V 10% X7R | C13 - C22
ZN: E-C-1206-100nF/50V
15 | 2, Stk 127903 | Gleichrichterdiode 1A/1000V | D18, D19
Melf
ZN: E-D-Melf-1A/1000V z.B.: BYM11-1000 ---------------------------------------------------------------------------------------------------

===================================================================================================
(C) MIMOT Mikro Montage Technik GmbH, Im Entenbad 13 , 79541 Lörrach-Hauingen | ar | >>>>>

BGR: 149630 | Zeichnung: 138.0402.1 | Seite: 2 | Gedruckt: 23.04.2012 13:55 Uhr
Vierfachendstufe fast-flash | MP1260.1+ Rev.2 | Erstellt: 30.03.2012 ar
Pos. Gesamtanzahl TeileNr. | Artikelbezeichnung | ZPos. Bestückposition/Bemerkung
===================================================================================================
16 | 3, Stk 127897 | Universaldiode SOD-80 | D13, D14, D17
250mA/200V BAV103
ZN: E-D-SOD80-BAV103
17 | 2, Stk 129993 | PCB-Relais RT2 DPDT 5/6VDC | Rel1, Rel2
2x 8A/250VAC/30VDC, H=15,9mm
ZN: E-REL-RT2-5VDC | z.B. TE RT424005, RT424006
Omron G2RL245DC
18 | 1, Stk 130437 | Spannungsregler linear +18V/1A | IC1
5% TO220 7818-kompatibel
ZN: E-IC-7818-TO220
19 | 1, Stk 130443 | Spannungsregler linear -18V/1A | IC2
5% TO220 7918-kompatibel
ZN: E-IC-7918-TO220
20 | 3, Stk 129096 | 4xOPAmp Bipolar SO14 | IC3, IC4, IC5
1MHz, 0,5V/µs, +-5V...+-18V
ZN: E-IC-LM348D | z.B.: LM348D
21 | 4, Stk 129656 | Spindeltrimmer 19mm 100k 10% | P1 - P4
15-Gang 0,75W linear
ZN: E-Poti-19mm-100k
22 | 4, Stk 130218 | NPN-Transistor SOT-89 1A/80V | Q1 - Q4
1,35W, 100MHz, hfe>=100
ZN: E-T-BSR43 | z.B. NXP BSR43
23 | 4, Stk 130685 | PNP-Transistor SOT-89 1A/80V | Q5 - Q8
1,35W, 100MHz, hfe=100...300
ZN: E-T-BSR33 | z.B. NXP BSR33
24 | 4, Stk 130683 | Transistor PNP SOT23 65V/100mA | Q9 - Q12
hFE=200...450, fT=150MHz
ZN: E-T-BC856B | BC856B
25 | 6, Stk 130682 | Transistor NPN SOT23 65V/100mA | Q13 - Q16, Q29, Q30
hFE=200...450, fT=300MHz
ZN: E-T-BC846B | BC846B
26 | 6, Stk 130417 | Darlington PNP TO218/SOT93 | Q17 - Q20, Q25, Q26
10A/100V, hFe>=1000, 125W
ZN: E-T-TIP147 | z.B. STM TIP147
27 | 4, Stk 130415 | Darlington NPN TO218/SOT93 | Q21 - Q24
10A/100V, hFe>=1000, 125W
ZN: E-T-TIP142 | z.B. STM TIP142
28 | 1, Stk 130414 | NPN-Darlington TO220 | Q33
8A/80V, hfe=1000-15000, 70W
ZN: E-T-TIP131 | z.B. TIP131
30 | 14, Stk 129931 | Widerstand 1206 22k 5% | R1 - R4, R7, R8, R81 - R84,
R93 - R96
ZN: E-R-1206-22k-5%
31 | 2, Stk 129912 | Widerstand 1206 11k 5% | R5, R6
ZN: E-R-1206-11k-5%
32 | 2, Stk 129958 | Widerstand 1206 6k8 5% | R9, R10
ZN: E-R-1206-6k8-5%
33 | 2, Stk 129910 | Widerstand 1206 10k 5% | R11, R12
ZN: E-R-1206-10k-5%
34 | 2, Stk 129956 | Widerstand 1206 68k 5% | R103, R104
ZN: E-R-1206-68k-5%

===================================================================================================
(C) MIMOT Mikro Montage Technik GmbH, Im Entenbad 13 , 79541 Lörrach-Hauingen | ar | >>>>>

BGR: 149630 | Zeichnung: 138.0402.1 | Seite: 3 | Gedruckt: 23.04.2012 13:55 Uhr
Vierfachendstufe fast-flash | MP1260.1+ Rev.2 | Erstellt: 30.03.2012 ar
Pos. Gesamtanzahl TeileNr. | Artikelbezeichnung | ZPos. Bestückposition/Bemerkung
===================================================================================================
35 | 2, Stk 129964 | Widerstand 1206 120k 1% | R15, R16
ZN: E-R-1206-120k-1%
36 | 46, Stk 129923 | Widerstand 1206 1K 5% | R17-R20, R45-R48, R57-R66,
R69, R70, R109, R110, R113,
ZN: E-R-1206-1k-5% | R114, R117, R118, R121, R122,
R133-R150
37 | 4, Stk 129929 | Widerstand 1206 220k 5% | R21 - R24
ZN: E-R-1206-220k-5%
38 | 6, Stk 129943 | Widerstand 1206 3k3 5% | R25 - R28, R99, R100
ZN: E-R-1206-3k3-5%
39 | 4, Stk 129934 | Widerstand 1206 270R 5% | R29 - R32
ZN: E-R-1206-270R-5%
40 | 6, Stk 129947 | Widerstand 1206 47k 5% | R13, R14, R33 - R36
ZN: E-R-1206-47k-5%
41 | 12, Stk 129946 | Widerstand 1206 470R 5% | R37 - R40, R49 - R56
ZN: E-R-1206-470R-5%
42 | 4, Stk 129941 | Widerstand 1206 390R 5% | R41 - R44
ZN: E-R-1206-390R-5%
43 | 4, Stk 129726 | Widerstand 208-8 R1 10% 5W | R73, R74, R77, R78
Zementwiderstand 6,4x6,4x25mm ZN: E-R-208-8-R1
44 | 4, Stk 129722 | Widerstand 208-8 1R 10% 5W | R75, R76, R79, R80
Zementwiderstand 6,4x6,4x25mm ZN: E-R-208-8-1R
45 | 4, Stk 129925 | Widerstand 1206 1k5 5% | R85 - R88
ZN: E-R-1206-1k5-5%
46 | 2, Stk 129913 | Widerstand 1206 11k5 1% | R91, R92
(Optimal R=11,70k)
ZN: E-R-1206-11k5-1%
47 | 2, Stk 129937 | Widerstand 1206 2k7 5% | R97, R98
ZN: E-R-1206-2k7-5%
48 | 2, Stk 129918 | Widerstand 1206 15k 5% | R101, R102
ZN: E-R-1206-15k-5%
49 | 4, Stk 129928 | Widerstand 1206 1R 5% | R105 - R108
ZN: E-R-1206-1R-5%
51 | 8, Stk 129926 | Widerstand 1206 1k8 5% | R125 - R132
ZN: E-R-1206-1k8-5%
54 | 2, Stk 127917 | Ultrafast Rectifier 3A/200V | D9, D10
DO-214AB / SMC
ZN: E-D-MURS320T3 | MURS320, ES3D
55 | 2, Stk 128110 | Multifuse 1,1A/33V | D11, D12
Wickmann SMD2920P100TS,
ZN: E-F-SMD2920P100TS Littlefuse 2920L100PR,
Bourns MF-SM100/33-2
58 | 4, Stk 127219 | Kerko 1206 150pF/100V 5% NPO | C23 - C26
in Layout 585.0288.0:
ZN: E-C-1206-150pF/100V | parallel zu R5 - R8
60 | 2, Stk 135619 | Linsenkopfschraube DIN 7985A, | zu Pos.3 : KS1
M2,5x08 NI
ZN: MDIN-7985-M02,5x08-N

===================================================================================================
(C) MIMOT Mikro Montage Technik GmbH, Im Entenbad 13 , 79541 Lörrach-Hauingen | ar | >>>>>

BGR: 149630 | Zeichnung: 138.0402.1 | Seite: 4 | Gedruckt: 23.04.2012 13:55 Uhr
Vierfachendstufe fast-flash | MP1260.1+ Rev.2 | Erstellt: 30.03.2012 ar
Pos. Gesamtanzahl TeileNr. | Artikelbezeichnung | ZPos. Bestückposition/Bemerkung
===================================================================================================
61 | 2, Stk 135620 | Linsenkopfschraube DIN 7985A, | zu Pos.2 : ST1
M2,5x10 NI
ZN: MDIN-7985-M02,5x10-N
62 | 4, Stk 134921 | Sechskantmutter DIN 934, M2,5 | zu Pos.2,3 : ST1, KS1
NI
ZN: MDIN-0934-M02,5-NI
63 | 3, Stk 134927 | Sechskantmutter DIN 934, M3 NI | zu Pos.18,19,28: IC1, IC2, Q33
ZN: MDIN-0934-M03-NI
64 | 3, Stk 135634 | Linsenkopfschraube DIN 7985A, | zu Pos.18,19,28: IC1, IC2, Q33
M3x6 NI
ZN: MDIN-7985-M03x06-NI
65 | 12, Stk 135635 | Flachkopfschraube DIN 7985A, | zu Pos. 4, 26, 27 :
M3x8-NI | KK1, Q17 - Q24
ZN: MDIN-7985-M03x08-NI
66 | 4, Stk 137862 | Unterlegscheibe 3,2 x 7 x 0,5 | zu Pos.4 : KK1
DIN125, Polyamid 6, natur
ZN: MMMO-0303036 | z.B. Ettinger 3.03.036

===================================================================================================
(C) MIMOT Mikro Montage Technik GmbH, Im Entenbad 13 , 79541 Lörrach-Hauingen | ar | >###<

# Strombegrenzung 4x Endstufe
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
