marka87/GRAF_MNP/DOKU-STUFF/DOKU WORK/Mimot Endstufen für Ansteuerung/Endstufe-Zweifach-138-0378-0.pdf

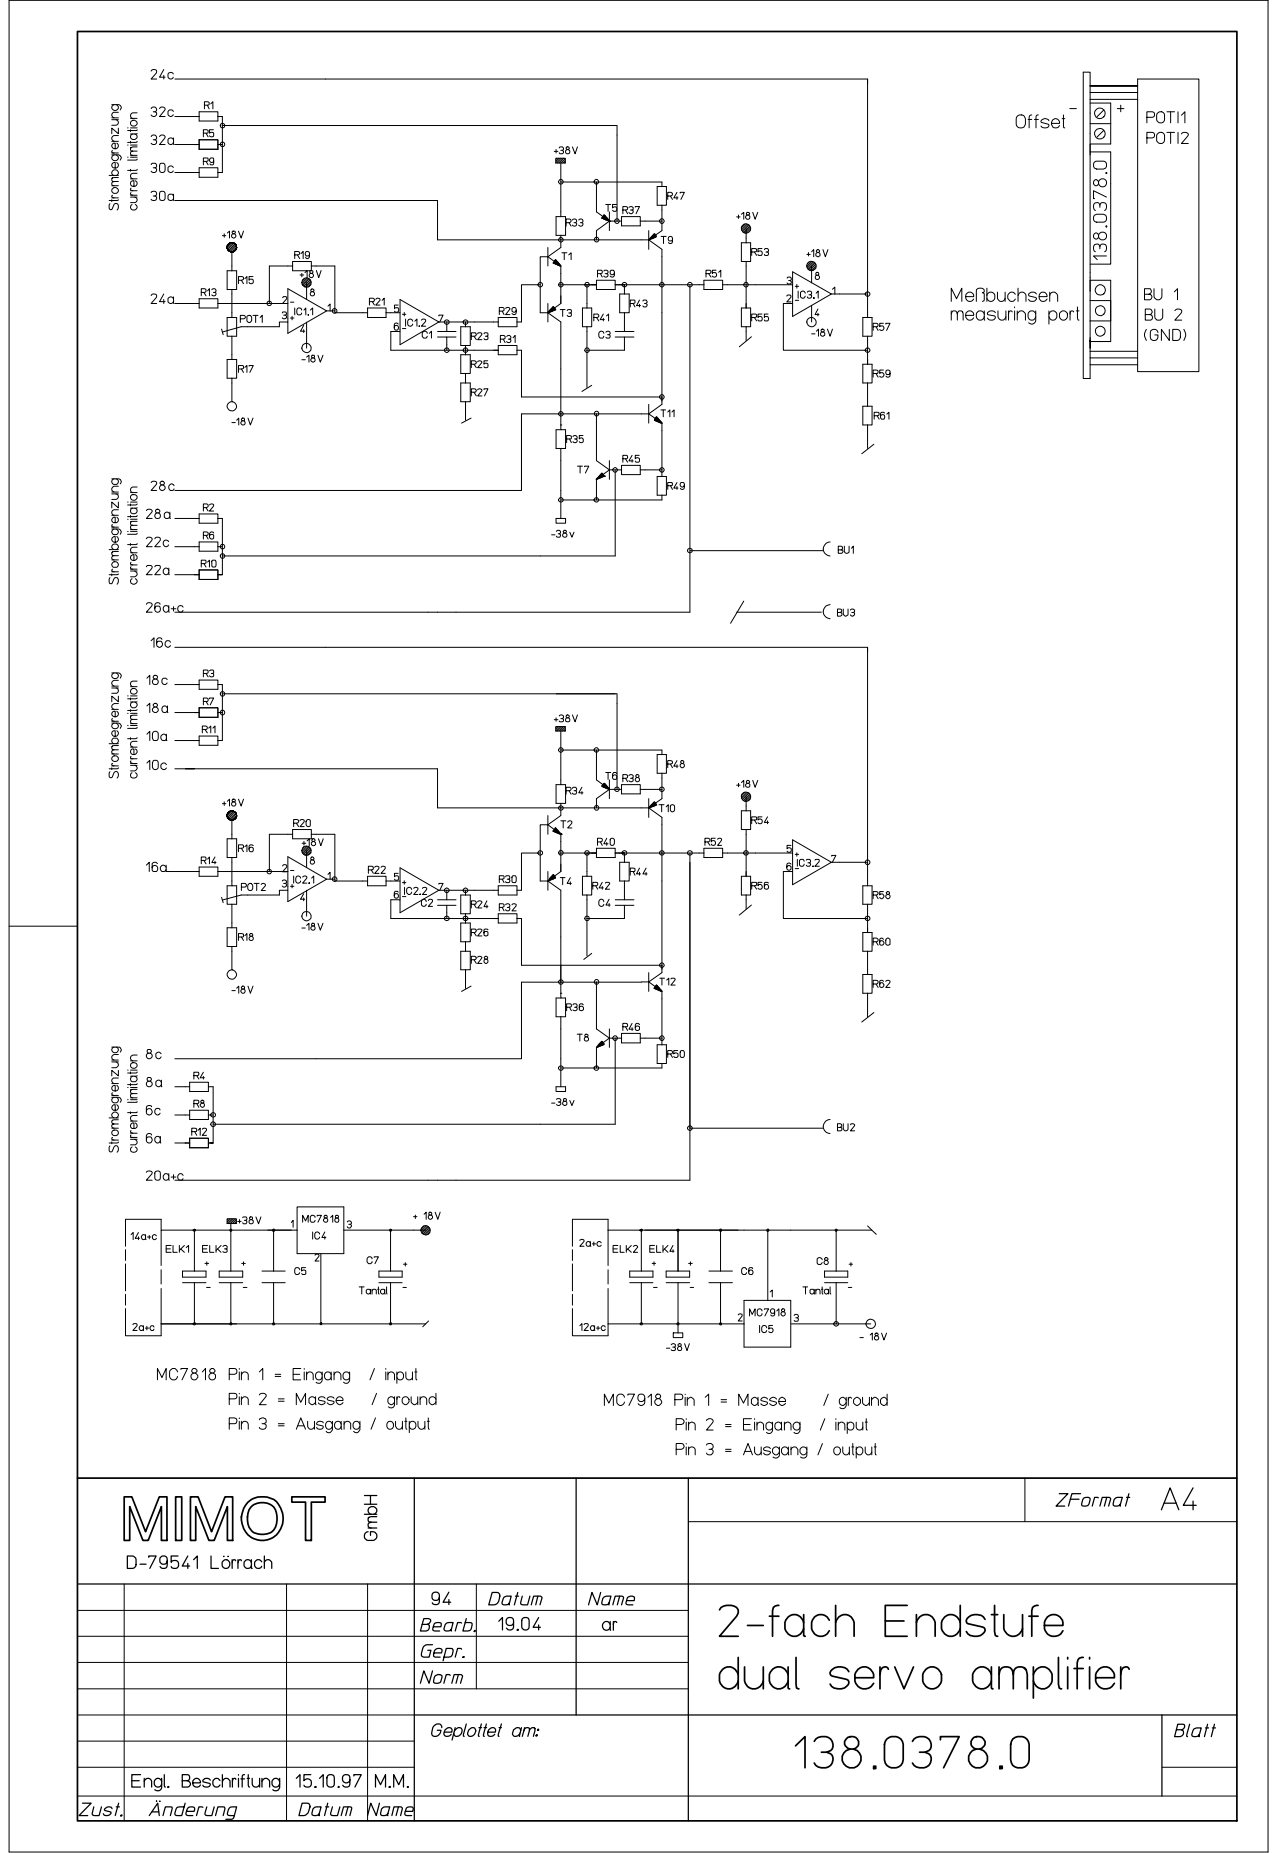
[picture p59: page 1]

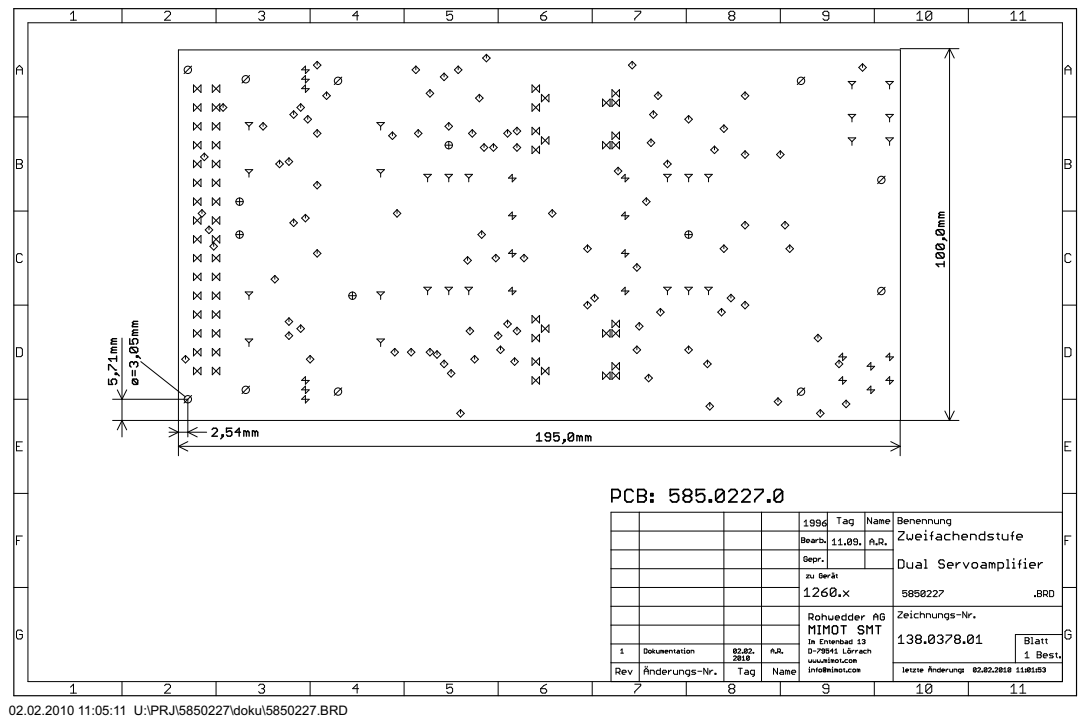
[picture p60: page 2]

02.02.2010 11:05:11 U:\PRJ\5850227\doku\5850227.BRD

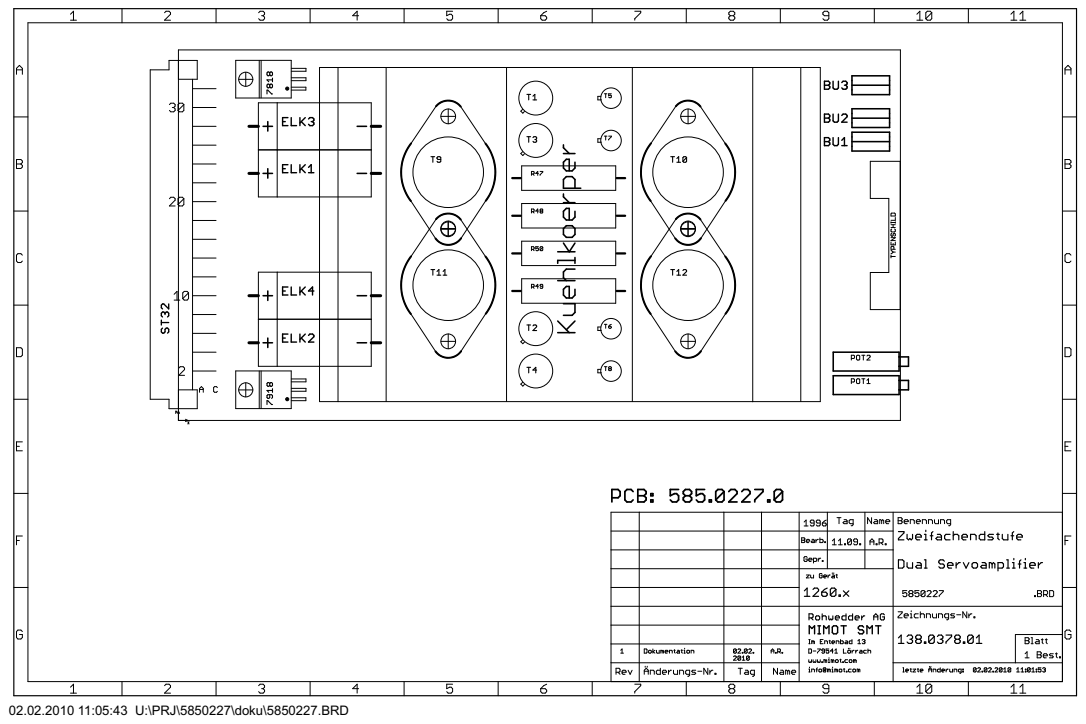
[picture p61: page 3]

02.02.2010 11:05:43 U:\PRJ\5850227\doku\5850227.BRD

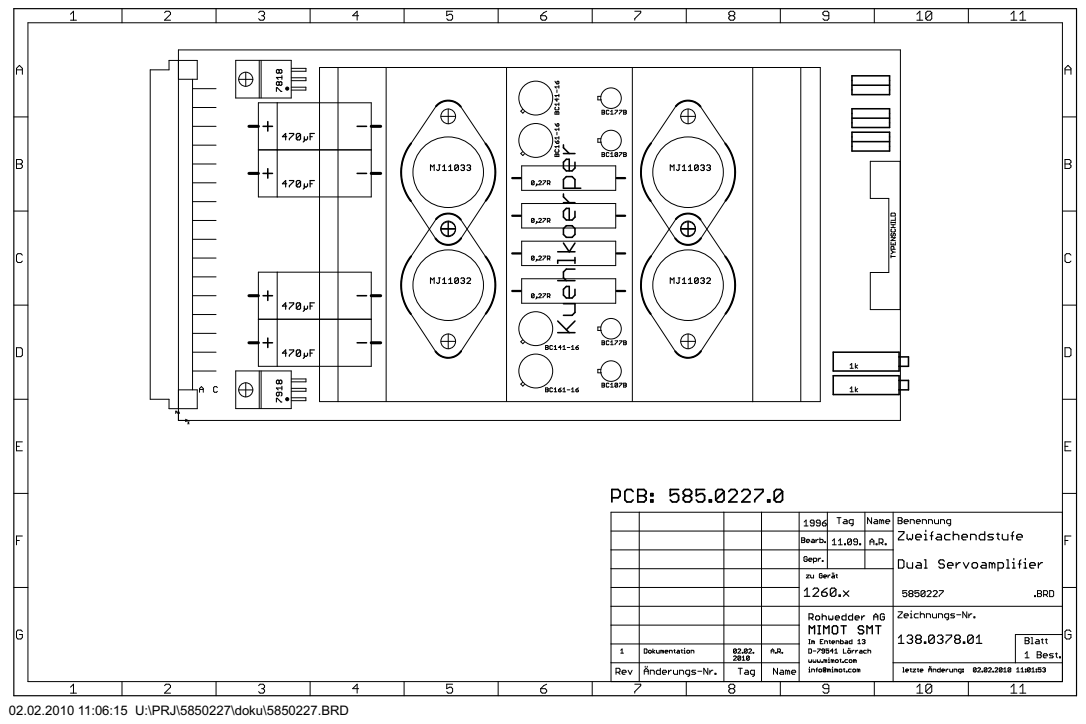
[picture p62: page 4]

02.02.2010 11:06:15 U:\PRJ\5850227\doku\5850227.BRD

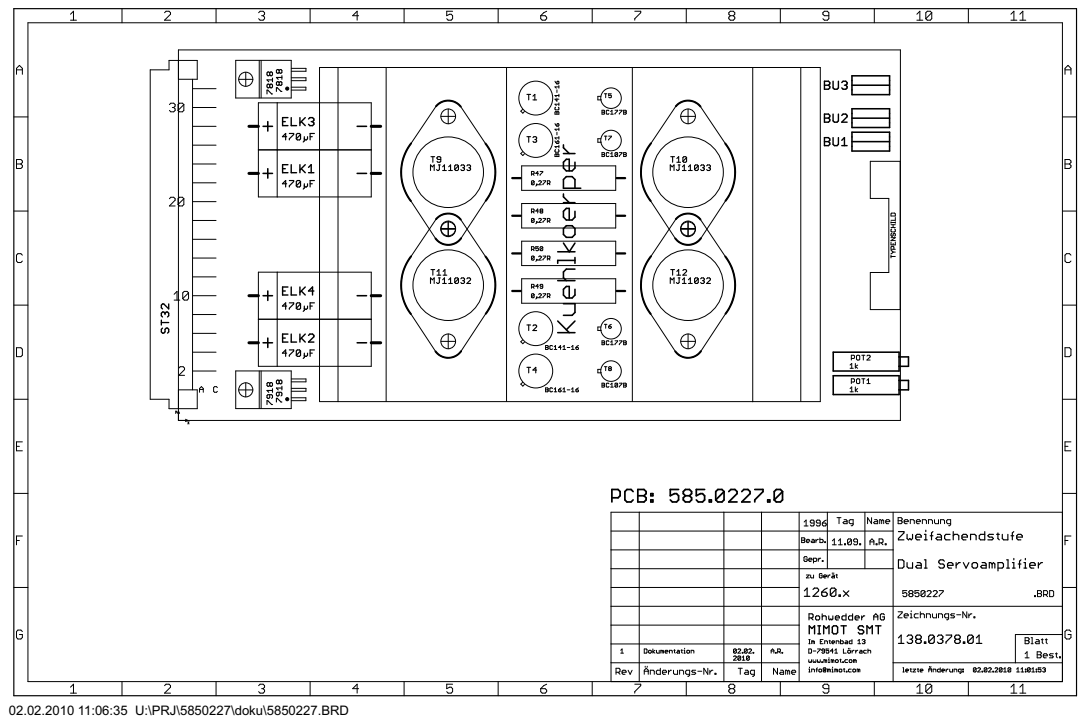
[picture p63: page 5]

02.02.2010 11:06:35 U:\PRJ\5850227\doku\5850227.BRD

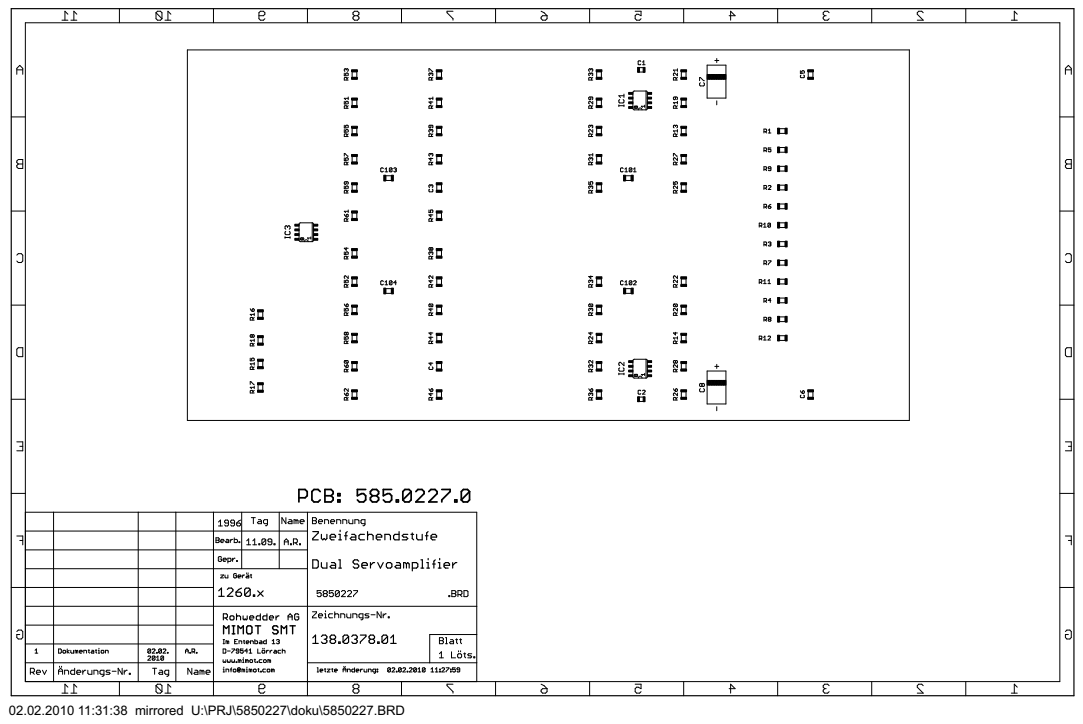
[picture p64: page 6]

02.02.2010 11:31:38 mirrored U:\PRJ\5850227\doku\5850227.BRD

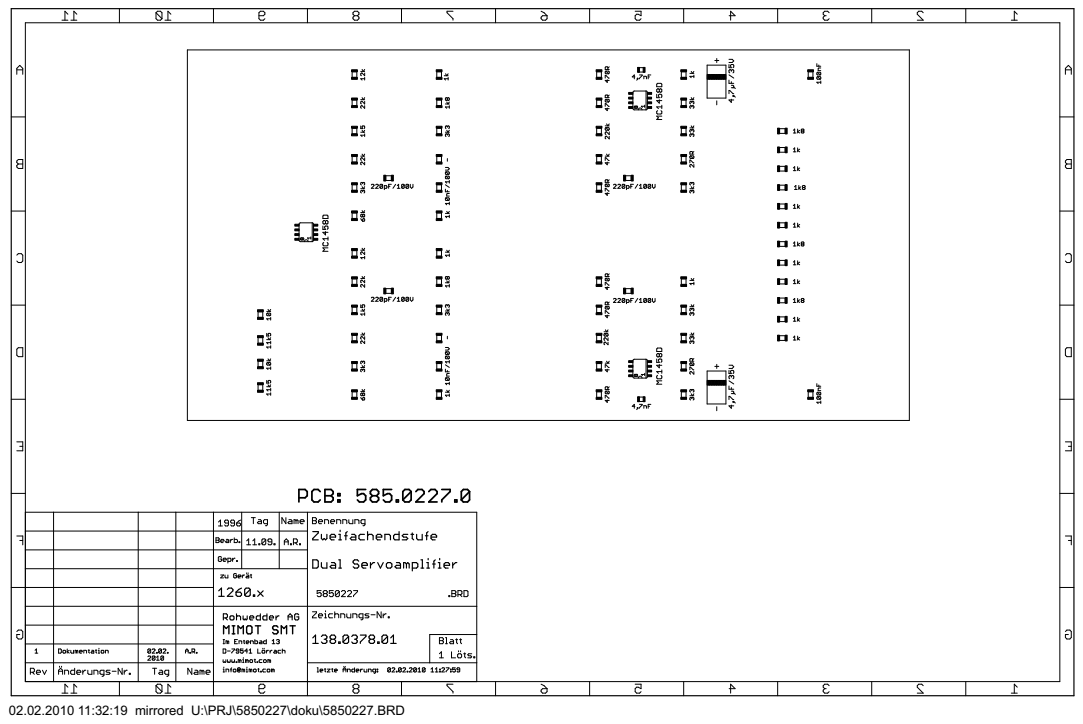
[picture p65: page 7]

02.02.2010 11:32:19 mirrored U:\PRJ\5850227\doku\5850227.BRD

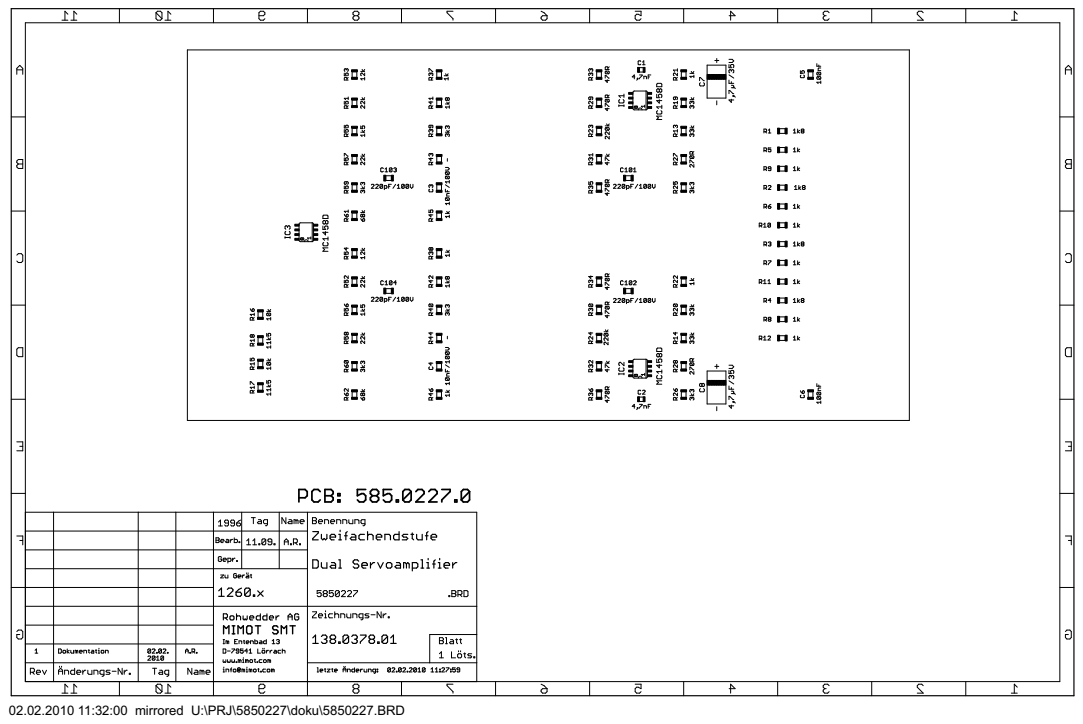
[picture p66: page 8]

02.02.2010 11:32:00 mirrored U:\PRJ\5850227\doku\5850227.BRD

BGR: 106112 | Zeichnung: 138.0378.01 | Seite: 1 | Gedruckt: 23.11.2011 17:04 Uhr
Zweifachendstufe 1260 | Erstellt: 26.06.2008
Geändert: 25.01.2010 ar
Änderungen/Bemerkungen: | Geprueft: 25.01.2010 ar
Änderung 138.0378.0 -> 138.0378.01
Position 38: Kondensatoren 0805 220pF/100V werden zwischen Basis und Collector der Leistungstransistoren T9 - T12 gelötet!
Pos. Gesamtanzahl TeileNr. | Artikelbezeichnung | ZPos. Bestückposition/Bemerkung
===================================================================================================
1 | 1, Stk 129140 | Leiterplatte 585.0227.0 | PCB
Zweifach-Endstufe 1260
ZN: 585.0227.0
2 | 1, Stk 139989 | Messerleiste DIN41612 Bauform | ST1
32-pol. Typ D abgewinkelt
ZN: E-ST-ML-D-32PCN
3 | 1, Stk 140157 | Kartengriff gelb transparent | MM1
z. B. Schroff 60817-050
ZN: MÜKG-60817-50 | VPE = 10 Stück
4 | 1, Stk 130404 | Strangkühlkörper 135x25x90mm | KK1
für 2x TO3-Montage
ZN: E-EM-KK-SK60-90SA schwarz elox. 1,4K/W
z.B. Fischer SK60 90SA
5 | 4, Stk 137512 | Abstandsbolzen M3x15 | KK1
Ettinger 05.13.151
ZN: MMAB-5.13.151
6 | 4, Stk 130964 | Ringkabelschuh 0,5-1,0mm² | (T9 - T12 Collector)
für M3 (rot)
ZN: E-KL-RK-R-3
7 | 4, Stk 134260 | Sechskantmutter flach DIN | KK1
439, M3 NI
ZN: MDIN-0439-M03-NI
8 | 2, Stk 135608 | Linsenkopfschraube DIN 7985A, | MM1
M2,5x6 NI
ZN: MDIN-7985A-M02,5x06
9 | 2, Stk 135620 | Linsenkopfschraube DIN 7985A, | ST1
M2,5x10 NI
ZN: MDIN-7985-M02,5x10-N
10 | 6, Stk 135634 | Linsenkopfschraube DIN 7985A, | KK1, IC4, IC5
M3x6 NI
ZN: MDIN-7985-M03x06-NI
11 | 4, Stk 135636 | Linsenkopfschraube DIN 7985A, | T9 - T12
M3x10 NI
ZN: MDIN-7985-M03x10-NI
12 | 4, Stk 135638 | Linsenkopfschraube DIN 7985A, | T9 - T12
M3x16 NI
ZN: MDIN-7985-M03x16-NI
13 | 4, Stk 134921 | Sechskantmutter DIN 934, M2,5 | ST1, MM1
NI
ZN: MDIN-0934-M02,5-NI
14 | 18, Stk 134927 | Sechskantmutter DIN 934, M3 NI | KK1, IC4, IC5, T9 - T12
ZN: MDIN-0934-M03-NI
15 | 0,6 m | 130302 | Schaltlitze H05VK 0,5mm² rot | T9 - T12 Collector
ZN: E-K-H05VK0,5-rot
16 | 0,6 m | 130296 | Schaltlitze H05VK 0,5mm² blau | T9 - T12 Emitter
ZN: E-K-H05VK0,5-blau
17 | 0,6 m | 130300 | Schaltlitze H05VK 0,5mm² grün | T9 - T12 Basis
ZN: E-K-H05VK0,5-grün

===================================================================================================
(C) MIMOT Mikro Montage Technik GmbH, Im Entenbad 13 , 79541 Lörrach-Hauingen | ar | >>>>>

BGR: 106112 | Zeichnung: 138.0378.01 | Seite: 2 | Gedruckt: 23.11.2011 17:04 Uhr
Zweifachendstufe 1260 | Erstellt: 26.06.2008
Pos. Gesamtanzahl TeileNr. | Artikelbezeichnung | ZPos. Bestückposition/Bemerkung
===================================================================================================
18 | 0,2 m | 136921 | Schrumpfschlauch 2:1 | T9 - T12 Basis & Emitter
| | | 2,4mm schwarz
ZN: E-K-Shrinktube-2,4mm
20 | 8, Stk 127345 | Isolierbuchse M3 d=3,9mm | T9- T12
| | | H = 4,7/3,2mm
| ZN: E-EM-IB1 | | z.B. Fischer IB1
21 | 4, Stk 137203 | Wärmeleitfolie Silikon TO3 | T9 - T12
| | | 0,3mm, 0,4k/W
| ZN: E-EM-WS3 | | Fischer WS 3
22 | 2, Stk 133072 | Prüfbuchse 2mm RM10 rot | BU1, BU2
| | | z.B. Hirschmann MPB1-RT
ZN: E-ST-MPB1-RT
23 | 1, Stk 133073 | Prüfbuchse 2mm RM10 schwarz | BU3
| | | z.B. Hirschmann MPB1-SW
ZN: E-ST-MPB1-SW
24 | 1, Stk 130437 | Spannungsregler linear +18V/1A | IC4
| | | 5% TO220 7818-kompatibel
ZN: E-IC-7818-TO220
25 | 1, Stk 130443 | Spannungsregler linear -18V/1A | IC5
| | | 5% TO220 7918-kompatibel
ZN: E-IC-7918-TO220
26 | 3, Stk 130376 | Operationsverstärker 2-fach | IC1 - IC3
| | | SO8 10..30V 1MHz 0,5V/µs
ZN: E-IC-MC1458D | z.B. MC1458D
27 | 2, Stk 130204 | Transistor NPN TO39 60V/1A | T1, T2
| | | 0,8W fT=50MHz B=100..250
ZN: E-T-BC141-16 | BC141-16
28 | 2, Stk 130205 | Transistor PNP TO39 60V/1A | T3, T4
| | | 0,8W fT=50MHz B=100..250
ZN: E-T-BC161-16 | BC161-16
29 | 2, Stk 130207 | Transistor PNP TO18 45V/0,2A | T5, T6
| | | 0,6W fT=200MHz B=180..460
| ZN: E-T-BC177B | | BC177B
30 | 2, Stk 130203 | Transistor NPN TO18 45V/0,2A | T7, T8
| | | 0,6W fT=200MHz B=180..460
| ZN: E-T-BC107B | | BC107B
31 | 2, Stk 130381 | Darlingtontransistor PNP TO3 | T9, T10
| | | 120V/50A 300W hfe>=1000
ZN: E-T-MJ11033 | MJ11033
32 | 2, Stk 130380 | Darlingtontransistor NPN TO3 | T11, T12
| | | 120V/50A 300W hfe>=1000
ZN: E-T-MJ11032 | MJ11032
33 | 2, Stk 127230 | Kerko 0805 4,7nF/50V 10% | C1, C2
ZN: E-C-0805-4,7nF/50V
34 | 2, Stk 127828 | Kerko 1206 10nF/100V 5% X7R | C3, C4
ZN: E-C-1206-10nF/100V
35 | 4, Stk 127833 | Elko 470µF/40V 85°C | ELK1 - ELK4
| | | Axial d=10 l=25
ZN: E-C-470µF/40V-105°C-
36 | 2, Stk 127263 | Tantal-C 6032 4,7µF/35V 20% | C9, C10
| | | | Alternativ: 130680
ZN: E-C-TA-C-4,7uF/35V

===================================================================================================
(C) MIMOT Mikro Montage Technik GmbH, Im Entenbad 13 , 79541 Lörrach-Hauingen | ar | >>>>>

BGR: 106112 | Zeichnung: 138.0378.01 | Seite: 3 | Gedruckt: 23.11.2011 17:04 Uhr
Zweifachendstufe 1260 | Erstellt: 26.06.2008
Pos. Gesamtanzahl TeileNr. | Artikelbezeichnung | ZPos. Bestückposition/Bemerkung
===================================================================================================
37 | 2, Stk 127214 | Kerko 1206 100nF/50V 10% X7R | C5, C6
ZN: E-C-1206-100nF/50V
38 | 4, Stk 127247 | Kerko 1206 220pF/100V 5% NPO | ohne Position an T9 - T12
zwischen Basis und Collector ZN: E-C-1206-220pF/100V
39 | 2, Stk 129658 | Spindeltrimmer 19mm 1k 10% | POT1, POT2
15-Gang 0,75W linear
ZN: E-Poti-19mm-1k
40 | 6, Stk 129926 | Widerstand 1206 1k8 5% | R1 - R4, R41, R42
ZN: E-R-1206-1k8-5%
41 | 14, Stk 129923 | Widerstand 1206 1K 5% | R5 - R12, R21, R22, R37, R38,
R45, R46
ZN: E-R-1206-1k-5%
45 | 4, Stk 129939 | Widerstand 1206 33k 5% | R13, R14, R19, R20
ZN: E-R-1206-33k-5%
47 | 2, Stk 129910 | Widerstand 1206 10k 5% | R15, R16
ZN: E-R-1206-10k-5%
48 | 2, Stk 129913 | Widerstand 1206 11k5 5% | R17, R18
ZN: E-R-1206-11k5-5%
49 | 2, Stk 129915 | Widerstand 1206 12k 5% | R53, R54
ZN: E-R-1206-12k-5%
50 | 2, Stk 129929 | Widerstand 1206 220k 5% | R23, R24
ZN: E-R-1206-220k-5%
51 | 6, Stk 129943 | Widerstand 1206 3k3 5% | R25, R26, R39, R40, R59, R60
ZN: E-R-1206-3k3-5%
53 | 2, Stk 129934 | Widerstand 1206 270R 5% | R27, R28
ZN: E-R-1206-270R-5%
54 | 6, Stk 129946 | Widerstand 1206 470R 5% | R29, R30, R33 - R36
ZN: E-R-1206-470R-5%
56 | 2, Stk 129947 | Widerstand 1206 47k 5% | R31, R32
ZN: E-R-1206-47k-5%
65 | 4, Stk 129833 | Hochlastwiderstand axial | R47 - R50
0,27R 10% 5W
ZN: E-R-208-8-0R27 | Bauform 208-8 (25,0x6,4x6,4mm)
66 | 4, Stk 129931 | Widerstand 1206 22k 5% | R51, R52, R57, R58
ZN: E-R-1206-22k-5%
68 | 2, Stk 129925 | Widerstand 1206 1k5 5% | R55, R56
ZN: E-R-1206-1k5-5%
69 | 2, Stk 129956 | Widerstand 1206 68k 5% | R61, R62
ZN: E-R-1206-68k-5%

===================================================================================================
(C) MIMOT Mikro Montage Technik GmbH, Im Entenbad 13 , 79541 Lörrach-Hauingen | ar | >###<
