marka87/GRAF_MNP/Elektronik/Controller/Outputs/[GRAF-MNP_1.0]/SCH/[GRAF-MNP_1.0] SCH.PDF

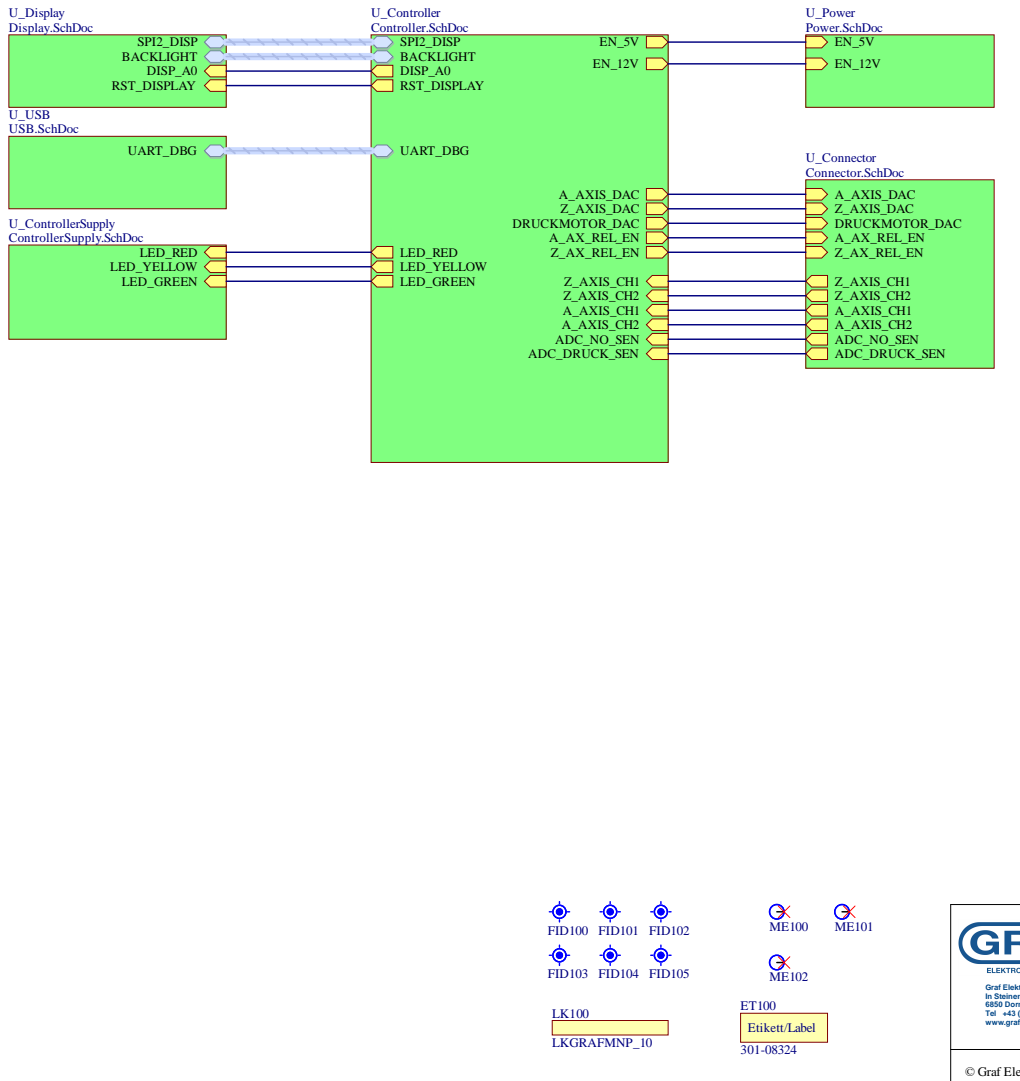
[picture p67: page 1]

File:
I:\lehrling_ausbildung\Projektpraktikum\GRAF_MNP\Elektronik\Controller\Top.SchDoc

The reproduction, distribution and utilization of this document as well as the communication of its contentsto
others without express authorization is prohibited. Offenders will be held liable for the payment of damages.
All rights reserved in the event of the grant of a patent, utility model or design.

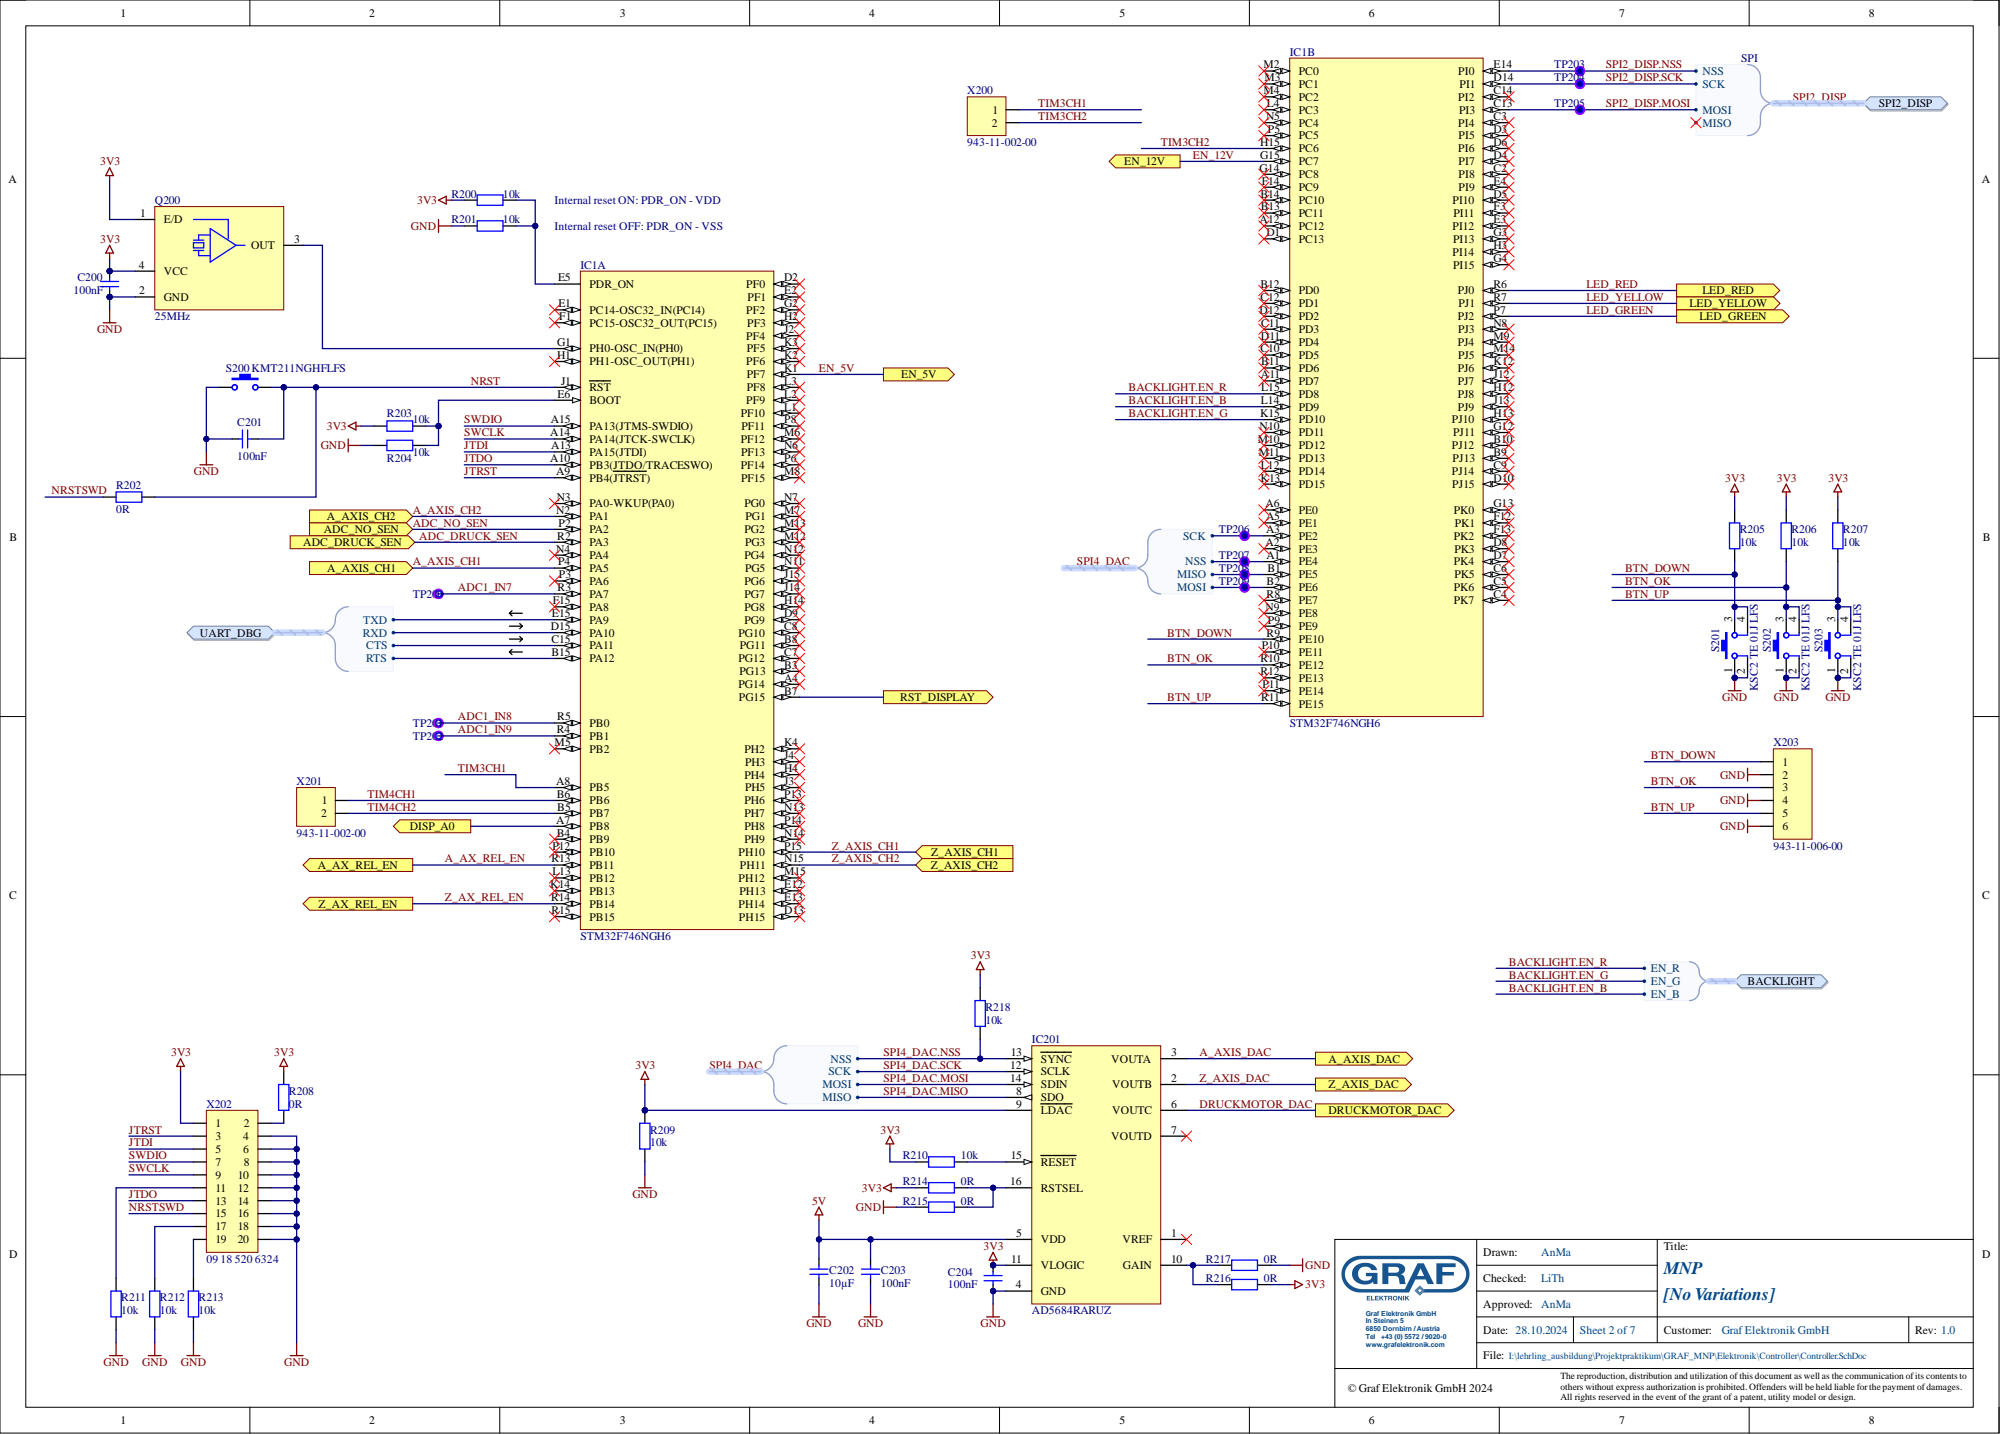
[picture p68: page 2]

Internal reset ON: PDR_ON - VDD

Internal reset OFF: PDR_ON - VSS

BOOT E6

SWDIO | PA13(JTMS-SWDIO) A15

RSTSEL 16

I:\lehrling_ausbildung\Projektpraktikum\GRAF_MNP\Elektronik\Controller\Controller.SchDoc

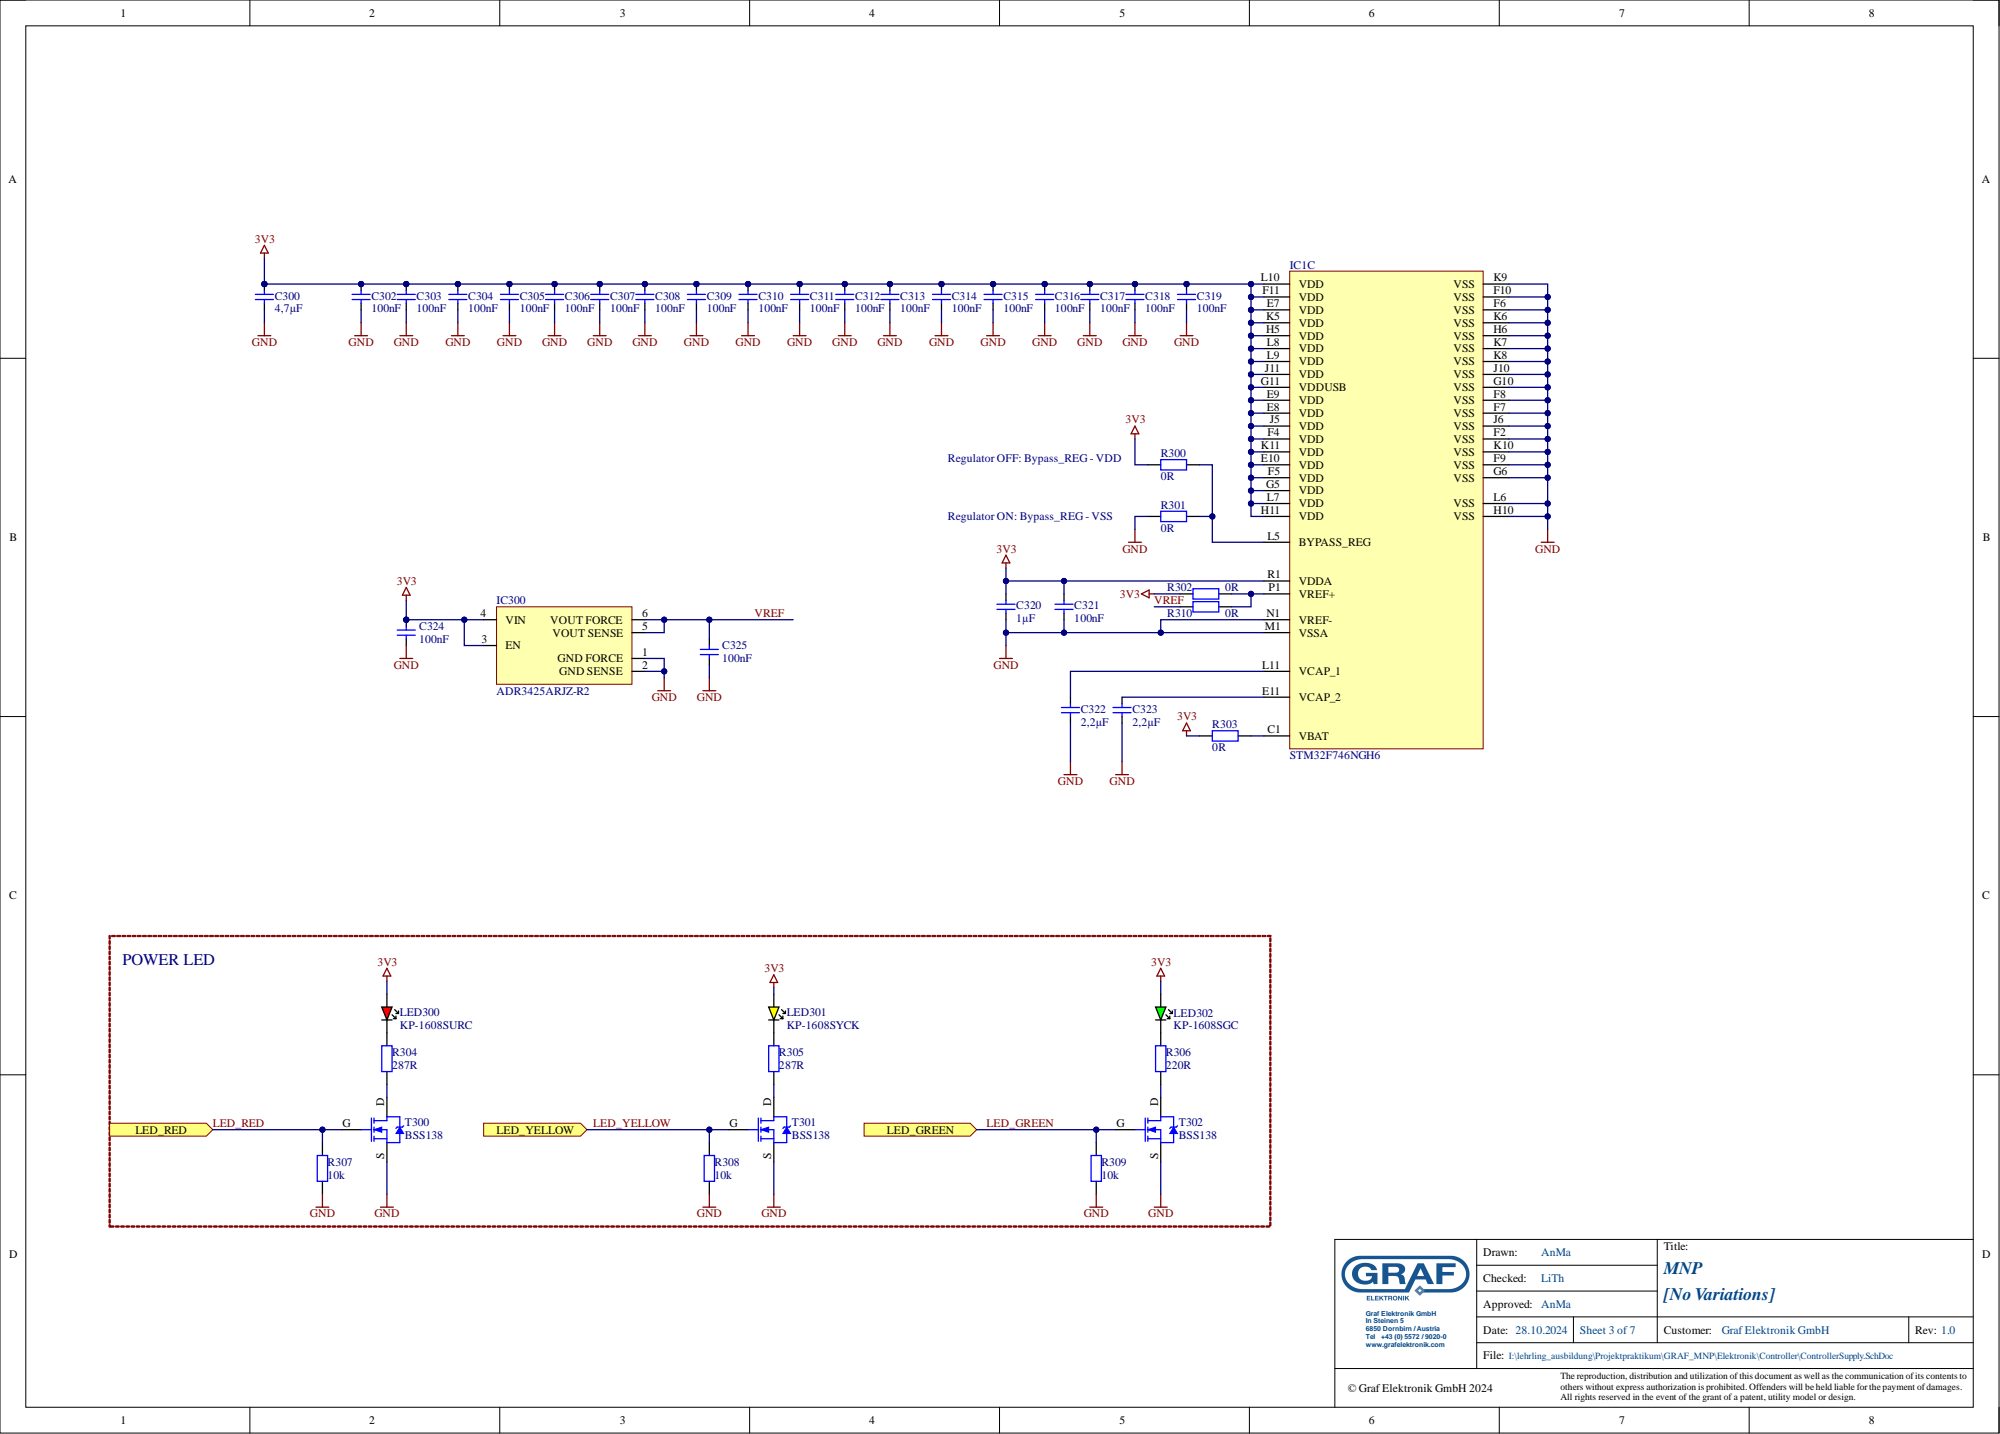
[picture p69: page 3]

I:\lehrling_ausbildung\Projektpraktikum\GRAF_MNP\Elektronik\Controller\ControllerSupply.SchDoc

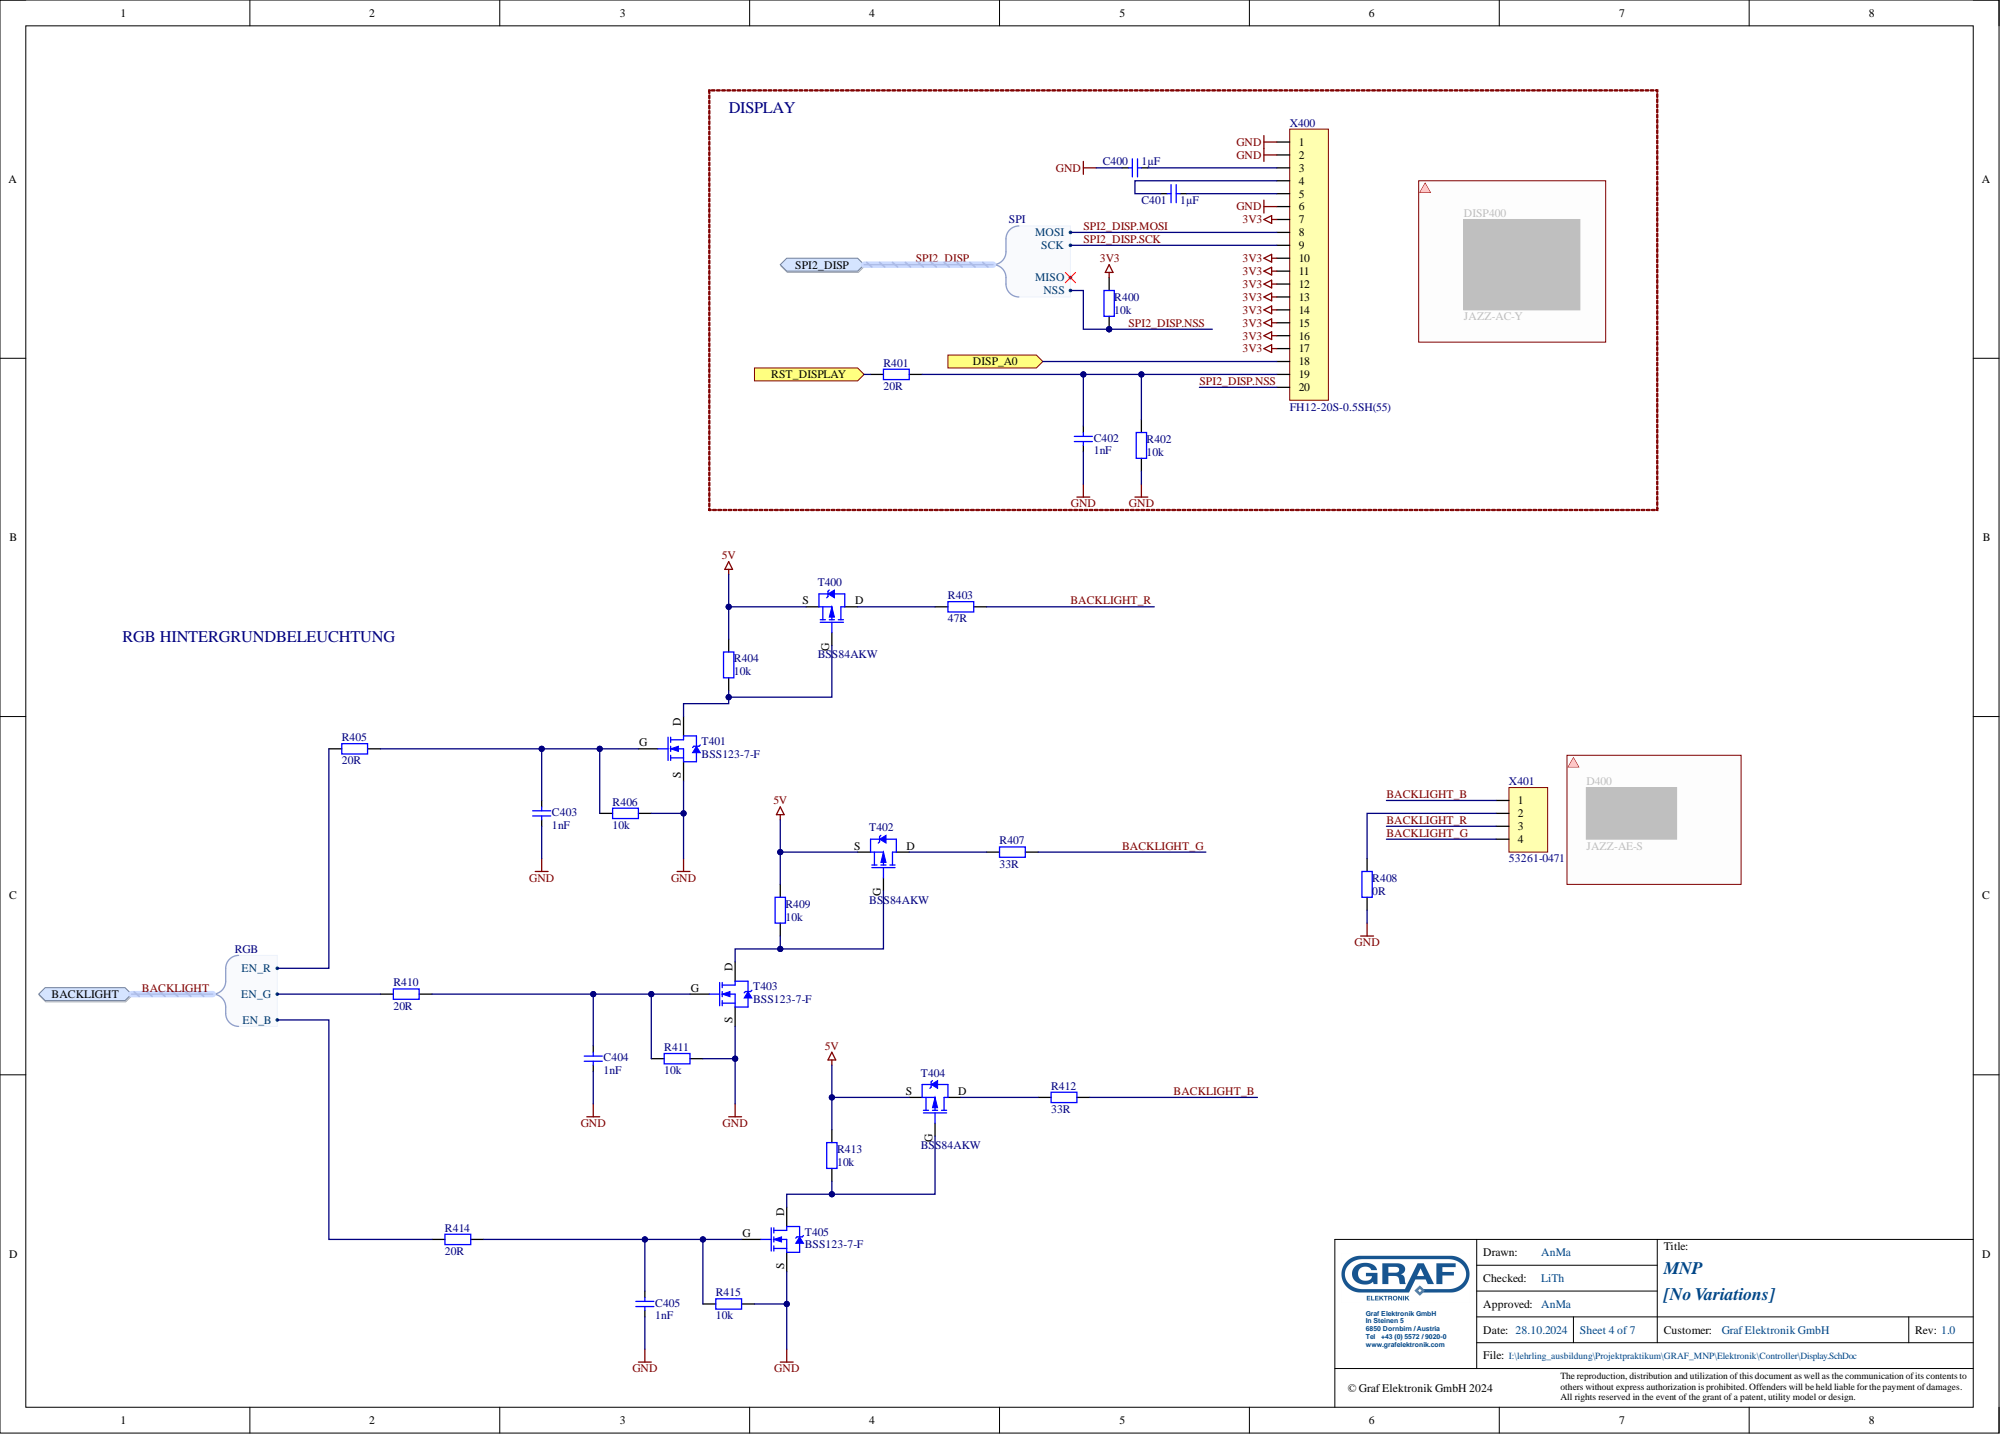
[picture p70: page 4]

BACKLIGHT_R BACKLIGHT_G

I:\lehrling_ausbildung\Projektpraktikum\GRAF_MNP\Elektronik\Controller\Display.SchDoc

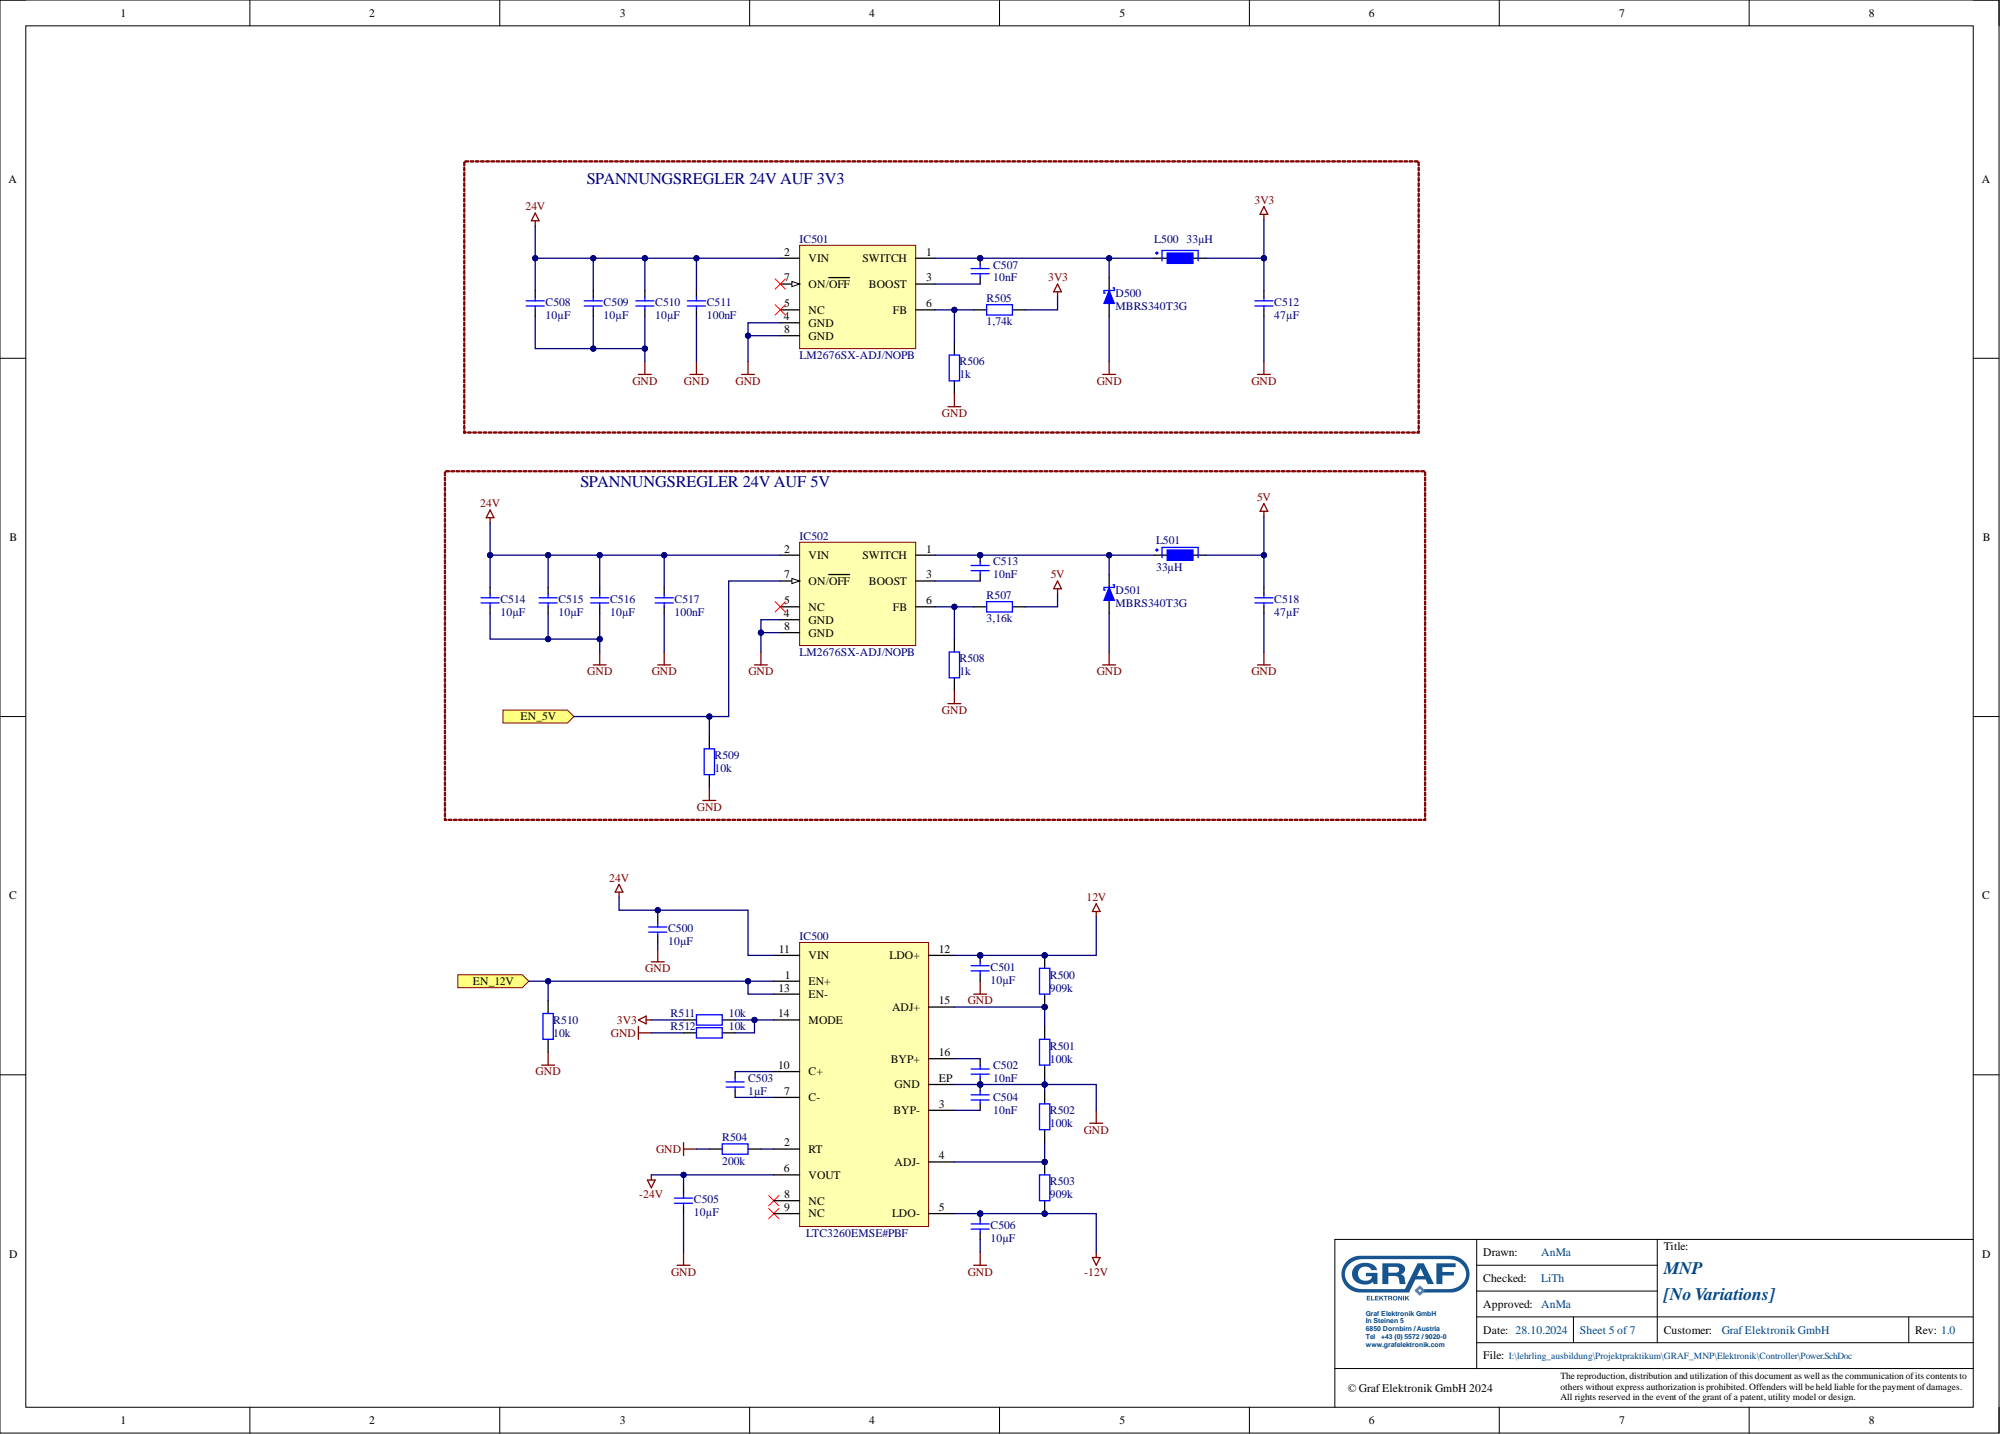
[picture p71: page 5]

I:\lehrling_ausbildung\Projektpraktikum\GRAF_MNP\Elektronik\Controller\Power.SchDoc

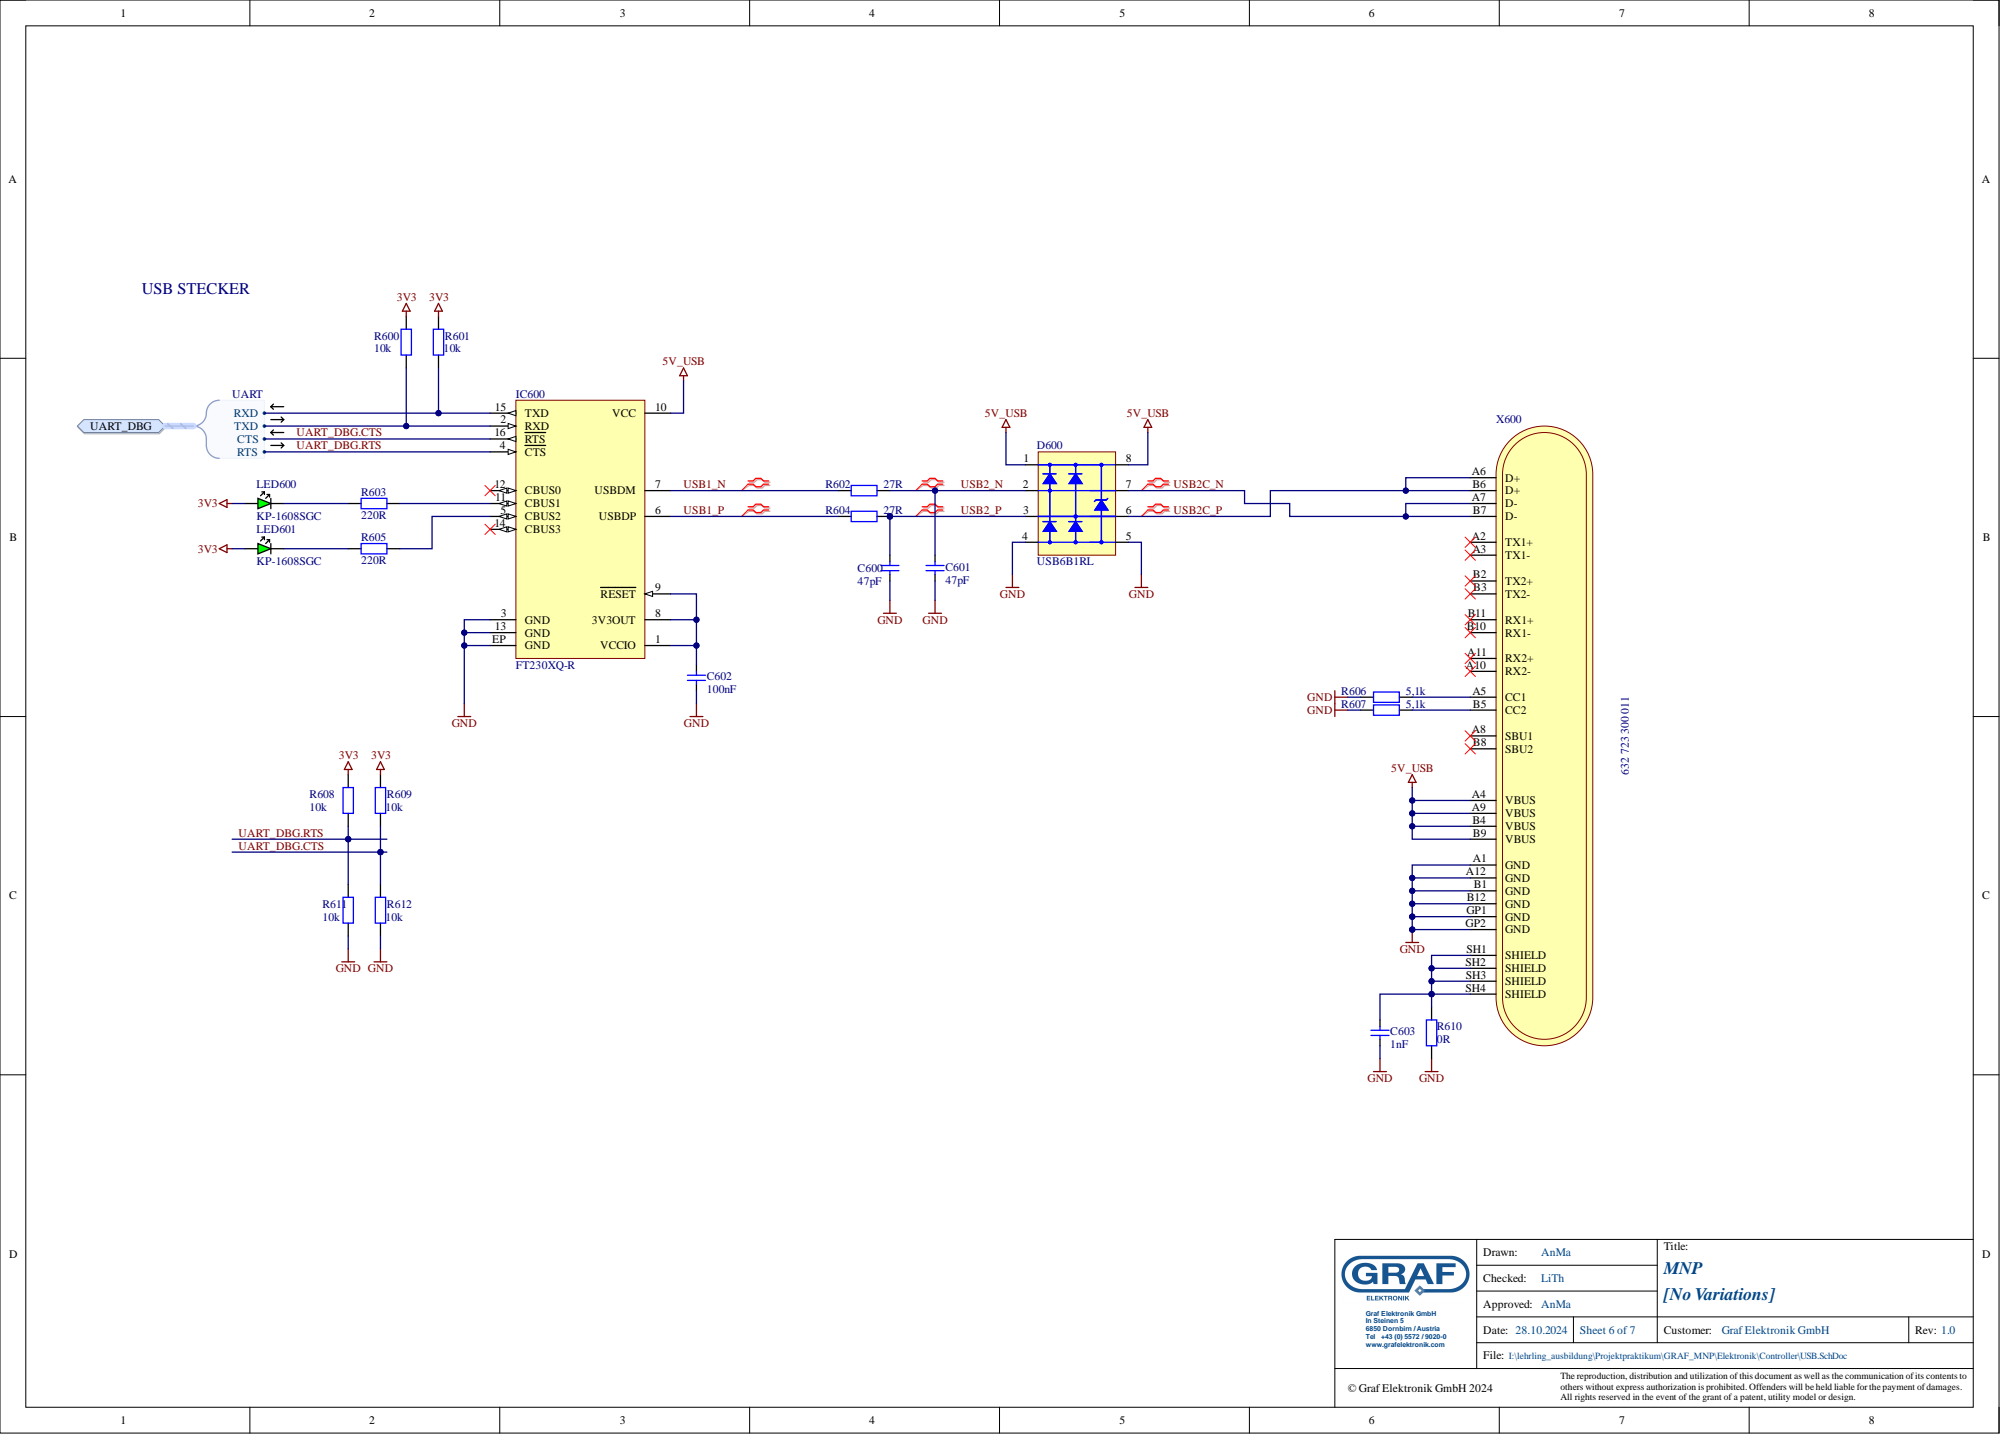
[picture p72: page 6]

CBUS1 11 | USB2_P 3 | 6
CBUS2 5

I:\lehrling_ausbildung\Projektpraktikum\GRAF_MNP\Elektronik\Controller\USB.SchDoc

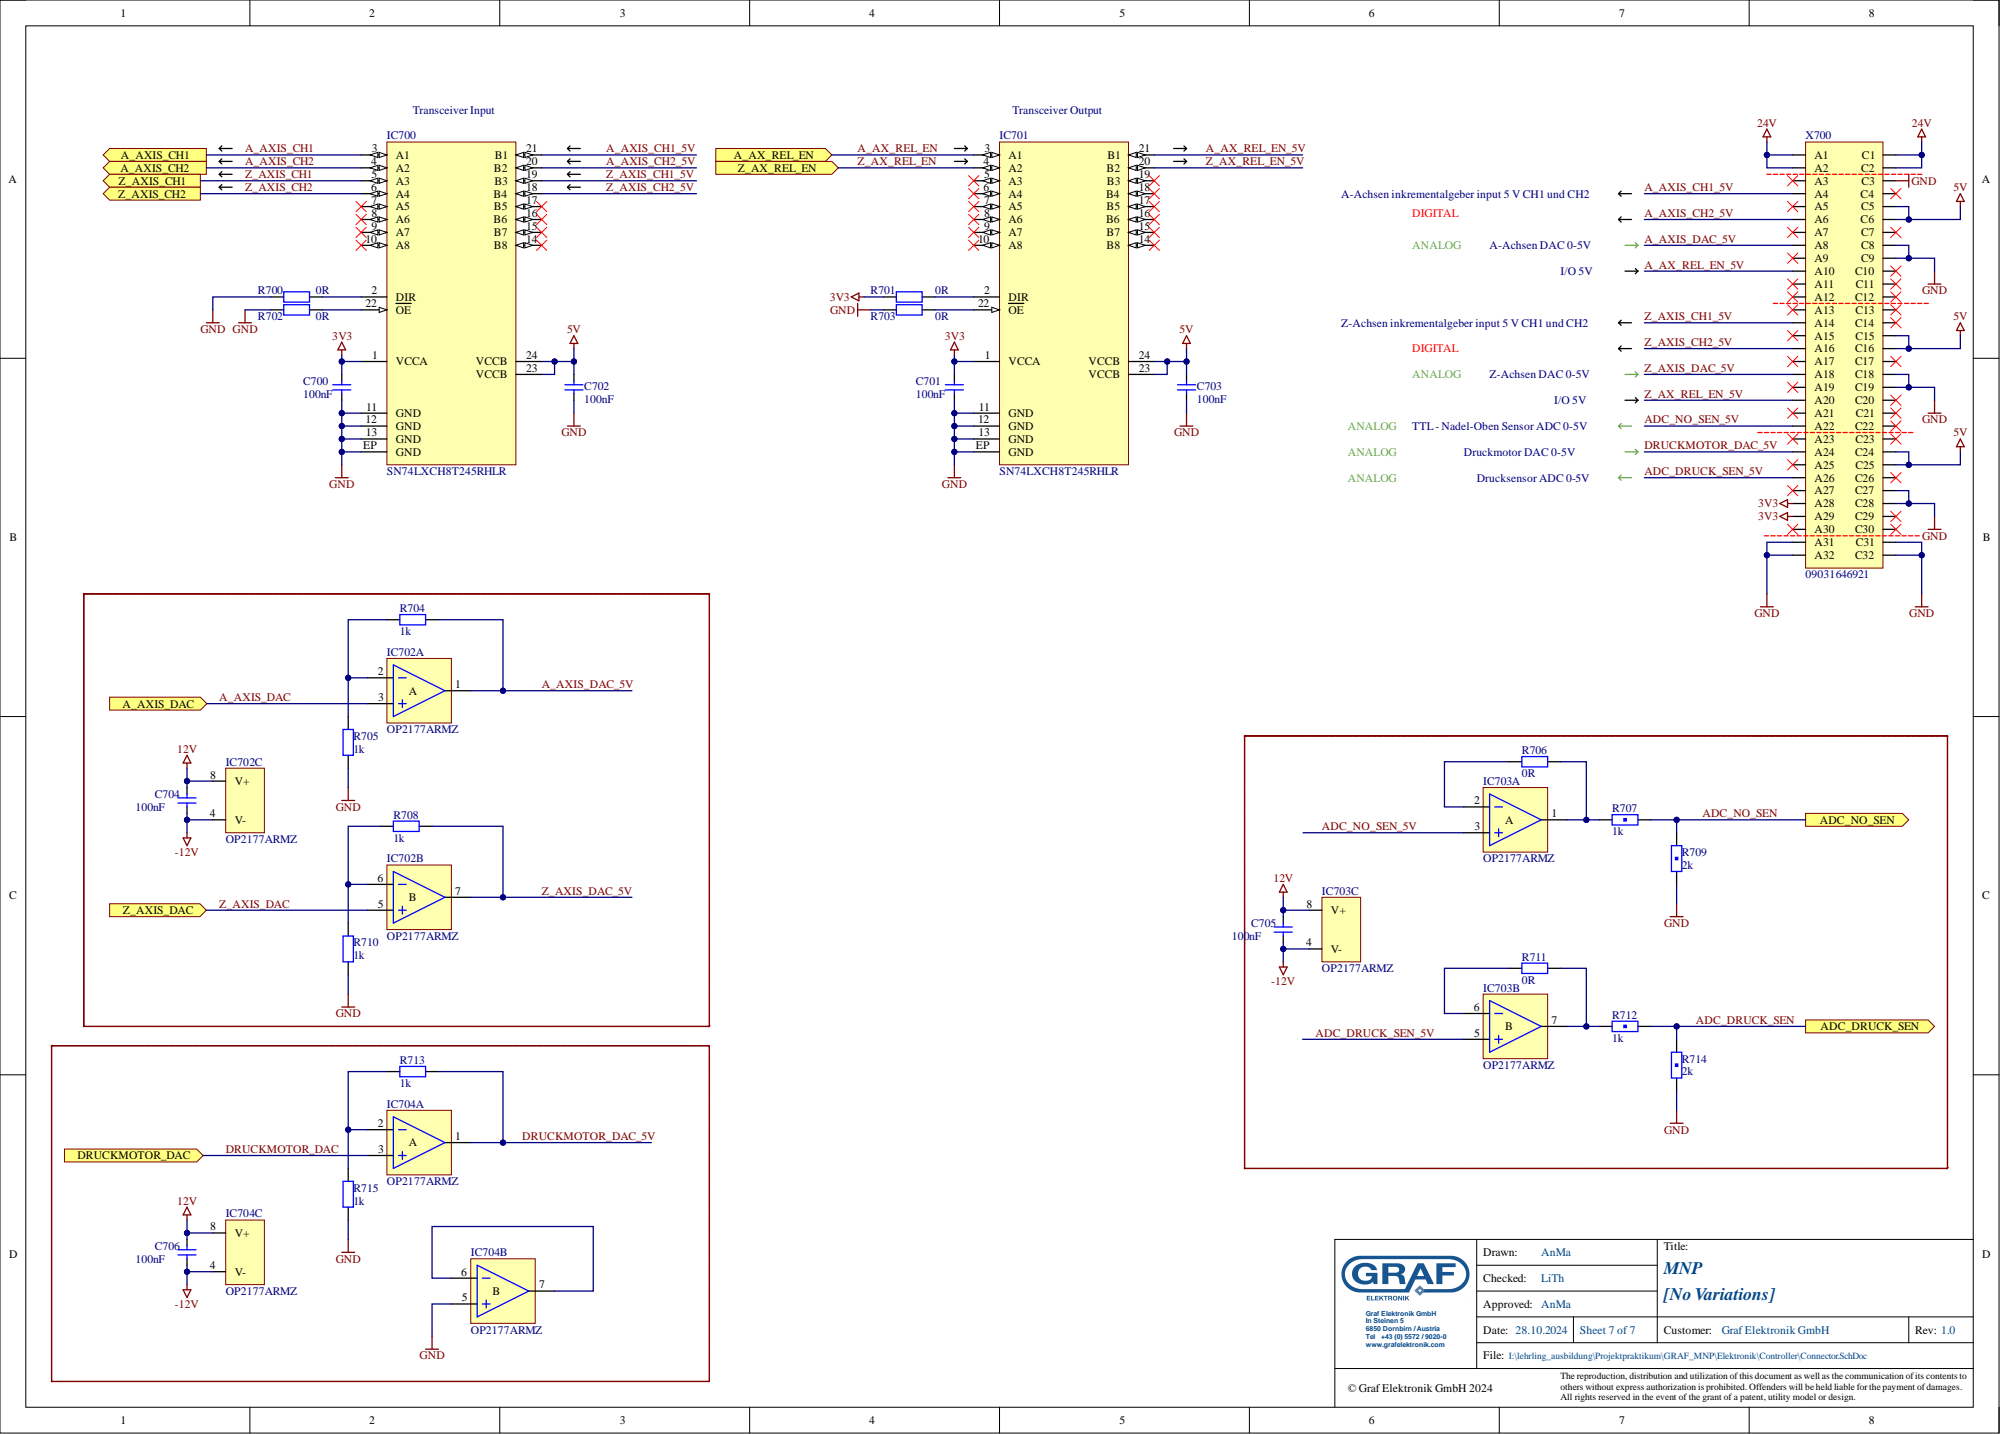
[picture p73: page 7]

A-Achsen inkrementalgeber input 5 V CH1 und CH2

Z-Achsen inkrementalgeber input 5 V CH1 und CH2

TTL- Nadel-Oben Sensor ADC 0-5V

I:\lehrling_ausbildung\Projektpraktikum\GRAF_MNP\Elektronik\Controller\Connector.SchDoc
