marka87/GRAF_MNP/Elektronik/Powersupply/Outputs/[GRAF-MNP Powersupply_1.0]/SCH/[GRAF-MNP Powersupply_1.0] SCH.PDF

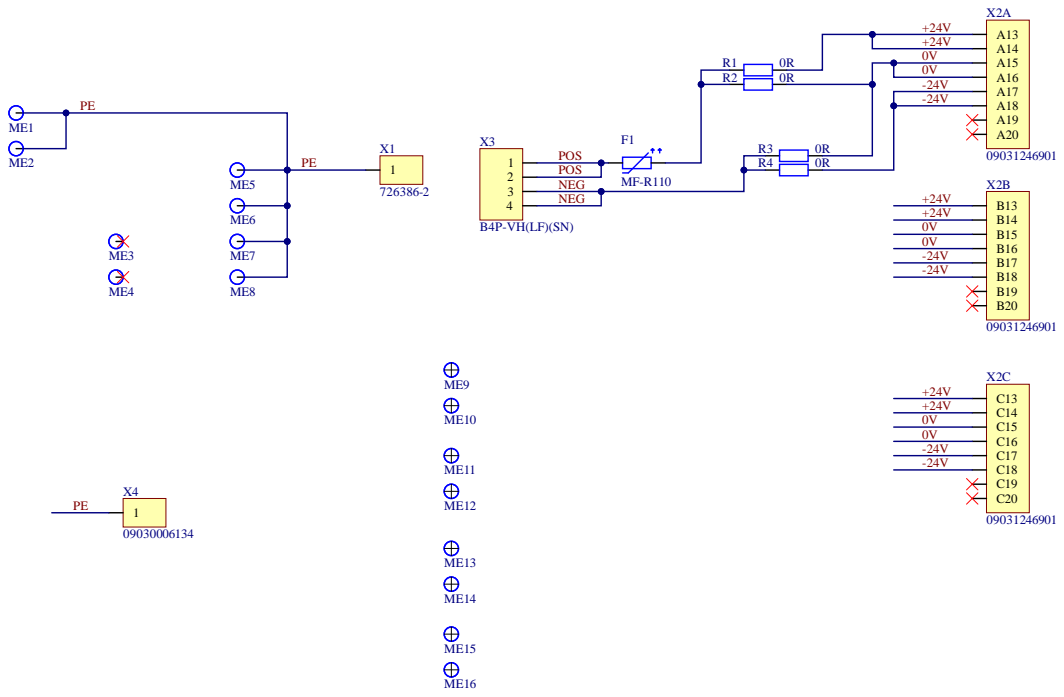
[picture p74: page 1]

event of the gr

and utiliz
ation is prohibited. Offende

ation of this document

s well
s will be held liable

communic
for the payment of damage
sign.

a patent, utility model or de
