marka87/GRAF_MNP/Elektronik/Controller/Simulation/OutputAmplifier.asc

R1: res; 1k
R2: res; 1k
U1: OP2177
V1: voltage; 12V
V2: voltage; -12V
V3: voltage; SINE(1.25 1.25 1k 0 0 0 10)
Named nets: 12V, -12V, IN, OUT, 0
.tran 0 0.01 0
