marka87/GRAF_MNP/(list of files, drawings)

Other design files:
Elektronik/Controller/Connector.SchDoc
Elektronik/Controller/Controller.SchDoc
Elektronik/Controller/ControllerSupply.SchDoc
Elektronik/Controller/Display.SchDoc
Elektronik/Controller/GRAF_MNP.PcbDoc
Elektronik/Controller/GRAF_MNP.PrjPcb
Elektronik/Controller/Power.SchDoc
Elektronik/Controller/Top.SchDoc
Elektronik/Controller/USB.SchDoc
Elektronik/GRAF_MNP/GRAF_MNP.PrjPcb
Elektronik/Powersupply/Powersupply.PcbDoc
Elektronik/Powersupply/Powersupply.PrjPcb
Elektronik/Powersupply/Powersupply.SchDoc
Elektronik/Stecker_Pin/Stecker_Pin.SchDoc
