marka87/GRAF_MNP/Software/GRAF_MNPA/Core/Src/main.c

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
/* Includes ------------------------------------------------------------------*/
#include "main.h"

/* USER CODE BEGIN Includes */
#include <stdio.h>
#include <string.h>
#include <math.h>
#include <stdbool.h>
#include <stdlib.h>
#include "display.h"
#include "AD5684RARUZ.h"
#include "ADC_read.h"
#include "encoder.h"
#include "Reference_Run.h"
#include "PID_Control.h"
#include "Z_PID_Control.h"
#include "handle_button.h"
#include "d_mot_control.h"
#include "data_buffer.h"
#include "test_run.h"

/* USER CODE END Includes */

/* USER CODE BEGIN PD */
#define a_mot 0x01		//Address for DAC-A...
#define z_mot 0x02		//DAC-B...
#define d_mot 0x04		//DAC-C.
#define TARGET_VOLTAGE_NEUTRAL 2.5f
#define MAX_DATA_POINTS 1000  // Maximale Anzahl an Datenpunkten

/* USER CODE END PD */

ADC_HandleTypeDef hadc1;

SPI_HandleTypeDef hspi2;
SPI_HandleTypeDef hspi4;

TIM_HandleTypeDef htim2;
TIM_HandleTypeDef htim5;

UART_HandleTypeDef huart1;

/* USER CODE BEGIN PV */
ad5684_dac_t dac;

typedef enum {
	IDLE_START, EXEC_REFERENCE_RUN, TEST_START, TEST_RUN, STOP, COMPLETED, FEHLER
} run_state_t;

run_state_t current_state = IDLE_START;

extern uint32_t A_Axis_TargetPosition;
extern uint32_t Z_Axis_TargetPosition;
extern int32_t a_encoder_start;
extern int32_t a_encoder_end;
extern int32_t z_encoder_start;
extern int32_t z_encoder_end;
extern int32_t z_ax_no_pos;
extern char display_buffer[DISPLAY_MAX_LINES][30];
extern float voltage;
/* UART Callback */
static char error_message[64];
static volatile uint8_t UART1_rxBuffer[1] = { 0 };

/* Ring buffer for UART commands — filled by ISR, drained in main loop */
#define UART_CMD_BUF_SIZE 32
static volatile uint8_t uart_cmd_buf[UART_CMD_BUF_SIZE];
static volatile uint8_t uart_cmd_head = 0;
static volatile uint8_t uart_cmd_tail = 0;
static bool tick_100ms_testrun_elapsed = false;
static uint32_t z_target_requested = 0;

uint32_t next_100ms_tick = 0;
uint32_t next_10ms_tick = 0;
uint32_t next_1ms_tick = 0;
uint32_t next_uart_status_tick = 0;

volatile bool ds_was_activated = false;
bool z_axis_success = false;
bool a_axis_success = false;
static bool completed_stats_sent = false;
static bool test_summary_sent = false;
/* USER CODE END PV */

void SystemClock_Config(void);
static void MPU_Config(void);
static void MX_GPIO_Init(void);
static void MX_TIM2_Init(void);
static void MX_SPI2_Init(void);
static void MX_TIM5_Init(void);
static void MX_USART1_UART_Init(void);
static void MX_SPI4_Init(void);
static void MX_ADC1_Init(void);
/* USER CODE BEGIN PFP */
void update_display(void);
void Process_UART_Command(const char *command);
void red_light(void);
void green_light(void);
void yellow_light(void);
void white_light(void);
/* USER CODE END PFP */

/* USER CODE BEGIN 0 */
display_info_t display1 = {								//The Display init
		.spi_handle = &hspi2, .lcd_width = 128, .lcd_height = 64,
				.lcd_ram_pages = 8 };

static const char* get_state_name(void) {
	switch (current_state) {
		case IDLE_START:         return "IDLE_START";
		case EXEC_REFERENCE_RUN: return "EXEC_REFERENCE_RUN";
		case TEST_START:         return "TEST_START";
		case TEST_RUN:           return "TEST_RUN";
		case STOP:               return "STOP";
		case COMPLETED:          return "COMPLETED";
		case FEHLER:             return "FEHLER";
		default:                 return "UNKNOWN";
	}
}

static void uart_send_status(void) {
	char buf[32];
	snprintf(buf, sizeof(buf), "_STATUS_%s\r\n", get_state_name());
	HAL_UART_Transmit(&huart1, (const uint8_t*) buf, (uint16_t) strlen(buf), 100);
}

void uart_send_text(const char *text, uint32_t timeout) {
	HAL_UART_Transmit(&huart1, (const uint8_t*) text, (uint16_t) strlen(text),
			timeout);
}

void Z_Target_SetRequested(uint32_t target) {
	z_target_requested = target;
	Z_Axis_TargetPosition = target;
}

void Z_Target_SetRequestedDirect(uint32_t target) {
	z_target_requested = target;
	Z_Axis_TargetPosition = target;
}

uint32_t Z_Target_GetRequested(void) {
	return z_target_requested;
}

static uint32_t clamp_nonnegative_position(int32_t position) {
	return (position < 0) ? 0u : (uint32_t)position;
}

static bool parse_positive_decimal(const char *s, float *out) {
	if (s == NULL || out == NULL) {
		return false;
	}

	while (*s == ' ' || *s == '\t' || *s == '\r' || *s == '\n') {
		++s;
	}
	if (*s == '\0') {
		return false;
	}
	if (*s == '+') {
		++s;
	}
	if (*s == '-') {
		return false;
	}

	const char *end = s + strlen(s);
	while (end > s && (end[-1] == ' ' || end[-1] == '\t' || end[-1] == '\r' || end[-1] == '\n')) {
		--end;
	}

	uint32_t int_part = 0;
	uint32_t frac_part = 0;
	uint32_t frac_div = 1;
	bool seen_digit = false;
	bool seen_dot = false;
	for (const char *p = s; p < end; ++p) {
		char c = *p;
		if (c >= '0' && c <= '9') {
			seen_digit = true;
			if (!seen_dot) {
				int_part = (int_part * 10u) + (uint32_t) (c - '0');
			} else if (frac_div < 1000000000u) {
				frac_part = (frac_part * 10u) + (uint32_t) (c - '0');
				frac_div *= 10u;
			}
		} else if (c == '.' && !seen_dot) {
			seen_dot = true;
		} else {
			return false;
		}
	}
	if (!seen_digit) {
		return false;
	}
	*out = (float) int_part + ((float) frac_part / (float) frac_div);
	return *out > 0.0f;
}

static bool parse_pid_triplet(const char *payload, float *kp, float *ki, float *kd) {
	if (payload == NULL || kp == NULL || ki == NULL || kd == NULL) {
		return false;
	}
	const char *c1 = strchr(payload, ',');
	if (c1 == NULL) {
		return false;
	}
	const char *c2 = strchr(c1 + 1, ',');
	if (c2 == NULL) {
		return false;
	}
	if (strchr(c2 + 1, ',') != NULL) {
		return false;
	}
	char p1[24] = { 0 };
	char p2[24] = { 0 };
	char p3[24] = { 0 };
	size_t l1 = (size_t) (c1 - payload);
	size_t l2 = (size_t) (c2 - (c1 + 1));
	size_t l3 = strlen(c2 + 1);
	if (l1 == 0 || l2 == 0 || l3 == 0 || l1 >= sizeof(p1) || l2 >= sizeof(p2)
			|| l3 >= sizeof(p3)) {
		return false;
	}
	memcpy(p1, payload, l1);
	memcpy(p2, c1 + 1, l2);
	memcpy(p3, c2 + 1, l3);
	if (!parse_positive_decimal(p1, kp)) {
		return false;
	}
	if (!parse_positive_decimal(p2, ki)) {
		return false;
	}
	if (!parse_positive_decimal(p3, kd)) {
		return false;
	}
	return true;
}

/* Update Display */
/* Update Display (Minimal & Ruckfrei - waehrend TEST_RUN komplett deaktiviert) */
void update_display() {
	if (current_state == TEST_RUN) {
		return;
	}

	int32_t z_axis_position = Encoder_GetPosition_Z_AXIS();

	const char *st_name = "BEREIT";
	if (current_state == IDLE_START) st_name = "BITTE REFERENZIEREN";
	else if (current_state == EXEC_REFERENCE_RUN) st_name = "REFERENZIERE...";
	else if (current_state == TEST_START) st_name = "BEREIT (START-POS)";
	else if (current_state == STOP) st_name = "NOT-HALT / STOP";
	else if (current_state == FEHLER) st_name = "FEHLER!";
	else if (current_state == COMPLETED) st_name = "TEST BEENDET";

	snprintf(display_buffer[0], sizeof(display_buffer[0]), "   GRAF MNP TEST");
	snprintf(display_buffer[2], sizeof(display_buffer[2]), "Status: %-15s", st_name);
	snprintf(display_buffer[4], sizeof(display_buffer[4]), "Z-Ist:  %ld", (long)z_axis_position);
	if (current_state == FEHLER && error_message[0] != '\0') {
		snprintf(display_buffer[5], sizeof(display_buffer[5]), "%.21s", error_message);
	} else {
		display_buffer[5][0] = '\0';
	}
	snprintf(display_buffer[7], sizeof(display_buffer[7]), "  REF     HOME   RESET");

	display_jazz_write_string_5x7(&display1, 0, display_buffer[0]);
	display_jazz_write_string_5x7(&display1, 2, display_buffer[2]);
	display_jazz_write_string_5x7(&display1, 4, display_buffer[4]);
	if (display_buffer[5][0] != '\0') {
		display_jazz_write_string_5x7(&display1, 5, display_buffer[5]);
	}
	display_jazz_write_string_5x7(&display1, 7, display_buffer[7]);

	/* Live-Telemetrie fuer Windows GUI (wird waehrend TEST_RUN ohnehin oben uebersprungen) */
	GPIO_PinState no_sen_state = HAL_GPIO_ReadPin(NO_SEN_GPIO_Port, NO_SEN_Pin);
	int32_t a_axis_position = Encoder_GetPosition_A_AXIS();
	float z_dac_voltage = voltage;
	uint16_t raw_value = ADC_Drucksensor(&hadc1);
	float sensorVoltage = (float)raw_value * (5.0f / 4095.0f);

	char datablock[96];
	snprintf(datablock, sizeof(datablock), "%d;%.3f;%ld;%ld;%ld;%.3f\r\n",
			(int)no_sen_state, sensorVoltage, (long)a_axis_position,
			(long)z_axis_position, (long)Z_Axis_TargetPosition, z_dac_voltage);
	uart_send_text(datablock, 50);
}

void HAL_UART_RxCpltCallback(UART_HandleTypeDef *huart) {
	if (huart == &huart1) {
		/* Store received byte in ring buffer — never call blocking code from ISR */
		uint8_t next = (uart_cmd_head + 1) % UART_CMD_BUF_SIZE;
		if (next != uart_cmd_tail) { // drop silently if buffer is full
			uart_cmd_buf[uart_cmd_head] = UART1_rxBuffer[0];
			uart_cmd_head = next;
		}
		HAL_UART_Receive_IT(&huart1, (uint8_t*) UART1_rxBuffer, 1);
	}
}

void HAL_UART_ErrorCallback(UART_HandleTypeDef *huart) {
	if (huart == &huart1) {
		__HAL_UART_CLEAR_OREFLAG(huart);
		__HAL_UART_CLEAR_NEFLAG(huart);
		__HAL_UART_CLEAR_FEFLAG(huart);
		__HAL_UART_CLEAR_PEFLAG(huart);
		HAL_UART_Receive_IT(&huart1, (uint8_t*) UART1_rxBuffer, 1);
	}
}

// UART-Verarbeitung
void Process_UART_Command(const char *command) {
	int32_t raw_min = (z_encoder_start < z_encoder_end) ? z_encoder_start : z_encoder_end;
	int32_t raw_max = (z_encoder_start > z_encoder_end) ? z_encoder_start : z_encoder_end;
	if (raw_min < 0) raw_min = 0;

	/* Dynamische Sicherheits-Grenzwerte fuer den Bediener:
	 * Unteres Limit: gemessener harter Anschlag + 50
	 * Oberes Limit:  gemessener harter Anschlag - 150 */
	uint32_t lower_limit = (uint32_t)raw_min + 50u;
	uint32_t upper_limit = (raw_max > 150) ? (uint32_t)(raw_max - 150) : (uint32_t)raw_max;
	if (upper_limit < lower_limit) upper_limit = lower_limit + 100u;

	char response[256] = { 0 }; 				// Rückmeldungspuffer
	uint32_t step_size = 100;

	if (command[0] == '+' || command[0] == '-') {
		if (command[1] != '\0') {
			unsigned long parsed_step = 0;
			if (sscanf(command + 1, "%lu", &parsed_step) != 1 || parsed_step == 0) {
				snprintf(response, sizeof(response), "Ungueltig: +<zahl> oder -<zahl>\r\n");
				uart_send_status();
				uart_send_text(response, 50);
				return;
			}
			step_size = (uint32_t) parsed_step;
		}
	}

	if (command[0] == '+') { // Zielposition erhöhen
		if (current_state != TEST_START) {
			snprintf(response, sizeof(response), "Ignoriert: kein TEST_START\r\n");
		} else {
			uint32_t req = Z_Target_GetRequested();
			uint32_t next = req;
			if (req + step_size <= upper_limit) {
				next = req + step_size;
				snprintf(response, sizeof(response), "Erhöht: Ziel = %lu\r\n", next);
			} else {
				next = upper_limit;
				snprintf(response, sizeof(response), "Limit: Ziel = %lu\r\n", next);
			}
			Z_Target_SetRequested(next);
		}

	} else if (command[0] == '-') { // Zielposition verringern
		if (current_state != TEST_START) {
			snprintf(response, sizeof(response), "Ignoriert: kein TEST_START\r\n");
		} else {
			uint32_t req = Z_Target_GetRequested();
			uint32_t next = req;
			if (req >= step_size + lower_limit) {
				next = req - step_size;
				snprintf(response, sizeof(response), "Verringert: Ziel = %lu\r\n", next);
			} else {
				next = lower_limit;
				snprintf(response, sizeof(response), "Limit: Ziel = %lu\r\n", next);
			}
			Z_Target_SetRequested(next);
		}

	} else if (strcmp(command, "r") == 0) { // Relais an/aus
		snprintf(response, sizeof(response), "System reset initiated.\r\n");
		NVIC_SystemReset();
	} else if (strcmp(command, "s") == 0) { // Referenzlauf starten
		Z_PID_Reset();
		Z_PID_SetSchedulerEnabled(true);
		current_state = EXEC_REFERENCE_RUN;
		snprintf(response, sizeof(response), "Referenzlauf gestartet.\r\n");
	} else if (strcmp(command, "e") == 0) { // Test / Manuell starten
		HAL_GPIO_WritePin(GPIOB, Z_AX_REL_EN_Pin, GPIO_PIN_SET);
		HAL_GPIO_WritePin(GPIOB, A_AX_REL_EN_Pin, GPIO_PIN_SET);
		Z_PID_Reset();
		Z_PID_SetSchedulerEnabled(true);
		uint32_t home_pos = (z_ax_no_pos > 0) ? (z_ax_no_pos + 50) : clamp_nonnegative_position(Encoder_GetPosition_Z_AXIS());
		Z_Target_SetRequestedDirect(home_pos);
		current_state = TEST_START;
		snprintf(response, sizeof(response), "Test/Manuell gestartet.\r\n");
	} else if (strncmp(command, "TA=", 3) == 0 || strcmp(command, "TA") == 0) {
		int cycles = (command[2] == '=') ? atoi(command + 3) : 10;
		if (cycles <= 0) cycles = 1;
		if (cycles > 100000) cycles = 100000;
		Z_PID_SetSchedulerEnabled(false);
		TestRun_InitEx(TESTRUN_MODE_A_CLASSIC, (uint32_t)cycles);
		current_state = TEST_RUN;
		snprintf(response, sizeof(response), "TEST_A_START:%d Zyklen\r\n", cycles);
	} else if (strncmp(command, "TB=", 3) == 0 || strcmp(command, "TB") == 0) {
		int cycles = (command[2] == '=') ? atoi(command + 3) : 10;
		if (cycles <= 0) cycles = 1;
		if (cycles > 100000) cycles = 100000;
		Z_PID_SetSchedulerEnabled(false);
		TestRun_InitEx(TESTRUN_MODE_B_PROBE_SCATTER, (uint32_t)cycles);
		current_state = TEST_RUN;
		snprintf(response, sizeof(response), "TEST_B_START:%d Zyklen\r\n", cycles);
	} else if (strncmp(command, "CFG_TB:", 7) == 0) {
		const char *p = command + 7;
		char buf[48];
		strncpy(buf, p, sizeof(buf) - 1);
		buf[sizeof(buf) - 1] = '\0';
		char *semi = strchr(buf, ';');
		float dmot = 3.3f;
		unsigned long delta = 90;
		if (semi != NULL) {
			*semi = '\0';
			char *comma = strchr(buf, ',');
			if (comma) *comma = '.';
			parse_positive_decimal(buf, &dmot);
			delta = strtoul(semi + 1, NULL, 10);
		} else {
			char *comma = strchr(buf, ',');
			if (comma) *comma = '.';
			parse_positive_decimal(buf, &dmot);
		}
		if (dmot > 20.0f) dmot = dmot / 1000.0f; /* falls in mV übergeben */
		TestRun_SetDruckmotorVoltage(dmot);
		if (delta > 0) TestRun_SetTriggerDeltaMv((uint32_t)delta);
		snprintf(response, sizeof(response), "CFG_TB_OK:dmot=%.2f,delta=%lu\r\n", dmot, (unsigned long)TestRun_GetTriggerDeltaMv());
	} else if (strcmp(command, "CFG_TB?") == 0) {
		snprintf(response, sizeof(response), "CFG_TB:%.2f;%lu\r\n", TestRun_GetDruckmotorVoltage(), (unsigned long)TestRun_GetTriggerDeltaMv());
	} else if (command[0] == 'Z' && command[1] != '\0') { // Z-Achse Zielposition direkt setzen (z.B. "Z1500")
		if (current_state != TEST_START) {
			snprintf(response, sizeof(response), "Ignoriert: kein TEST_START\r\n");
		} else {
			uint32_t val = 0;
			if (sscanf(command + 1, "%lu", &val) == 1) {
				if (val >= lower_limit && val <= upper_limit) {
					Z_Target_SetRequested(val);
					snprintf(response, sizeof(response), "Z-Pos: %lu\r\n", val);
				} else {
					snprintf(response, sizeof(response), "Limit! %lu [%lu-%lu]\r\n", val, lower_limit, upper_limit);
				}
			} else {
				snprintf(response, sizeof(response), "Ungueltig: Z<zahl>\r\n");
			}
		}
	} else if (strcmp(command, "PP?") == 0) {
		float kp = 0.0f, ki = 0.0f, kd = 0.0f;
		Z_PID_GetPositionParameters(&kp, &ki, &kd);
		snprintf(response, sizeof(response), "PIDZP:%.7f;%.9f;%.7f\r\n", kp, ki, kd);
	} else if (strcmp(command, "PV?") == 0) {
		float kp = 0.0f, ki = 0.0f, kd = 0.0f;
		Z_PID_GetVelocityParameters(&kp, &ki, &kd);
		snprintf(response, sizeof(response), "PIDZV:%.7f;%.9f;%.7f\r\n", kp, ki, kd);
	} else if (strcmp(command, "L?") == 0) {
		snprintf(response, sizeof(response), "ZLIM:%lu;%lu\r\n", lower_limit, upper_limit);
	} else if (strcmp(command, "V?") == 0) {
		snprintf(response, sizeof(response), "ZV:%u\r\n", Z_PID_GetSpeedLevel());
	} else if (strcmp(command, "SNO?") == 0) {
		snprintf(response, sizeof(response), "SNO:%ld\r\n", (long)z_ax_no_pos);
	} else if (command[0] == 'P' && command[1] == 'P' && command[2] == '=') {
		float kp = 0.0f, ki = 0.0f, kd = 0.0f;
		if (parse_pid_triplet(command + 3, &kp, &ki, &kd)) {
			Z_PID_SetPositionParameters(kp, ki, kd);
			snprintf(response, sizeof(response), "PIDZP_SET:%.7f;%.9f;%.7f\r\n", kp, ki, kd);
		} else {
			snprintf(response, sizeof(response), "PIDZP_ERR:Format PP=kp,ki,kd\r\n");
		}
	} else if (command[0] == 'P' && command[1] == 'V' && command[2] == '=') {
		float kp = 0.0f, ki = 0.0f, kd = 0.0f;
		if (parse_pid_triplet(command + 3, &kp, &ki, &kd)) {
			Z_PID_SetVelocityParameters(kp, ki, kd);
			snprintf(response, sizeof(response), "PIDZV_SET:%.7f;%.9f;%.7f\r\n", kp, ki, kd);
		} else {
			snprintf(response, sizeof(response), "PIDZV_ERR:Format PV=kp,ki,kd\r\n");
		}
	} else if (command[0] == 'V' && command[1] == '=') {
		int level = atoi(command + 2);
		if (level >= 1 && level <= 16) {
			Z_PID_SetSpeedLevel((uint8_t)level);
			snprintf(response, sizeof(response), "ZV_SET:%u\r\n", (unsigned)level);
		} else {
			snprintf(response, sizeof(response), "ZV_ERR:Format V=1..16\r\n");
		}
	} else if (strcmp(command, "N") == 0) {
		Z_PID_EmergencyNeutral(&dac);
		Z_Target_SetRequestedDirect(clamp_nonnegative_position(Encoder_GetPosition_Z_AXIS()));
		snprintf(response, sizeof(response), "Z_NEUTRAL:2.5V\r\n");
	} else if (strcmp(command, "q") == 0) {
		Trace_Freeze();
		TestRun_RestoreSpeedLevel();
		uint32_t hold_pos = clamp_nonnegative_position(Encoder_GetPosition_Z_AXIS());
		Z_Target_SetRequestedDirect(hold_pos);
		current_state = TEST_START;
	} else if (strcmp(command, "DUMP_TRACE") == 0 || strcmp(command, "TRACE?") == 0) {
		if (current_state == TEST_RUN) {
			snprintf(response, sizeof(response), "TRACE_BUSY: Test laeuft noch!\r\n");
			uart_send_text(response, 50);
		} else {
			Trace_DumpUART();
		}
		return;
	} else if (strcmp(command, "CMD:TRACE_MODE:RING") == 0) {
		Trace_SetMode(TRACE_MODE_RING);
		snprintf(response, sizeof(response), "TRACE_MODE:RING (Pre-Trigger aktiv)\r\n");
	} else if (strcmp(command, "CMD:TRACE_MODE:START") == 0) {
		Trace_SetMode(TRACE_MODE_START);
		snprintf(response, sizeof(response), "TRACE_MODE:START (Linear ab Start)\r\n");
	} else if (strcmp(command, "CMD:TRACE_FREEZE") == 0) {
		Trace_Freeze();
		snprintf(response, sizeof(response), "TRACE_FREEZE:OK\r\n");
	}
	// Rückmeldung senden
	uart_send_status();
	uart_send_text(response, 50);
}
void red_light() {
	HAL_GPIO_WritePin(GPIOD, EN_G_Pin | EN_B_Pin, GPIO_PIN_RESET);
	HAL_GPIO_WritePin(GPIOD, EN_R_Pin, GPIO_PIN_SET);
	HAL_GPIO_TogglePin(GPIOJ, LED_RED_Pin);
}
void green_light() {
	HAL_GPIO_WritePin(GPIOD, EN_R_Pin | EN_B_Pin, GPIO_PIN_RESET);
	HAL_GPIO_WritePin(GPIOD, EN_G_Pin, GPIO_PIN_SET);
	HAL_GPIO_TogglePin(GPIOJ, LED_GREEN_Pin);

}
void yellow_light() {
	HAL_GPIO_WritePin(GPIOD, EN_R_Pin | EN_G_Pin, GPIO_PIN_SET);
	HAL_GPIO_WritePin(GPIOD, EN_B_Pin, GPIO_PIN_RESET);
	HAL_GPIO_TogglePin(GPIOJ, LED_YELLOW_Pin);

}
void white_light() {
	HAL_GPIO_WritePin(GPIOD, EN_R_Pin | EN_G_Pin | EN_B_Pin, GPIO_PIN_SET);
}


/* USER CODE END 0 */

/**
  * @brief  The application entry point.
  * @retval int
  */
int main(void)
{

  /* MPU Configuration--------------------------------------------------------*/
  MPU_Config();

  /* MCU Configuration--------------------------------------------------------*/

  /* Reset of all peripherals, Initializes the Flash interface and the Systick. */
  HAL_Init();

  /* Configure the system clock */
  SystemClock_Config();

  /* Initialize all configured peripherals */
  MX_GPIO_Init();
  MX_TIM2_Init();
  MX_SPI2_Init();
  MX_TIM5_Init();
  MX_USART1_UART_Init();
  MX_SPI4_Init();
  MX_ADC1_Init();
  /* USER CODE BEGIN 2 */

	/* GPIO Enables Voltages */
	HAL_GPIO_WritePin(EN_5V_GPIO_Port, EN_5V_Pin, GPIO_PIN_SET); //Enables 5V
	HAL_GPIO_WritePin(EN_12V_GPIO_Port, EN_12V_Pin, GPIO_PIN_SET); //Enables 12V
	/* DAC Initialization */
	HAL_GPIO_WritePin(GPIOB, DAC_RESET_Pin, GPIO_PIN_RESET);
	HAL_Delay(1);
	HAL_GPIO_WritePin(GPIOB, DAC_RESET_Pin, GPIO_PIN_SET);
	dac = (ad5684_dac_t ) { .spi_handle = &hspi4, .spi_cs_port =
	SPI4_NSS_GPIO_Port, .spi_cs_pin = SPI4_NSS_Pin,
	};
	ad5684_init(&dac);
	display_jazz_init(&display1);
	HAL_GPIO_WritePin(GPIOD, EN_G_Pin | EN_B_Pin | EN_R_Pin, GPIO_PIN_SET); //Display background ON
	Encoder_Init();
	HAL_UART_Receive_IT(&huart1, (uint8_t*) UART1_rxBuffer, 1);
	Z_Axis_TargetPosition = clamp_nonnegative_position(Encoder_GetPosition_Z_AXIS());
	Z_Target_SetRequestedDirect(Z_Axis_TargetPosition);
  /* USER CODE END 2 */

  /* Infinite loop */
  /* USER CODE BEGIN WHILE */
	while (1) {
		TestRunStats_t stats;

		/* Druckmotor nur bei Zustandswechsel neutralisieren (entlastet SPI-Bus) */
		static run_state_t s_last_motor_state = STOP;
		if (current_state != s_last_motor_state) {
			if (current_state != TEST_RUN) {
				d_mot_control(&dac, 2.5f);
			}
			s_last_motor_state = current_state;
		}

		if (current_state == IDLE_START) {
			white_light();
			if (HAL_GetTick() >= next_uart_status_tick) {
				next_uart_status_tick = HAL_GetTick() + 500;
				uart_send_status();
				uart_send_text("Bitte Referenzieren\r\n", 100);
			}
			//Referenzlauf starten
		} else if (current_state == EXEC_REFERENCE_RUN) {
			Z_Axis_ReferenceRun(&dac, &z_axis_success);
			if (z_axis_success) {
				uart_send_status();
				uart_send_text("Z-Achse Referenz OK\r\n", 1000);
			} else {
				uart_send_status();
				uart_send_text("Z-Achse Referenz Fehler\r\n", 1000);
			    strcpy(error_message, "Z-Achse Referenzfehler");
				red_light();
				current_state = FEHLER;
				continue;
			}
			HAL_Delay(1000);
			A_Axis_ReferenceRun(&dac, &a_axis_success);
			if (a_axis_success) {
				uart_send_status();
				uart_send_text("A-Achse Referenz OK\r\n", 1000);
			} else {
				uart_send_status();
				char err_buf[160];
				if (a_axis_last_ref_result == A_REF_ERR_DRUCKSENSOR) {
					float ds_volt = (float)a_axis_trip_adc_val * (5.0f / 4095.0f);
					snprintf(err_buf, sizeof(err_buf),
						"A-Achse Referenz FEHLER: Drucksensor hat ausgeloest! (IST: %.2fV / %u inc > 100 inc -> Hebel auf ~0,04V einstellen)\r\n",
						ds_volt, a_axis_trip_adc_val);
					strcpy(error_message, "A-Achse: Drucksensor (Hebel!)");
				} else if (a_axis_last_ref_result == A_REF_ERR_NO_MOVEMENT) {
					int32_t a_stroke = labs(a_encoder_end - a_encoder_start);
					snprintf(err_buf, sizeof(err_buf),
						"A-Achse Referenz FEHLER: Kein Hub erkannt (%ld inc < 30 inc)! Motor, Riemen oder Encoderkabel pruefen.\r\n",
						(long)a_stroke);
					strcpy(error_message, "A-Achse: Motor/Kabel (kein Hub)");
				} else {
					snprintf(err_buf, sizeof(err_buf), "A-Achse Referenz Fehler\r\n");
					strcpy(error_message, "A-Achse Referenzfehler");
				}
				uart_send_text(err_buf, 1000);
				red_light();
				current_state = FEHLER;
				continue;
			}
			d_mot_control(&dac, 2.5f);
			HAL_Delay(500);
			HAL_GPIO_WritePin(GPIOB, Z_AX_REL_EN_Pin, GPIO_PIN_SET);
			HAL_GPIO_WritePin(GPIOB, A_AX_REL_EN_Pin, GPIO_PIN_SET);
			Z_PID_Reset();
			Z_Target_SetRequestedDirect(Z_Axis_TargetPosition);
			current_state = TEST_START;

		} else if (current_state == TEST_START) {
			white_light();
			if (HAL_GetTick() >= next_uart_status_tick) {
				next_uart_status_tick = HAL_GetTick() + 500;
				uart_send_status();
				uart_send_text("Modus?\r\n", 100);
			}
			//Testlauf durchführen
			} else if (current_state == TEST_RUN) {
				white_light();

				bool tick = tick_100ms_testrun_elapsed;
				if (tick) tick_100ms_testrun_elapsed = false;

				TestRunResult_t result = TestRun_Tick(tick);

				if (result == TESTRUN_COMPLETE) {
					completed_stats_sent = false;
					test_summary_sent = false;
					current_state = COMPLETED;
				} else if (result == TESTRUN_ERROR) {
					TestRun_GetErrorMessage(error_message, sizeof(error_message));
					TestRun_GetStats(&stats);
					char summary[450];
					uint32_t time_min = stats.test_time_ms / 60000u;
					uint32_t time_sec = (stats.test_time_ms / 1000u) % 60u;
					const char *phase = TestRun_GetPhaseName();
					snprintf(summary, sizeof(summary),
						"TEST_SUMMARY:status=ERROR,cycles=%lu,done=%lu,ds_err=%lu,no_err=%lu,valid_sensor=%lu,invalid_sensor=%lu,motor_fault=%lu,z_ist_min=%ld,z_ist_max=%ld,z_soll_min=%ld,z_soll_max=%ld,last_ist=%ld,last_soll=%ld,phase=%s,time_m=%lu,time_s=%lu,last_delta=%ld,overshoot=%ld,lost=%ld,no_sensor_pos=%ld,v_max=%.1f,a_max=%.1f,a_brake=%.1f,last_error=%s\r\n\r\n",
						stats.total_cycles, stats.completed_cycles, stats.ds_errors, stats.no_sensor_errors,
						stats.valid_sensor_events, stats.invalid_sensor_events, stats.motor_faults,
						(long)stats.z_ist_min, (long)stats.z_ist_max,
						(long)stats.z_soll_min, (long)stats.z_soll_max,
						(long)stats.last_ist_pos, (long)stats.last_soll_pos,
						phase,
						time_min, time_sec,
						(long)stats.last_cycle_delta, (long)stats.last_cycle_overshoot,
						(long)stats.last_cycle_lost_steps, (long)stats.no_sensor_pos,
						(double)stats.max_velocity_mms, (double)stats.max_accel_g, (double)stats.max_decel_g,
						error_message);
					uart_send_text(summary, 100);
					test_summary_sent = true;
					red_light();
					current_state = FEHLER;
				}
			} else if (current_state == STOP) {
			yellow_light();
			if (HAL_GetTick() >= next_uart_status_tick) {
				next_uart_status_tick = HAL_GetTick() + 1000;
				uart_send_status();
				uart_send_text("Test abgebrochen\r\n", 50);
			}
		} else if (current_state == COMPLETED) {
			green_light();

			TestRun_GetStats(&stats);

			/* Statistiken und Pufferdaten einmalig nach Testabschluss senden */
			if (!completed_stats_sent) {
				completed_stats_sent = true;
				if (TestRun_GetMode() == TESTRUN_MODE_B_PROBE_SCATTER) {
					TestBScatterStats_t b_stats;
					TestRun_GetScatterStats(&b_stats);
					char stats_msg[500];
					snprintf(stats_msg, sizeof(stats_msg),
						"TEST_B_SUMMARY:status=OK,cycles=%lu,done=%lu,z_ref=%ld,z_min=%ld,z_max=%ld,delta_min=%ld,delta_max=%ld,range=%ld,mean=%.1f,baseline_v=%.3f,trig_v=%.3f,time_ms=%lu,speed_level=%u,v_max=%.1f,a_max=%.1f,a_brake=%.1f,no_sensor_pos=%ld,contact_travel=%lu,peak_v=%.3f\r\n\r\n",
						stats.total_cycles, stats.completed_cycles,
						(long)b_stats.z_ref_pos,
						(long)b_stats.z_min_pos, (long)b_stats.z_max_pos,
						(long)(b_stats.z_min_pos - b_stats.z_ref_pos),
						(long)(b_stats.z_max_pos - b_stats.z_ref_pos),
						(long)b_stats.scatter_range,
						(double)b_stats.mean_pos,
						(double)((float)b_stats.baseline_adc * (5.0f / 4095.0f)),
						(double)((float)b_stats.trigger_adc * (5.0f / 4095.0f)),
						(unsigned long)stats.test_time_ms,
						(unsigned)b_stats.fast_speed_level,
						(double)b_stats.max_velocity_mms, (double)b_stats.max_accel_g, (double)b_stats.max_decel_g,
						(long)z_ax_no_pos,
						(unsigned long)b_stats.contact_travel_inc,
						(double)((float)b_stats.peak_ds_adc * (5.0f / 4095.0f)));

					/* Zuerst alle Einzelzyklen senden, damit die Summary-Auswertung
					 * im Terminal/GUI chronologisch ganz unten (am Ende) steht */
					TestRun_DumpCyclesUART();
					uart_send_text(stats_msg, 100);
				} else {
					char stats_msg[450];
					uint32_t time_min = stats.test_time_ms / 60000u;
					uint32_t time_sec = (stats.test_time_ms / 1000u) % 60u;
					const char *phase = TestRun_GetPhaseName();
					snprintf(stats_msg, sizeof(stats_msg),
						"TEST_SUMMARY:status=OK,cycles=%lu,done=%lu,ds_err=%lu,no_err=%lu,valid_sensor=%lu,invalid_sensor=%lu,motor_fault=%lu,z_ist_min=%ld,z_ist_max=%ld,z_soll_min=%ld,z_soll_max=%ld,last_ist=%ld,last_soll=%ld,phase=%s,time_m=%lu,time_s=%lu,last_delta=%ld,overshoot=%ld,lost=%ld,no_sensor_pos=%ld,v_max=%.1f,a_max=%.1f,a_brake=%.1f\r\n\r\n",
						stats.total_cycles, stats.completed_cycles, stats.ds_errors, stats.no_sensor_errors,
						stats.valid_sensor_events, stats.invalid_sensor_events, stats.motor_faults,
						(long)stats.z_ist_min, (long)stats.z_ist_max,
						(long)stats.z_soll_min, (long)stats.z_soll_max,
						(long)stats.last_ist_pos, (long)stats.last_soll_pos,
						phase,
						time_min, time_sec,
						(long)stats.last_cycle_delta, (long)stats.last_cycle_overshoot,
						(long)stats.last_cycle_lost_steps, (long)stats.no_sensor_pos,
						(double)stats.max_velocity_mms, (double)stats.max_accel_g, (double)stats.max_decel_g);
					uart_send_text(stats_msg, 100);
				}
			}

			if (HAL_GetTick() >= next_uart_status_tick) {
				next_uart_status_tick = HAL_GetTick() + 1000;
				uart_send_status();
				uart_send_text("Test abgeschlossen\r\n", 50);
			}
			Z_Target_SetRequestedDirect(z_ax_no_pos + 50);
		} else if (current_state == FEHLER) {
			red_light();
			if (HAL_GetTick() >= next_uart_status_tick) {
				next_uart_status_tick = HAL_GetTick() + 1000;
				uart_send_status();
				uart_send_text("FEHLER\r\n", 50);
			}
			if (!test_summary_sent) {
				TestRun_GetStats(&stats);
				char summary[450];
				uint32_t time_min = stats.test_time_ms / 60000u;
				uint32_t time_sec = (stats.test_time_ms / 1000u) % 60u;
				const char *phase = TestRun_GetPhaseName();
				snprintf(summary, sizeof(summary),
					"TEST_SUMMARY:status=ERROR,cycles=%lu,done=%lu,ds_err=%lu,no_err=%lu,valid_sensor=%lu,invalid_sensor=%lu,motor_fault=%lu,z_ist_min=%ld,z_ist_max=%ld,z_soll_min=%ld,z_soll_max=%ld,last_ist=%ld,last_soll=%ld,phase=%s,time_m=%lu,time_s=%lu,last_delta=%ld,overshoot=%ld,lost=%ld,no_sensor_pos=%ld,v_max=%.1f,a_max=%.1f,a_brake=%.1f,last_error=%s\r\n\r\n",
					stats.total_cycles, stats.completed_cycles, stats.ds_errors, stats.no_sensor_errors,
					stats.valid_sensor_events, stats.invalid_sensor_events, stats.motor_faults,
					(long)stats.z_ist_min, (long)stats.z_ist_max,
					(long)stats.z_soll_min, (long)stats.z_soll_max,
					(long)stats.last_ist_pos, (long)stats.last_soll_pos,
					phase,
					time_min, time_sec,
					(long)stats.last_cycle_delta, (long)stats.last_cycle_overshoot,
					(long)stats.last_cycle_lost_steps, (long)stats.no_sensor_pos,
					(double)stats.max_velocity_mms, (double)stats.max_accel_g, (double)stats.max_decel_g,
					error_message);
				uart_send_text(summary, 100);
				test_summary_sent = true;
			}
			Z_Target_SetRequestedDirect(clamp_nonnegative_position(Encoder_GetPosition_Z_AXIS()));
		}
		// Accumulate UART bytes into lines, process on '\n'
		// Single-char and multi-char commands (e.g. "Z1500\n") both work
		static char uart_line_buf[64];
		static uint8_t uart_line_len = 0;
		while (uart_cmd_tail != uart_cmd_head) {
			char c = (char)uart_cmd_buf[uart_cmd_tail];
			uart_cmd_tail = (uart_cmd_tail + 1) % UART_CMD_BUF_SIZE;
			if (c == '\n' || c == '\r') {
				if (uart_line_len > 0) {
					uart_line_buf[uart_line_len] = '\0';
					Process_UART_Command(uart_line_buf);
					uart_line_len = 0;
					break; /* Vollständigen Befehl abarbeiten, dann nächsten Schleifenzyklus */
				}
			} else if (uart_line_len < (uint8_t)(sizeof(uart_line_buf) - 1)) {
				uart_line_buf[uart_line_len++] = c;
			} else {
				uart_line_len = 0; // overflow: discard
			}
		}
		if (HAL_GetTick() >= next_100ms_tick) {
			next_100ms_tick = HAL_GetTick() + 100;
			tick_100ms_testrun_elapsed = true;
			if (current_state != TEST_RUN) {
				update_display();
			}
		}
		if (HAL_GetTick() >= next_10ms_tick) {
			next_10ms_tick = HAL_GetTick() + 10;

			handle_button_ok();
			handle_button_up();
			handle_button_down();

			/* Globale Taster-Funktionen (REF / HOME / RESET) */
			if (btn_up_pressed) {
				btn_up_pressed = 0;
				/* Taste 1 (Links): REFERENZLAUF */
				if (current_state != TEST_RUN) {
					Z_PID_Reset();
					Z_PID_SetSchedulerEnabled(true);
					current_state = EXEC_REFERENCE_RUN;
					uart_send_text("Referenzlauf via Taste gestartet.\r\n", 50);
				}
			}
			if (btn_ok_pressed) {
				btn_ok_pressed = 0;
				/* Taste 2 (Mitte): HOME / START-FREIGABE / FEHLER QUITTIEREN */
				if (current_state != TEST_RUN) {
					HAL_GPIO_WritePin(GPIOB, Z_AX_REL_EN_Pin, GPIO_PIN_SET);
					HAL_GPIO_WritePin(GPIOB, A_AX_REL_EN_Pin, GPIO_PIN_SET);
					Z_PID_Reset();
					Z_PID_SetSchedulerEnabled(true);
					uint32_t home_pos = (z_ax_no_pos > 0) ? (z_ax_no_pos + 50) : clamp_nonnegative_position(Encoder_GetPosition_Z_AXIS());
					Z_Target_SetRequestedDirect(home_pos);
					current_state = TEST_START;
					uart_send_text("Home / Freigabe via Taste OK.\r\n", 50);
				}
			}
			if (btn_down_pressed) {
				btn_down_pressed = 0;
				/* Taste 3 (Rechts): NOT-HALT (im Test) oder HARDWARE RESET (im Stillstand) */
				if (current_state == TEST_RUN) {
					TestRun_RestoreSpeedLevel();
					Z_PID_EmergencyStop(&dac);
					current_state = STOP;
					uart_send_text("NOT-HALT via Taste DOWN!\r\n", 50);
				} else {
					uart_send_text("System Reset via Taste DOWN...\r\n", 50);
					HAL_Delay(50);
					NVIC_SystemReset();
				}
			}
		}
		if (HAL_GetTick() >= next_1ms_tick) {
			next_1ms_tick += 1u;
			if (HAL_GetTick() - next_1ms_tick > 10u) {
				next_1ms_tick = HAL_GetTick() + 1u;
			}
			if (current_state == TEST_START || current_state == TEST_RUN || current_state == COMPLETED) {
				A_Axis_PIDControl(&dac, A_Axis_TargetPosition);
				if (!Z_Axis_PIDControl(&dac, Z_Axis_TargetPosition)) {
					char reason_buf[64];
					snprintf(reason_buf, sizeof(reason_buf), "%s", Z_PID_GetTripReason());
					Z_PID_EmergencyStop(&dac);
					snprintf(error_message, sizeof(error_message), "%s", reason_buf);
					red_light();
					current_state = FEHLER;
					uart_send_status();
					char uart_err[96];
					snprintf(uart_err, sizeof(uart_err), "NOT-STOPP: %s\r\n", reason_buf);
					uart_send_text(uart_err, 50);
				}
			} else if (current_state == IDLE_START || current_state == STOP || current_state == FEHLER) {
				ad5684_set_voltage(&dac, 2.5f, a_mot);
				ad5684_set_voltage(&dac, 2.5f, z_mot);
			}
		}

    /* USER CODE END WHILE */

    /* USER CODE BEGIN 3 */

	}

	return 0;
  /* USER CODE END 3 */
}

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
 /* MPU Configuration */

void MPU_Config(void)
{
  MPU_Region_InitTypeDef MPU_InitStruct = {0};

  /* Disables the MPU */
  HAL_MPU_Disable();

  /** Initializes and configures the Region and the memory to be protected
  */
  MPU_InitStruct.Enable = MPU_REGION_ENABLE;
  MPU_InitStruct.Number = MPU_REGION_NUMBER0;
  MPU_InitStruct.BaseAddress = 0x0;
  MPU_InitStruct.Size = MPU_REGION_SIZE_4GB;
  MPU_InitStruct.SubRegionDisable = 0x87;
  MPU_InitStruct.TypeExtField = MPU_TEX_LEVEL0;
  MPU_InitStruct.AccessPermission = MPU_REGION_NO_ACCESS;
  MPU_InitStruct.DisableExec = MPU_INSTRUCTION_ACCESS_DISABLE;
  MPU_InitStruct.IsShareable = MPU_ACCESS_SHAREABLE;
  MPU_InitStruct.IsCacheable = MPU_ACCESS_NOT_CACHEABLE;
  MPU_InitStruct.IsBufferable = MPU_ACCESS_NOT_BUFFERABLE;

  HAL_MPU_ConfigRegion(&MPU_InitStruct);
  /* Enables the MPU */
  HAL_MPU_Enable(MPU_PRIVILEGED_DEFAULT);

}

/**
  * @brief  This function is executed in case of error occurrence.
  * @retval None
  */
void Error_Handler(void)
{
  /* USER CODE BEGIN Error_Handler_Debug */
	/* User can add his own implementation to report the HAL error return state */
	__disable_irq();
	while (1) {
	}
  /* USER CODE END Error_Handler_Debug */
}

#ifdef  USE_FULL_ASSERT
/**
  * @brief  Reports the name of the source file and the source line number
  *         where the assert_param error has occurred.
  * @param  file: pointer to the source file name
  * @param  line: assert_param error line source number
  * @retval None
  */
void assert_failed(uint8_t *file, uint32_t line)
{
  /* USER CODE BEGIN 6 */
/* User can add his own implementation to report the file name and line number,
ex: printf("Wrong parameters value: file %s on line %d\r\n", file, line) */
  /* USER CODE END 6 */
}
#endif /* USE_FULL_ASSERT */
