marka87/GRAF_MNP/Software/GRAF_MNPA/Core/Src/d_mot_control.h

/*
 * d_mot_control.h
 *
 *  Created on: Jan 22, 2025
 *      Author: Mark
 */

#ifndef SRC_D_MOT_CONTROL_H_
#define SRC_D_MOT_CONTROL_H_

#include "AD5684RARUZ.h"

void d_mot_control(ad5684_dac_t* dac, float d_mot_voltage);

#endif /* SRC_D_MOT_CONTROL_H_ */
