marka87/GRAF_MNP/Software/GRAF_MNPA/Core/Src/display.c

/*
* display.c
*
*  Created on: Nov 27, 2024
*      Author: AnMa
*/

//#include <asf.h>
#include "display.h"
#include <string.h>
#include <stdarg.h>
#include <stdio.h>
char display_buffer[DISPLAY_MAX_LINES][30] = { { 0 } };



// Display Commands (ST7567) //Instruction Table DB 21/49
#define DISPLAY_JAZZ_CMD_DISPLAY_ON_OFF				(0xAE)
#define DISPLAY_ON							(0x01)
#define DISPLAY_JAZZ_CMD_SET_START_LINE				(0x40)
#define DISPLAY_JAZZ_CMD_SET_PAGE_ADDRESS			(0xB0)
#define DISPLAY_JAZZ_CMD_SET_COLUMN_ADDRESS_MSB		(0x10)
#define DISPLAY_JAZZ_CMD_SET_COLUMN_ADDRESS_LSB		(0x00)
#define DISPLAY_JAZZ_CMD_SEG_DIRECTION				(0xA0)
#define SEG_DIRECTION_NORMAL				(0x00)
#define SEG_DIRECTION_REVERSE				(0x01)
#define DISPLAY_JAZZ_CMD_INVERSE_DISPLAY				(0xA6)
#define INVERSE_DISPLAY_NORMAL				(0x00)
#define INVERSE_DISPLAY_INVERSE				(0x01)
#define DISPLAY_JAZZ_CMD_ALL_PIXEL_ON				(0xA4)
#define ALL_PIXEL_ON_NORMAL					(0x00)
#define ALL_PIXEL_ON_ALL_PIXEL_ON			(0x01)
#define DISPLAY_JAZZ_CMD_BIAS_SELECT					(0xA2)
#define BIAS_SELECT_1_9						(0x00)
#define BIAS_SELECT_1_7						(0x01)
#define DISPLAY_JAZZ_CMD_END							(0xEE)
#define DISPLAY_JAZZ_CMD_RESET						(0xE2)
#define DISPLAY_JAZZ_CMD_COM_DIRECTION				(0xC0)
#define COM_DIRECTION_NORMAL				(0x00)
#define COM_DIRECTION_REVERSE				(0x08)
#define DISPLAY_JAZZ_CMD_POWER_CONTROL				(0x28)
#define BUILT_IN_BOOSTER_ON					(0x04)
#define BUILT_IN_REGULATOR_ON				(0x02)
#define BUILT_IN_FOLLOWER_ON				(0x01)
#define DISPLAY_JAZZ_CMD_REGULATION_RATIO			(0x20)
#define REGULATION_RATIO_RR0				(0x01)
#define REGULATION_RATIO_RR1				(0x02)
#define REGULATION_RATIO_RR2				(0x04)
#define DISPLAY_JAZZ_CMD_SET_EV						(0x81)
#define EV_EV0								(0x01)
#define EV_EV1								(0x02)
#define EV_EV2								(0x04)
#define EV_EV3								(0x08)
#define EV_EV4								(0x10)
#define EV_EV5								(0x20)
#define DISPLAY_JAZZ_CMD_SET_BOOSTER					(0xF8)
#define BOOSTER_LEVEL_4X					(0x00)
#define BOOSTER_LEVEL_5X					(0x01)
#define DISPLAY_JAZZ_CMD_NOP							(0xE3)

// The default font
const uint8_t font5x7[128][6] =
{
	{0x00,0x00,0x00,0x00,0x00,0x00},	// NULL
	{0x00,0x00,0x00,0x00,0x00,0x00},	// Start of header
	{0x00,0x00,0x00,0x00,0x00,0x00},	// Start of Text
	{0x00,0x00,0x00,0x00,0x00,0x00},	// End of text
	{0x00,0x00,0x00,0x00,0x00,0x00},	// End of transmission
	{0x00,0x00,0x00,0x00,0x00,0x00},	// Enquiry
	{0x00,0x00,0x00,0x00,0x00,0x00},	// Acknowledge
	{0x00,0x00,0x00,0x00,0x00,0x00},	// Bell
	{0x00,0x00,0x00,0x00,0x00,0x00},	// Backspace
	{0x00,0x00,0x00,0x00,0x00,0x00},	// Horizontal tab

	{0x00,0x00,0x00,0x00,0x00,0x00},	// Line feed
	{0x00,0x00,0x00,0x00,0x00,0x00},	// Vertical Tab
	{0x00,0x00,0x00,0x00,0x00,0x00},	// Form feed
	{0x00,0x00,0x00,0x00,0x00,0x00},	// Carriage return
	{0x00,0x00,0x00,0x00,0x00,0x00},	// Shift out
	{0x00,0x00,0x00,0x00,0x00,0x00},	// Shift in
	{0x00,0x00,0x00,0x00,0x00,0x00},	// Delete
	{0x00,0x04,0x02,0x7D,0x02,0x04},	// Arrow up
	{0x00,0x10,0x20,0x5F,0x20,0x10},	// Arrow down
	{0x00,0x08,0x14,0x2A,0x08,0x08},	// Arrow left

	{0x00,0x08,0x08,0x2A,0x14,0x08},	// Arrow right
	{0x00,0x00,0x00,0x00,0x00,0x00},	// Negative Acknowledge
	{0x00,0x00,0x00,0x00,0x00,0x00},	// Synchronous Idle
	{0x00,0x00,0x00,0x00,0x00,0x00},	// End of transmission block
	{0x00,0x00,0x00,0x00,0x00,0x00},	// Cancel
	{0x00,0x00,0x00,0x00,0x00,0x00},	// End of medium
	{0x00,0x00,0x00,0x00,0x00,0x00},	// Substitude
	{0x00,0x00,0x00,0x00,0x00,0x00},	// Escape
	{0x00,0x00,0x00,0x00,0x00,0x00},	// File seperator
	{0x00,0x00,0x00,0x00,0x00,0x00},	// Group seperator

	{0x00,0x00,0x00,0x00,0x00,0x00},	// Record seperator
	{0x00,0x00,0x00,0x00,0x00,0x00},	// Unit seperator
	{0x00,0x00,0x00,0x00,0x00,0x00},	// SPACE
	{0x00,0x00,0x00,0x4F,0x00,0x00},	// !
	{0x00,0x00,0x07,0x00,0x07,0x00},	// "
	{0x00,0x14,0x7F,0x14,0x7F,0x14},	// #
	{0x00,0x24,0x2A,0x7F,0x2A,0x12},	// $
	{0x00,0x23,0x13,0x08,0x64,0x62},	// %
	{0x00,0x36,0x49,0x55,0x22,0x50},	// &
	{0x00,0x00,0x05,0x03,0x00,0x00},	// '

	{0x00,0x00,0x1C,0x22,0x41,0x00},	// (
	{0x00,0x00,0x41,0x22,0x1C,0x00},	// )
	{0x00,0x14,0x08,0x3E,0x08,0x14},	// *
	{0x00,0x08,0x08,0x3E,0x08,0x08},	// +
	{0x00,0x00,0x50,0x30,0x00,0x00},	// ,
	{0x00,0x08,0x08,0x08,0x08,0x08},	// -
	{0x00,0x00,0x60,0x60,0x00,0x00},	// .
	{0x00,0x20,0x10,0x08,0x04,0x02},	// /
	{0x00,0x3E,0x51,0x49,0x45,0x3E},	// 0
	{0x00,0x00,0x42,0x7F,0x40,0x00},	// 1

	{0x00,0x42,0x61,0x51,0x49,0x46},	// 2
	{0x00,0x21,0x41,0x45,0x4B,0x31},	// 3
	{0x00,0x18,0x14,0x12,0x7F,0x10},	// 4
	{0x00,0x27,0x45,0x45,0x45,0x39},	// 5
	{0x00,0x3C,0x4A,0x49,0x49,0x30},	// 6
	{0x00,0x01,0x71,0x09,0x05,0x03},	// 7
	{0x00,0x36,0x49,0x49,0x49,0x36},	// 8
	{0x00,0x06,0x49,0x49,0x29,0x1E},	// 9
	{0x00,0x36,0x36,0x00,0x00,0x00},	// :
	{0x00,0x56,0x36,0x00,0x00,0x00},	// ;

	{0x00,0x08,0x14,0x22,0x41,0x00},	// <
	{0x00,0x14,0x14,0x14,0x14,0x14},	// =
	{0x00,0x00,0x41,0x22,0x14,0x08},	// >
	{0x00,0x02,0x01,0x51,0x09,0x06},	// ?
	{0x00,0x30,0x49,0x79,0x41,0x3E},	// @
	{0x00,0x7E,0x11,0x11,0x11,0x7E},	// A
	{0x00,0x7F,0x49,0x49,0x49,0x36},	// B
	{0x00,0x3E,0x41,0x41,0x41,0x22},	// C
	{0x00,0x7F,0x41,0x41,0x22,0x1C},	// D
	{0x00,0x7F,0x49,0x49,0x49,0x41},	// E

	{0x00,0x7F,0x09,0x09,0x09,0x01},	// F
	{0x00,0x3E,0x41,0x49,0x49,0x7A},	// G
	{0x00,0x7F,0x08,0x08,0x08,0x7F},	// H
	{0x00,0x00,0x41,0x7F,0x41,0x00},	// I
	{0x00,0x20,0x40,0x41,0x3F,0x01},	// J
	{0x00,0x7F,0x08,0x14,0x22,0x41},	// K
	{0x00,0x7F,0x40,0x40,0x40,0x40},	// L
	{0x00,0x7F,0x02,0x0C,0x02,0x7F},	// M
	{0x00,0x7F,0x04,0x08,0x10,0x7F},	// N
	{0x00,0x3E,0x41,0x41,0x41,0x3E},	// O

	{0x00,0x7F,0x09,0x09,0x09,0x06},	// P
	{0x00,0x3E,0x41,0x51,0x21,0x5E},	// Q
	{0x00,0x7F,0x09,0x19,0x29,0x46},	// R
	{0x00,0x46,0x49,0x49,0x49,0x31},	// S
	{0x00,0x01,0x01,0x7F,0x01,0x01},	// T
	{0x00,0x3F,0x40,0x40,0x40,0x3F},	// U
	{0x00,0x1F,0x20,0x40,0x20,0x1F},	// V
	{0x00,0x3F,0x40,0x30,0x40,0x3F},	// W
	{0x00,0x63,0x14,0x08,0x14,0x63},	// X
	{0x00,0x07,0x08,0x70,0x08,0x07},	// Y

	{0x00,0x61,0x51,0x49,0x45,0x43},	// Z
	{0x00,0x00,0x7F,0x41,0x41,0x00},	// [
	{0x00,0x02,0x04,0x08,0x10,0x20},	// Backslash
	{0x00,0x00,0x41,0x41,0x7F,0x00},	// ]
	{0x00,0x04,0x02,0x01,0x02,0x04},	// ^
	{0x00,0x40,0x40,0x40,0x40,0x40},	// _
	{0x00,0x00,0x01,0x02,0x04,0x00},	// `
	{0x00,0x20,0x54,0x54,0x54,0x78},	// a
	{0x00,0x7F,0x50,0x48,0x48,0x30},	// b
	{0x00,0x38,0x44,0x44,0x44,0x20},	// c

	{0x00,0x38,0x44,0x44,0x48,0x7F},	// d
	{0x00,0x38,0x54,0x54,0x54,0x18},	// e
	{0x00,0x08,0x7E,0x09,0x01,0x02},	// f
	{0x00,0x0C,0x52,0x52,0x52,0x3E},	// g
	{0x00,0x7F,0x08,0x04,0x04,0x78},	// h
	{0x00,0x00,0x44,0x7D,0x40,0x00},	// i
	{0x00,0x20,0x40,0x44,0x3D,0x00},	// j
	{0x00,0x7F,0x10,0x28,0x44,0x00},	// k
	{0x00,0x00,0x41,0x7F,0x40,0x00},	// l
	{0x00,0x78,0x04,0x38,0x04,0x78},	// m

	{0x00,0x7C,0x08,0x04,0x04,0x78},	// n
	{0x00,0x38,0x44,0x44,0x44,0x38},	// o
	{0x00,0x7C,0x14,0x14,0x14,0x08},	// p
	{0x00,0x08,0x14,0x14,0x18,0x7C},	// q
	{0x00,0x7C,0x08,0x04,0x04,0x08},	// r
	{0x00,0x48,0x54,0x54,0x54,0x20},	// s
	{0x00,0x04,0x3F,0x44,0x40,0x20},	// t
	{0x00,0x3C,0x40,0x40,0x20,0x7C},	// u
	{0x00,0x1C,0x20,0x40,0x20,0x1C},	// v
	{0x00,0x3C,0x40,0x30,0x40,0x3C},	// w

	{0x00,0x44,0x28,0x10,0x28,0x44},	// x
	{0x00,0x0C,0x50,0x50,0x50,0x3C},	// y
	{0x00,0x44,0x64,0x54,0x4C,0x44},	// z
	{0x00,0x00,0x08,0x36,0x41,0x00},	// Curly brackets open
	{0x00,0x00,0x00,0x7F,0x00,0x00},	// |
	{0x00,0x00,0x41,0x36,0x08,0x00},	// Curly brackets close
	{0x00,0x0C,0x02,0x0C,0x10,0x0C},	// ~
	{0x00,0x00,0x06,0x09,0x09,0x06}		// Degree
};
// umschreiben wegen NSS, vielleicht hier funktioniert. Display SPI2
void display_jazz_write_command(display_info_t* disp, uint8_t cmd) //send a command
{
	HAL_GPIO_WritePin(GPIOB, DISP_A0_Pin, GPIO_PIN_RESET);
//	HAL_GPIO_WritePin(SPI1_NSS_GPIO_Port, SPI1_NSS_Pin, GPIO_PIN_RESET);
//	HAL_SPI_Transmit(disp->spi_handle, &cmd, 1, 2000);
//	HAL_GPIO_WritePin(SPI1_NSS_GPIO_Port, SPI1_NSS_Pin, GPIO_PIN_SET);

	HAL_SPI_Transmit(disp->spi_handle, &cmd, 1, 2000);
	HAL_GPIO_WritePin(GPIOB, DISP_A0_Pin, GPIO_PIN_SET);
}
void display_jazz_write_data(display_info_t* disp, uint8_t data)	//send a data
{
	HAL_GPIO_WritePin(GPIOB, DISP_A0_Pin, GPIO_PIN_SET);
//	HAL_GPIO_WritePin(SPI1_NSS_GPIO_Port, SPI1_NSS_Pin, GPIO_PIN_RESET);
//	HAL_SPI_Transmit(disp->spi_handle, &data, 1, 2000);
//	HAL_GPIO_WritePin(SPI1_NSS_GPIO_Port, SPI1_NSS_Pin, GPIO_PIN_SET);

	HAL_SPI_Transmit(disp->spi_handle, &data, 1, 2000);
	HAL_GPIO_WritePin(GPIOB, DISP_A0_Pin, GPIO_PIN_SET);
}

void display_jazz_reset(display_info_t* disp)	//reset the display - Reset pin L -> wait- H - wait
{
		HAL_GPIO_WritePin(RST_DISPLAY_GPIO_Port, RST_DISPLAY_Pin, GPIO_PIN_RESET);
		HAL_Delay(1);
		HAL_GPIO_WritePin(RST_DISPLAY_GPIO_Port, RST_DISPLAY_Pin, GPIO_PIN_SET);
		HAL_Delay(5);
}

void display_jazz_init(display_info_t* disp)	//display init from ZuMa
{
	display_jazz_reset(disp);

	display_jazz_write_command(disp, DISPLAY_JAZZ_CMD_SET_START_LINE);
	display_jazz_write_command(disp, DISPLAY_JAZZ_CMD_BIAS_SELECT | BIAS_SELECT_1_9);
	display_jazz_write_command(disp, DISPLAY_JAZZ_CMD_SEG_DIRECTION | SEG_DIRECTION_REVERSE);
	display_jazz_write_command(disp, DISPLAY_JAZZ_CMD_INVERSE_DISPLAY | INVERSE_DISPLAY_NORMAL);
	display_jazz_write_command(disp, DISPLAY_JAZZ_CMD_COM_DIRECTION | COM_DIRECTION_REVERSE);
	display_jazz_write_command(disp, DISPLAY_JAZZ_CMD_REGULATION_RATIO | REGULATION_RATIO_RR0 | REGULATION_RATIO_RR1 | REGULATION_RATIO_RR2);
	display_jazz_write_command(disp, DISPLAY_JAZZ_CMD_SET_EV);
	display_jazz_write_command(disp, EV_EV3);
	display_jazz_write_command(disp, DISPLAY_JAZZ_CMD_SET_BOOSTER);
	display_jazz_write_command(disp, BOOSTER_LEVEL_5X);
	display_jazz_write_command(disp, DISPLAY_JAZZ_CMD_POWER_CONTROL | BUILT_IN_BOOSTER_ON | BUILT_IN_REGULATOR_ON | BUILT_IN_FOLLOWER_ON);
	display_jazz_write_command(disp, DISPLAY_JAZZ_CMD_DISPLAY_ON_OFF | DISPLAY_ON);
	display_jazz_clear(disp);

}

void display_jazz_fillpattern(display_info_t* disp, uint8_t pattern) {
	for (uint32_t page = 0; page < disp->lcd_ram_pages; page++) {

		display_jazz_position(disp, page, 0);	// column increments automatically

		for(uint32_t column = 0; column < disp->lcd_width; column++) {

			display_jazz_write_data(disp, pattern);
		}
	}
}

void display_jazz_position(display_info_t* disp, uint8_t page, uint8_t column) {
	uint8_t column_offset = 4;		// set column_offset to zero, if SEG Direction is normal and COM Direction is normal
	display_jazz_write_command(disp, DISPLAY_JAZZ_CMD_SET_PAGE_ADDRESS | (page & 0x0F));			// page address
	display_jazz_write_command(disp, DISPLAY_JAZZ_CMD_SET_COLUMN_ADDRESS_MSB | (((column+column_offset)>>4) & 0x0F));		// MSB column address
	display_jazz_write_command(disp, DISPLAY_JAZZ_CMD_SET_COLUMN_ADDRESS_LSB | ((column+column_offset) & 0x0F));				// LSB column address
}

void display_jazz_write_string(display_info_t* disp, uint8_t row, const char * fmt, ...) {

	char text[256] = {0};

	va_list args;
	va_start(args, fmt);
	vsnprintf(text, 255, fmt, args);
	va_end(args);

	display_jazz_write_string_5x7(disp, row, text);
}
void display_jazz_write_string_5x7(display_info_t* disp, uint32_t row, char *str) {
	uint32_t len = strlen(str);
	const int char_size = 6;

	uint32_t row_length_char = disp->lcd_width / char_size;

	// Check if the string matches the display area, otherwise reduce the string length
	if (len > row_length_char) {
		len = row_length_char;	// Reduce string to a useful size
	}

	display_jazz_position(disp, 0, 0);

	for (uint32_t i = 0; i < len; i++) {
		display_jazz_write_letter_5x7(disp, row, i * 6, str[i]);
	}

	// check if we need to add empty characters
	for (uint32_t i = len; i < row_length_char; i++) {
		display_jazz_write_letter_5x7(disp, row, i * 6, ' ');
	}
}
void display_jazz_write_letter_5x7(display_info_t* disp, uint8_t row, uint8_t column, char c) {

	display_jazz_position(disp, row, column);

	for (uint8_t i = 0; i < 6; i++)	{
		display_jazz_write_data(disp, font5x7[(uint8_t)c][i]);
	}

}

void display_jazz_clear(display_info_t* disp) {

	display_jazz_fillpattern(disp, 0x00);
}

void print_graph(display_info_t* disp, uint8_t data[], uint32_t size) {
	uint8_t page = 3;
	uint8_t column = 0;

	display_jazz_position(disp, 3, 0);

	for(uint32_t i = 0; i < size; i++) {
		display_jazz_write_data(disp, data[i]);
		column++;

		if(column >= disp->lcd_width) {	// end of column
			page++;
			column = 0;
			display_jazz_position(disp, page, column);	// jump to next page, start from column 0
		}
	}
}
