marka87/GRAF_MNP/Software/GRAF_MNPA/Core/Src/AD5684RARUZ.c

/*
 * AD5684RARUZ.c
 *
 * x.x = Spg wert zB 2.5
 * ad5684_set_voltage(&dac, x.x, 0x01); // DAC A auf 2.5V setzen
 * ad5684_set_voltage(&dac, x.x, 0x02); // DAC B auf 3.3V setzen
 * ad5684_set_voltage(&dac, x.x, 0x04); // DAC C auf 1.2V setzen
 * Vout A	0 0 0 1 DAC A	A_AXIS_DAC - A8 pin
 * Vout B	0 0 1 0 DAC B	Z_AXIS_DAC - A18 pin
 * Vout C	0 1 0 0 DAC C	DRUCKMOTOR_DAC - A24
 *
 * 0 0 1 1 Write to and update DAC Channel
 *
 * dac_a = 0x31;
 * dac_b = 0x32;
 * dac_c = 0x34;
 *  Created on: Nov 4, 2024
 *      Author: anma
 */

#include "AD5684RARUZ.h"

#include <stm32f7xx_hal_gpio.h>
#include <sys/_stdint.h>

void ad5684_init(ad5684_dac_t *dac) {
	uint8_t tx_buffer[3];
	tx_buffer[0] = 0x40; // Internal reference setup / enable DAC channels
	tx_buffer[1] = 0x00;
	tx_buffer[2] = 0x00;

	HAL_GPIO_WritePin(dac->spi_cs_port, dac->spi_cs_pin, GPIO_PIN_RESET);
	HAL_SPI_Transmit(dac->spi_handle, tx_buffer, 3, 10);
	HAL_GPIO_WritePin(dac->spi_cs_port, dac->spi_cs_pin, GPIO_PIN_SET);
}

void ad5684_set_voltage(ad5684_dac_t *dac, float voltage, uint8_t dac_channel) {
	uint16_t ad5684_data = (uint16_t)((voltage / 5.0f) * 65535);

	HAL_GPIO_WritePin(dac->spi_cs_port, dac->spi_cs_pin, GPIO_PIN_RESET);
	uint8_t tx_buffer[3];
	// Write to and Update DAC
	tx_buffer[0] = 0x30 | dac_channel;	// 0011 (Write + Update)
	tx_buffer[1] = (ad5684_data >> 8);	// Obere 8 Bits
	tx_buffer[2] = (ad5684_data); 		// Untere

	// Daten an DAC senden (max 1 ms Timeout fuer harte 1-ms-Regelzyklen)
	HAL_SPI_Transmit(dac->spi_handle, tx_buffer, sizeof(tx_buffer), 1);
	HAL_GPIO_WritePin(dac->spi_cs_port, dac->spi_cs_pin, GPIO_PIN_SET);
}
