marka87/GRAF_MNP/Software/GRAF_MNPA/Core/Src/ADC_task.h

/*
 * task.h
 *
 *  Created on: Dec 15, 2024
 *      Author: Mark
 */

#ifndef SRC_ADC_TASK_H_
#define SRC_ADC_TASK_H_
#include "AD5684RARUZ.h"

void DAC_Automatic_Adjustment(ad5684_dac_t* dac);


#endif /* SRC_ADC_TASK_H_ */
