marka87/GRAF_MNP/(commit log)

2024-09-12 Beschreibung der zu prüfenden Funktionen.docx
2024-09-24 Doku vorlagen, schule
    [1 Projektstrukturplan-2024_leer.xlsx, Zeiterfassung-E4_S.xlsx]
2024-10-07 Initiales leeres Projekt mit Vorlage Graf
    [GRAF_MNP.PrjPcb, TOP.SchDoc, Top.SchDoc]
2024-10-07 Initiales Projekt
    [Controller.SchDoc, GRAF_MNP.PcbDoc, GRAF_MNP.PrjPcb, Top.SchDoc]
2024-10-07 Haupt IC
    [Controller.SchDoc]
2024-10-07 µC power angefangen
    [Controller.SchDoc]
2024-10-07 IC power weiter + Jtag muster(noch machen mit STM)
    [Controller.SchDoc]
2024-10-07 ContollSupply, JTAG
    [Controller.SchDoc, ControllerSupply.SchDoc, GRAF_MNP.PrjPcb, Top.SchDoc]
2024-10-07 darf ich
    [ControllerSupply.SchDoc]
2024-10-07 LiTh gerichtet, Kondis schöner gemacht
    [Controller.SchDoc, ControllerSupply.SchDoc]
2024-10-07 Display, Power, SPI
    [Controller.SchDoc, Display.SchDoc, GRAF_MNP.PrjPcb, Power.SchDoc, Top.SchDoc]
2024-10-07 Top verbinden mit anderen SCH
    [Controller.SchDoc, Display.SchDoc, Top.SchDoc]
2024-10-08 Frühstück commit
    [Controller.SchDoc, Display.SchDoc, Power.SchDoc, Top.SchDoc]
2024-10-08 GRAF Sch,
    [Top.SchDoc]
2024-10-08 disp fertig, 5v-en, etc
    [Controller.SchDoc, Display.SchDoc, Power.SchDoc, Top.SchDoc]
2024-10-14 ADC; DAC; QUADRATURE; SPI1 auf SPI2
    [Controller.SchDoc, Display.SchDoc, Top.SchDoc]
2024-10-14 Modified .gitignore Modified Elektronik/Powersupply/Powersupply.PcbDoc Modified Elektronik/Powersupply/Powersupply.SchDoc Added Elektronik/Powersupply/Netzteilprint-Schutzgehäuse.STEP Added Elektroni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
    [Netzteilprint-Schutzgehäuse.STEP, Powersupply.PcbDoc, Powersupply.SchDoc, RPS-60.stp]
2024-10-14 Modified Elektronik/Powersupply/Powersupply.PcbDoc Modified Elektronik/Powersupply/Powersupply.SchDoc Added Elektronik/Powersupply/Download_STEP_971060321 (rev1).stp
    [Download_STEP_971060321 (rev1).stp, Powersupply.PcbDoc, Powersupply.SchDoc]
2024-10-14 Modified Elektronik/Powersupply/Powersupply.PrjPcb Added Elektronik/Powersupply/Powersupply.PrjPcbStructure
    [Powersupply.PrjPcb]
2024-10-15 DAC-weitergebaut, SPI1
    [Controller.SchDoc]
2024-10-15 ALLES gerichtet wegen Grid, +Stecker
    [Controller.SchDoc]
2024-10-16 µC supply
    [Controller.SchDoc]
2024-10-16 supply änderungen
    [Controller.SchDoc, ControllerSupply.SchDoc]
2024-10-16 Standard erstellt, kleinigkeiten
    [Controller.SchDoc, GRAF_MNP.PrjPcb]
2024-10-17 Modified DOKU-STUFF/DOKU/Datasheets/AD5686R_5685R_5684R.pdf Modified Elektronik/Controller/Controller.Harness Modified Elektronik/Controller/Controller.SchDoc Modified Elektronik/Controller/Controlle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
    [Connector.SchDoc, Controller.SchDoc, ControllerSupply.SchDoc, GRAF_MNP.PrjPcb]
2024-10-17 Modified Elektronik/Powersupply/Powersupply.PcbDoc Modified Elektronik/Powersupply/Powersupply.PrjPcb Modified Elektronik/Powersupply/Powersupply.SchDoc
    [Powersupply.PcbDoc, Powersupply.PrjPcb, Powersupply.SchDoc]
2024-10-17 Modified .gitignore Added Software/GRAF_MNPA/Drivers/STM32F7xx_HAL_Driver/Inc/stm32f7xx_hal_adc.h Added Software/GRAF_MNPA/Drivers/STM32F7xx_HAL_Driver/Inc/stm32f7xx_hal_adc_ex.h Added Software/GRAF_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
2024-10-17 Connector.SchDoc erstellt, verbunden. SPI1 verbessert ADC-IN7-9 erstellt TIMs zusätzlich
    [Connector.SchDoc, Controller.SchDoc, GRAF_MNP.PrjPcb, Power.SchDoc, Top.SchDoc]
2024-10-17 Stecker fertig, beschriftet internal reset on boot etc
    [Connector.SchDoc, Controller.SchDoc, ControllerSupply.SchDoc, Display.SchDoc, GRAF_MNP.PrjPcb, Power.SchDoc]
2024-10-21 Modified Elektronik/Controller/Connector.SchDoc Modified Elektronik/Controller/Controller.Harness Modified Elektronik/Controller/ControllerSupply.SchDoc Modified Elektronik/Controller/GRAF_MNP.PrjPcb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
    [Connector.SchDoc, ControllerSupply.SchDoc, GRAF_MNP.PrjPcb, Top.SchDoc, USB.SchDoc]
2024-10-21 Modified Elektronik/Controller/Controller.SchDoc Modified Elektronik/Controller/GRAF_MNP.PrjPcbStructure
    [Controller.SchDoc]
2024-10-21 bt puffer
    [Connector.SchDoc, GRAF_MNP.PrjPcb]
2024-10-23 BT ICSN74LXCH-S00
    [Connector.SchDoc]
2024-10-23 Transceiver I/O erstellt
    [Connector.SchDoc, Controller.SchDoc]
2024-10-23 Modified Elektronik/Controller/Connector.SchDoc
    [Connector.SchDoc]
2024-10-23 Modified Elektronik/Controller/Connector.SchDoc Modified Elektronik/Controller/Power.SchDoc
    [Connector.SchDoc, Power.SchDoc]
2024-10-23 +/- 12V
    [Power.SchDoc]
2024-10-23 taster, power led, +-12V fertig
    [Controller.SchDoc, ControllerSupply.SchDoc, Top.SchDoc, USB.SchDoc]
2024-10-24 Board Setup + Cleanup
    [Connector.SchDoc, Controller.SchDoc, ControllerSupply.SchDoc, Display.SchDoc, GRAF_MNP.PcbDoc, GRAF_MNP.PrjPcb, Power.SchDoc, USB.SchDoc]
2024-10-24 save ist save
    [GRAF_MNP.PcbDoc, USB.SchDoc]
2024-10-25 layout power
    [GRAF_MNP.PcbDoc]
2024-10-27 design Modified DOKU-STUFF/DOKU/Datasheets/Dual Supply - ltc3260.pdf Modified Elektronik/Controller/Controller.SchDoc Modified Elektronik/Controller/GRAF_MNP.PcbDoc
    [Controller.SchDoc, GRAF_MNP.PcbDoc]
2024-10-28 Modified Elektronik/Controller/Controller.SchDoc Modified Elektronik/Controller/ControllerSupply.SchDoc Modified Elektronik/Controller/Display.SchDoc Modified Elektronik/Controller/GRAF_MNP.PcbDoc Mo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
    [Controller.SchDoc, ControllerSupply.SchDoc, Display.SchDoc, GRAF_MNP.PcbDoc, GRAF_MNP.PrjPcb, USB.SchDoc]
2024-10-28 Modified Elektronik/Controller/GRAF_MNP.PcbDoc
    [GRAF_MNP.PcbDoc]
2024-10-28 Modified Elektronik/Controller/Controller.SchDoc Modified Elektronik/Controller/GRAF_MNP.PcbDoc
    [Controller.SchDoc, GRAF_MNP.PcbDoc]
2024-10-28 Schematic Review Done
    [Connector.SchDoc, Controller.SchDoc, ControllerSupply.SchDoc, Display.SchDoc, GRAF_MNP.PcbDoc, GRAF_MNP.PrjPcb, Power.SchDoc, Top.SchDoc]
2024-10-28 Output Check Done
    [Connector.SchDoc, GRAF_MNP.PcbDoc, GRAF_MNP.PrjPcb, [GRAF-MNP_1.0] BL (Standard).xlsx, [GRAF-MNP_1.0] BLERP (Standard).xlsx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]
2024-10-28 Modified .gitignore Modified Elektronik/Powersupply/Powersupply.PcbDoc Modified Elektronik/Powersupply/Powersupply.PrjPcb Modified Elektronik/Powersupply/Powersupply.SchDoc Added Elektronik/Powersupp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
    [Powersupply.PcbDoc, Powersupply.PrjPcb, Powersupply.SchDoc, [GRAF-MNP Powersupply_1.0] BL (Standard).xlsx, [GRAF-MNP Powersupply_1.0] BLERP (Standard).xlsx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]
2024-11-06 Isvia in Solder Mask Rule hat gefehlt
    [GRAF_MNP.PcbDoc]
2024-11-06 Outputs neu erzeugt
    [[GRAF-MNP_1.0] Gerber.GBL, [GRAF-MNP_1.0] Gerber.GBP, [GRAF-MNP_1.0] Gerber.GBS, [GRAF-MNP_1.0] Gerber.GM1, [GRAF-MNP_1.0] Gerber.GTL, [GRAF-MNP_1.0] Gerber.GTP, [GRAF-MNP_1.0] Gerber.GTS]
2024-11-06 Solder Mask Sliver Rule auf 0.149 gestellt
    [GRAF_MNP.PcbDoc]
2024-11-07 sw adc
2024-11-20 Modified .gitignore Added DOKU-STUFF/DOKU/BL_Mechanik.txt Added DOKU-STUFF/DOKU/RACK_Belegung.xlsx Added Elektronik/Stecker_Pin/Stecker_Pin.SchDoc Added Elektronik/Stecker_Pin/__Previews/Stecker_Pin.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
    [RACK_Belegung.xlsx, Stecker_Pin.SchDoc]
2024-11-22 Modified Elektronik/Stecker_Pin/Stecker_Pin.SchDoc Modified Elektronik/Stecker_Pin/__Previews/Stecker_Pin.SchDocPreview Modified Software/Graf-MNP.pap
    [Stecker_Pin.SchDoc]
2024-11-24 not muchos
    [RACK_Belegung.xlsx, Stecker_Pin.SchDoc]
2024-12-02 DAC tut nicht, ADC lala
2024-12-03 DAC works, 5V!
2024-12-04 ADC tut
    [Controller.SchDoc, GRAF_MNP.PcbDoc, GRAF_MNP.PrjPcb]
2024-12-04 ADC 1:2 geändert, spg.teiler 1+1kOhm getauscht
    [Connector.SchDoc, Controller.SchDoc]
2024-12-04 mit DMA ergänzt, aber es funktioniert nicht
2024-12-04 nix viel
    [Controller.SchDoc]
2024-12-05 STM32 Works....
2024-12-09 okay DAC, ADC, OK encoder nur Z-Ax
2024-12-15 schaut zum funktionieren. spg änderung automatisch läuft durch ADC_task.c taster Up und Dwn als Relaisfreigabe
    [Connector.SchDoc, Controller.SchDoc, Stecker_Pin.SchDoc]
2025-01-02 Modified Software/GRAF_MNPA/.cproject Modified Software/GRAF_MNPA/Core/Inc/main.h Modified Software/GRAF_MNPA/Core/Inc/stm32f7xx_it.h Missing Software/GRAF_MNPA/Core/Src/ADC_task.c Missing Software/G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
    [GRAF_MNPA.ioc, PID_Control.c, PID_Control.h, Reference_Run.c, Reference_Run.h, encoder.c, main.c, main.h]
2025-01-03 jetzt vielleicht geht A-ax PID_Control.c
    Modified Software/GRAF_MNPA/.cproject
    Modified Software/GRAF_MNPA/Core/Inc/stm32f7xx_it.h
    Modified Software/GRAF_MNPA/Core/Src/AAXIS_TASK.c
    Modified Software/GRAF_MNPA/Core/Src/PID_Control.c
    Modified Software/GRAF_MNPA/Core/Src/PID_Control.h
    Modified Software/GRAF_MNPA/Core/Src/Reference_Run.c
    Modified Software/GRAF_MNPA/Core/Src/Reference_Run.h
    Modified Software/GRAF_MNPA/Core/Src/encoder.c
    Modified Software/GRAF_MNPA/Core/Src/main.c
    Modified Software/GRAF_MNPA/Core/Src/stm32f7xx_hal_msp.c
    Modified Software/GRAF_MNPA/Core/Src/stm32f7xx_it.c
    Modified Software/GRAF_MNPA/GRAF_MNPA.ioc
2025-01-03 PID regler an a-axis tut
2025-01-03 PID bei Z geht so lala
2025-01-05 ich bin mit adc dran
2025-01-05 soweit okay, jetzt kommt dma versuch prüfprogramm
2025-01-07 Z- fährt hoch runter, PID besser
2025-01-07 Modified Software/GRAF_MNPA/Core/Src/main.c Modified Software/GRAF_MNPA/Core/Src/stm32f7xx_hal_msp.c Modified Software/GRAF_MNPA/GRAF_MNPA.ioc
2025-01-09 LiTh hat geschafft! Modified Software/GRAF_MNPA/Core/Inc/stm32f7xx_it.h Modified Software/GRAF_MNPA/Core/Src/ADC_read.c Modified Software/GRAF_MNPA/Core/Src/PID_Control.c Modified Software/GRAF_MNPA/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
2025-01-12 adc umbau kezdodik
2025-01-12 ADC auf uint16 geändert, schaut gut aus
2025-01-13 NO-sen : I/O Drucksensor: ADC
2025-01-14 vor dem PID vekack
2025-01-17 Alt und Neu mode gemischt funktioniert, Drucksensor als ADC wieder zurück, ich kann ioc ändern
2025-01-20 Ich werde die DS auf GPIO setzen
2025-01-20 Status im WinFenster ADC besser, DS auslöst (neha)
2025-01-21 jetzt werde ich mit pid versuchen, dass es mit spannung bewegt
2025-01-22 PID versuch
2025-01-22 cih versuche organisieren die sachen jetzt
2026-07-21 Copilot hat geändert, in 2 tool programmiert. Ein push bevor ich die beide ordner lösche und verbinde
    Modified Software/GRAF_MNPA/.settings/language.settings.xml
    Modified Software/GRAF_MNPA/Core/Src/ADC_read.c
    Modified Software/GRAF_MNPA/Core/Src/data_buffer.c
    Modified Software/GRAF_MNPA/Core/Src/display.c
    Modified Software/GRAF_MNPA/Core/Src/encoder_performance.c
    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
2026-07-21 KI hat die Timing stabiler gemacht, hoch-runter steppen funktioniert besser und bleibt nicht hängen nach längeres steh-zeit
    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
2026-07-21 Besser Optimiert, kann man nur in IDLE ode Start State steppen und in Fehler - Completed usw nicht mehr
    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
2026-08-26 pid angepasst, vieles kann man einstellein, preset speichern, laden löschen
2026-08-26 pid werte sind vorhanden und begrenzung auch beim steppen. jetzt komtt 2 pid test
2026-08-26 ergänzt mit separate fenster fpr pid und einstellungen
2026-08-31 gerade mit 3 pid , große baustelle mit Kaskadenregelung kommt
2026-09-02 ein save, falls die rückkehr falsch lauft
2026-09-02 Save falls die reinigung schief läuft
2026-09-03 Revert "TOP gerade"
    This reverts commit a77ef60524c88361c41105951bb8bcb21bdd3828.
    # Conflicts:
    # SW_WIN/.vs/SW_WIN.slnx/v18/.wsuo
    # SW_WIN/.vs/slnx.sqlite
    Putzt schritt 1.
    [main.c, test_run.c]
2026-09-04 updated UI, noch funktionierende test aber mit SLOW BUG
    [main.c, test_run.c, test_run.h]
2026-09-07 Save, wegen überschwing die brems-anpassungen
2026-09-09 MeilenSTein mit logo und schnikkschnakk und alles
2026-09-09 fix(quality): Warnungen bereinigt, Serial-Empfang thread-safe mit Lock, UART-Block-Empfang, ADC-Clean
    [ADC_read.c, main.c]
2026-09-09 feat(test-run): Phase B Calib Settle mit sanfter Entlastung, Dwell-Zeit & Release-Check; SemVer 1.1.1
    - Sanfte Entlastung auf Kontaktposition (+10 inc Freihub) mit Geschwindigkeitsstufe 2 nach Messbereichsaufnahme (PHASE_B_CALIB_DEFLECT)
    - 400 ms Dwell-Zeit (Ausschwingen Mechanik, EMA-Filter, GUI-Anzeige)
    - Freigabe der High-Speed Zyklen erst bei ds_value < s_ds_trigger_threshold
    - 1500 ms Timeout-Schutz gegen klemmende Nadel
    - Versionierung synchron auf 1.1.1 (Firmware, WPF-GUI, Mimot-Prüfbericht)
    - Regelwerk CLAUDE.md um Release- und SemVer-Workflow ergaenzt
2026-09-10 feat(firmware): 2-stufen-bremsung, freiflug-absicherung und 1ms-trace-taktung
2026-09-10 fix(safety): Spannungs-Deckel und Headroom-Schutz wiederhergestellt; feat: Ruckbegrenzung Soll-Geschwindigkeit
    - TestRun_SetTriggerDeltaMv: Deckel zurueck auf 4700mV (war auf 4000mV abgesenkt)
    - TestRun_InitEx: Headroom-Pruefung wiederhergestellt (baseline+delta <= 4050 Counts, verhindert ADC-Clipping)
    - Z_Axis_PIDControl: Ruckbegrenzung (VELOCITY_SLEW_RATE_INC_MS2=5.0) auf Soll-Geschwindigkeit,
    verhindert Sprung 0->Stufenmaximum bei Zielsprung/Richtungswechsel (Streuungs-Test Gefaehrdungsstufe Schritt 1)
    - PHASE_B_CALIB_DEFLECT/SETTLE bewusst NICHT wiederhergestellt (Ruecksprache mit Nutzer)
2026-09-10 fix(firmware): Ruckbegrenzung asymmetrisch - Bremsautoritaet nie drosseln
    Die in 7b4e3f0 eingeführte Ruckbegrenzung war symmetrisch und hat damit auch
    das Abbremsen verlangsamt. Das verhindert, dass die Bremszonen-Logik vor
    Kontakt rechtzeitig auf Schleichgang herunterbremst - laut Trace-Analyse
    (Stufe13) stieg die Restgeschwindigkeit am Kontaktpunkt dadurch von -12 auf
    -48 Inc/ms und das Übertravel in das Messobjekt von ~15 auf ~130 Inc
    (stärkeres Klopfen statt Verbesserung).
    Fix: Begrenzung gilt nur noch fürs Beschleunigen (Betrag steigt, gleiche
    Richtung). Bremsen bzw. Richtungswechsel (Betrag sinkt) bleibt immer sofort
    verfügbar.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
2026-09-10 chore(version): SemVer Patch -> 1.1.2, Versionsverwaltung vereinheitlicht
    - FIRMWARE_VERSION in main.h ergaenzt (fehlte bisher komplett auf main)
    - MnpControl.csproj: Version/AssemblyVersion/FileVersion ergaenzt (fehlten bisher)
    - MimotReportGenerator.cs: SoftwareVersion-Konstante eingefuehrt (ersetzt 3x
    hartcodiertes 'V1.0', das seit Langem hinter MainWindow.xaml's 'V1.1.1'
    zurueckgeblieben war)
    - MainWindow.xaml Titel/Footer von V1.1.1 auf V1.1.2
    Hintergrund: asymmetrische Ruckbegrenzung Soll-Geschwindigkeit korrigiert
    und per Trace bestaetigt (Stufe16 - kein Klopfen mehr, siehe 525c12a).
2026-09-11 feat(test-run): Zyklus-Deltas im RAM sammeln statt live per UART senden
2026-09-11 feat: harmonisierte 1+N+1 architektur, sanfte abschlussfahrt, mimot-bericht und ram-pufferung auf main
2026-09-14 feat(firmware/ui): schlittenspezifischer parameterspeicher in flash sektor 7
    - Flash-Sektor 7 (256 KB) EEPROM-Emulation mit Rolling-Slot Architektur (1024 Slots x 256 Bytes, CRC-32)
    - Linker-Script: Flash auf 768 KB begrenzt, um Sektor 7 (ab 0x080C0000) hard gegen Code-Platzierung zu schuetzen
    - Schlitten-Profile (z. B. Schlitten A mit Landebahn 60 inc, Stufe 4 gegen Haftreibung; Schlitten B / Standard mit 150 inc, Stufe 3)
    - UART-Kommandos: CMD:GET_CONFIG (CFG?), CMD:SET_CONFIG:..., CMD:SAVE_CONFIG (CFG_SAVE), CMD:LOAD_DEFAULT
    - test_run.c: Nutzt dynamisch konfigurierte landing_zone_margin, landing_speed_level und braking_dist_factor
    - MnpControl WPF GUI: Nadelschlitten-Profil Card mit Schn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
2026-09-14 feat(firmware/ui): automatische Nadelschlitten-Erkennung und Diagnose-Summary (Variante A)
    - test_run: Erfassung von Stillstand (Haftreibung), Landedauer und Schleppfehler auf der Landebahn
    - Auto-Klassifizierung in Zyklus 1: Schlitten A (Haftreibung) vs. Schlitten B (Leichtgaengig)
    - Auto-Adaption: Schaltet bei Schlitten A mit DEFAULT-Profil automatisch ab Zyklus 2 auf LZ=60 und Stufe 4 um
    - main.c: TEST_B_SUMMARY Telegramm um Diagnose-Werte erweitert (ns_type, ns_stall, ns_time, ns_lag, ns_auto)
    - MnpControl: Detaillierte Ausgabe der Schlitten-Messwerte & Empfehlung im Summary-Block
    - tests/test_carriage_config.ps1: 17/17 Tests erfolgreich
2026-09-14 refactor(ui): Schnellauswahl auf DEFAULT (Auto-Erkennung) reduziert und Speed-Presets entfernt
    - Speed-Preset Buttons (Mimot 13, Stress 15, Max 16) entfernt; Tempo erfolgt direkt per Schieberegler
    - Nadelschlitten-Profile auf prominenten DEFAULT (Auto-Erkennung) Button gestrafft
    - Manuelle Parameterfelder bleiben voll erhalten
2026-09-14 feat(firmware/ui): Pre-Trigger-Ringspeicher & Reibungs-/Stick-Slip-Diagnose (Phase 2)
    - Firmware: 2000-Sample zirkulaerer Pre-Trigger-Ringspeicher im SRAM (TRACE_MODE_RING) mit automatischem Freeze bei Stopp (q), Sensorfehler (TESTRUN_ERROR) und Testende
    - Trace_DumpUART() fuer chronologischen Dump mit monoton steigendem rel_ms
    - Condition Monitoring: Messung von Stick-Slip-Losbrechspannung ss_u auf der Landebahn, Gleitreibung glide_u im Freiflug (z=1400..2600) und Hebelprellen
    - Automatische Mechanik-Gesundheitsampel (1=GRUEN, 2=GELB, 3=ROT) im TEST_B_SUMMARY Telegramm
    - WPF GUI: Ausgabe der Mechanik-Diagnose und Ampelbewertung in MnpControl
    - Tests: 8 neue Checks fuer Ringpuffer-Chronologi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
2026-09-14 fix(firmware/ui): uebertrage tatsaechlich adaptierte Kinematikwerte im Summary-Telegramm
    - Firmware: TestRun_GetScatterStats() erfasst active_landing_zone und active_landing_speed
    - main.c: TEST_B_SUMMARY uebertraegt bei ns_lz und ns_ls die effektiven Kinematikwerte statt der unveraenderten Flash-Defaultwerte
    - WPF GUI: Zeigt bei Auto-Adaption klar 'adaptiert auf LZ=60 inc, Stufe 4' und aktualisiert die Eingabefelder
2026-09-14 feat(ui): Nadelschlitten-Profil in separates Pop-Up-Fenster umgestellt
    - CarriageProfileWindow.xaml/.cs: Eigenstaendiges Dialogfenster fuer Nadelschlitten-Profil (DEFAULT-Button, Landebahn, Kriech-Stufe, Flash-Zyklen, Laden/Anwenden/Speichern)
    - MainWindow.xaml: Aufgeraeumte Card mit 'Nadelschlitten-Profil oeffnen...' Button analog zum Kaskaden-PID-Tuning
    - MainWindow.xaml.cs: Zwei-Wege-Echtzeitsynchronisation zwischen Hauptfenster und Pop-Up-Dialog
2026-09-14 style(ui): formatiere Zeilenumbrueche in CarriageProfileWindow
2026-09-14 feat(bootloader): Phase 3 In-Field Bootloader und USB/UART Firmware-Update Flasher
2026-09-14 fix(firmware): setze FLASH-Origin auf 0x08000000 zurueck fuer direktes Flashen in STM32CubeIDE
2026-09-14 refactor(encoder): vereinfache Encoder-Erfassung auf direkte 32-Bit-Registerzugriffe
    - Direkte atomare 32-Bit-Zugriffe auf TIM2->CNT (A-Achse) und TIM5->CNT (Z-Achse)
    - Entferne unnoetige PeriodElapsedCallback-Overflow-Logik und Interrupt-Sperren
    - Bereinige TIM5 Filter (IC1/IC2Filter von 15 auf 3) und CounterMode (UP) in main.c & .ioc
    - Entferne encoder_performance Benchmark-Code und verwaiste Legacy-Dateien (-40 KB RAM)
    - 28/28 Carriage Config & Flash Verification Tests bestanden
2026-09-14 refactor(peripherals): optimiere ADC-, SPI- und Timer-Konfiguration
    - Schalte ADC1 auf autonomen Continuous-Mode: Einmaliger Start bei Boot, direkter Registerzugriff auf ADC1->DR (5 ns statt 5 ms Polling)
    - Haerte SPI4-Timeout in ad5684_set_voltage von 2000 ms auf 1 ms, entferne doppelte Init-Uebertragung
    - Setze SysTick auf NVIC-Prioritaet 0 und fixiere 1-ms-Scheduler-Kadenz gegen Phasenschlupf
    - Entferne ungenutzte Timer TIM1, TIM3 und TIM4 aus .ioc, main.c, hal_msp.c und stm32f7xx_it.c (-403 Zeilen Netto-Diff)
    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
2026-09-14 fix(adc): behebe Sensor-Einfrieren durch STM32F7 OVR-Flag
    - Setze ContinuousConvMode und ScanConvMode auf DISABLE (verhindert autonomen Hardware-Overrun im 1-MHz-Takt)
    - Starte ADC-Wandlung gezielt on-demand in ADC_Drucksensor() mit sauberem EOC-Polling (1.0 us Wandlungsdauer)
    - Entferne vorzeitigen HAL_ADC_Start(&hadc1) aus main()
    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
2026-09-14 perf(gui): behebe C#-Warnungen, buendele seriellen Empfang und friere Brushes ein
2026-09-15 fix(profile): enable carriage profile selection and prevent auto-override from erasing user settings
2026-09-15 fix(bounce): only flag bounce if carriage is still down at workpiece
2026-09-15 feat(diagnose): remove condition monitoring, add speed level to summary, and make carriage diagnosis speed-aware
2026-09-15 fix(braking): drop auto-override and brake directly to landing speed in kinetic zone
2026-09-15 refactor(kinematics): restore v1.2.0 universal 3-zone braking and remove carriage profile over-engineering
2026-09-15 fix(test-run): raise repetitive cycle landing speed to level 4 to prevent friction stalls
2026-11-03 chore(tooling): update VS Code paths to CubeIDE 2.2.0 and untrack language.settings.xml
    - .vscode/settings.json: cubeidec and STM32_Programmer_CLI now point to CubeIDE 2.2.0
    - language.settings.xml was ignored but still tracked, so every build showed it as modified;
    remove it from the index and drop the non-working absolute-path ignore entries
2026-11-03 docs(claude): drop worktree sync rule, note how Debug/ makefiles are generated
    The stm32-vscode-build-flash worktree was only a manual backup folder and no longer exists.
2026-11-03 fix: 15 s probe timeout in Test B setup and correct SNO limit in report (v1.2.1)
    - test_run.c: PHASE_B_SETUP_SLOW_PROBE aborts with "Antast-Timeout 15s" if no
    contact within 15 s (documented in CLAUDE.md but never implemented)
    - MimotReportGenerator: SNO upper limit printed as 3450 inc (was 3400 while
    the check used 3450), TXT and HTML
    - Version 1.2.1 in firmware, csproj, window title and report
    Tested on hardware: reference run, Test B and report OK.
